Tomoshibi-technology/MovingDisplay3-Circuit/買い物リスト2.xlsx

種類 | 備考 | 備考 | 備考 | 1台当たりの個数 | 在庫 | 購入数 | 単価 | 小計 | URL
積セラ | 10uF | 50V | 2012 |  |  | 20 | 0.067 | 1.34 | https://lcsc.com/product-detail/Multilayer-Ceramic-Capacitors-MLCC-SMD-SMT_muRata-GRM21BR61H106KE43L_C440198.html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
積セラ | 100uF | 6.3V | 3216 |  |  | 20 | 0.067 | 1.34 | https://lcsc.com/product-detail/Multilayer-Ceramic-Capacitors-MLCC-SMD-SMT_Samsung-Electro-Mechanics-CL31A107MQHNNNE_C15008.html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
ヒューズボックス | ミゼット |  | 3568 | 1 | 4 | 5 | 1.2 | 6 | https://www.digikey.jp/ja/products/detail/keystone-electronics/3568/2137306
DF40コネクタ |  |  | DF40C-60DS-0.4V(51) | 2 | 4 | 10 | 0.4304 | 4.304 | https://lcsc.com/product-detail/Board-to-Board-and-Backplane-Connector_HRS-Hirose-DF40C-60DS-0-4V-51_C597938.html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
DF40コネクタ |  |  | DF40C-100DS-0.4V(51) | 2 | 4 | 10 | 0.7947 | 7.947 | https://lcsc.com/product-detail/Board-to-Board-and-Backplane-Connector_HRS-Hirose-DF40C-100DS-0-4V-51_C597931.html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
ボックスヘッダ | ヘッダ | 2 x 7P / H / 1.27mm / THT | 3220-14-0200-00 | 9 | 9 | 40 | 0.977 | 39.08 | https://www.digikey.jp/ja/products/detail/cnc-tech/3220-14-0200-00/3882957
MiniSPOX | ポスト | 2P / V | 22035025 | 4 | 9 | 30 | 0.165 | 4.95 | https://www.digikey.jp/ja/products/detail/molex/0022035025/403301?s=N4IgTCBcDa5gDAZgKzzMkBdAvkA
MiniSPOX | ポスト | 2P / H | 22057025 | 9 | 16 | 50 | 0.177 | 8.85 | https://www.digikey.jp/ja/products/detail/molex/0022057025/403341?s=N4IgTCBcDa5gDAVgOzzIkBdAvkA
MiniSPOX | ポスト | 3P / H | 22057035 | 4 | 50くらい | 0 |  | 0 | https://lcsc.com/product-detail/Wire-To-Board-Connector_MOLEX-22057035_C185225.html?s_z=n_MOLEX%252022057035
MiniSPOX | ハウジング | 2P | 50375023 | 13 | 25 | 80 | 0.0219 | 1.752 | https://lcsc.com/product-detail/Housings-Wire-To-Board-Wire-To-Wire_MOLEX-50375023_C142370.html?s_z=n_spox
MiniSPOX | ハウジング | 3P | 50375033 | 4 | 50くらい | 0 |  | 0 | https://lcsc.com/product-detail/Housings-Wire-To-Board-Wire-To-Wire_MOLEX-50375033_C293596.html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
MiniSPOX | コンタクト |  | 8701039 |  |  | 0 |  | 0
PicoBlade | ポスト | 2P / H |  | 2 |  | 50 | 0.0148 | 0.74 | https://lcsc.com/product-detail/Wire-To-Board-Connector_Hong-Cheng-HCZZ0001-2_C7433453.html?s_z=n_C7433453
PicoBlade | ポスト | 3P / V |  | 1 |  | 20 | 0.0184 | 0.368 | https://lcsc.com/product-detail/Wire-To-Board-Connector_Hong-Cheng-HCZZ0015-3_C7433469.html?s_z=n_C7433469
PicoBlade | ポスト | 3P / H |  | 1 |  | 50 | 0.0176 | 0.88 | https://lcsc.com/product-detail/Wire-To-Board-Connector_Hong-Cheng-HCZZ0001-3_C7433454.html?s_z=n_C7433454
PicoBlade | ポスト | 4P / H |  | 1 |  | 20 | 0.0212 | 0.424 | https://lcsc.com/product-detail/Wire-To-Board-Connector_Hong-Cheng-HCZZ0001-4_C7433455.html?s_z=n_C7433455
PicoBlade | ポスト | 5P / H |  | 10 | 19 | 40 | 0.0241 | 0.964 | https://lcsc.com/product-detail/Wire-To-Board-Connector_Hong-Cheng-HCZZ0001-5_C7433456.html?s_z=n_C7433456
PicoBlade | ポスト | 6P / V |  | 2 | 50 | 0 | 0.0284 | 0 | https://lcsc.com/product-detail/Wire-To-Board-Connector_Hong-Cheng-HCZZ0015-6_C7433472.html?s_z=n_C7433472
PicoBlade | ポスト | 6P / H |  | 4 | 56 | 0 | 0.0275 | 0 | https://lcsc.com/product-detail/Wire-To-Board-Connector_Hong-Cheng-HCZZ0001-6_C7433457.html?s_z=n_C7433457
PicoBlade | ポスト | 8P / V |  | 2 |  | 20 | 0.0338 | 0.676 | https://lcsc.com/product-detail/Wire-To-Board-Connector_Hong-Cheng-HCZZ0015-8_C7433474.html?s_z=n_C7433474
PicoBlade | ポスト | 8P / H |  | 1 |  | 20 | 0.0323 | 0.646 | https://lcsc.com/product-detail/Wire-To-Board-Connector_Hong-Cheng-HCZZ0001-8_C7433459.html?s_z=n_C7433459
PicoBlade | ハウジング | 2P |  | 2 |  | 50 | 0.0139 | 0.695 | https://lcsc.com/product-detail/Housings-Wire-To-Board-Wire-To-Wire_MOLEX-510210200_C293613.html?s_z=n_C293613
PicoBlade | ハウジング | 3P |  | 2 |  | 15 | 0.136 | 2.04 | https://www.digikey.jp/ja/products/detail/molex/0510210300/242843?s=N4IgTCBcDaIKwEYAMZkGYlJAXQL5A
PicoBlade | ハウジング | 4P |  | 1 |  | 50 | 0.0201 | 1.005 | https://lcsc.com/product-detail/Housings-Wire-To-Board-Wire-To-Wire_MOLEX-510210400_C504988.html?s_z=n_C504988
PicoBlade | ハウジング | 5P |  | 10 | 20 | 40 | 0.0268 | 1.072 | https://lcsc.com/product-detail/Housings-Wire-To-Board-Wire-To-Wire_MOLEX-510210500_C192632.html?s_z=n_C192632
PicoBlade | ハウジング | 6P |  | 6 | 50 | 0 | 0.0251 | 0 | https://lcsc.com/product-detail/Housings-Wire-To-Board-Wire-To-Wire_MOLEX-510210600_C385105.html?s_z=n_C385105
PicoBlade | ハウジング | 8P |  | 3 |  | 40 | 0.0243 | 0.972 | https://lcsc.com/product-detail/Housings-Wire-To-Board-Wire-To-Wire_MOLEX-510210800_C385106.html?s_z=n_C385106
PicoBlade | コンタクト |  |  |  |  | 750 | 0.0072 | 5.4 | https://lcsc.com/product-detail/Housing-Contact_MOLEX-500798001_C20003452.html?s_z=n_500798001
コイル | 1uH |  | 3225 | 1 |  | 10 | 0.271 | 2.71 | https://www.digikey.jp/ja/products/detail/vishay-dale/IHLP1210BZEZ1R0M5A/25589291
コイル | 3.3uH |  |  | 1 |  | 10 | 0.425 | 4.25 | https://www.digikey.jp/ja/products/detail/ecs-inc/ECS-MPIL0530-3R3MC/8021589
NchFET | 中電流用 | 中耐圧 | TPN11006PL | 24 | 94 | 40 | 0.696 | 27.84 | https://www.digikey.jp/ja/products/detail/toshiba-semiconductor-and-storage/TPN11006PL-LQ/10447100
PchFET | 中電流用 | 中耐圧 | DI035P04PT | 8 | 8 | 40 | 0.548 | 21.92 | https://www.digikey.jp/ja/products/detail/diotec-semiconductor/DI035P04PT/16640416
PchFET | 大電流用 | 中耐圧 | SQS141ELNW | 2 |  | 16 | 0.927 | 14.832 | https://www.digikey.jp/ja/products/detail/vishay-siliconix/SQS141ELNW-T1-GE3/16639865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
抵抗 | 100Ω |  | 1005 |  |  | 100 | 0.0006 | 0.06 | https://lcsc.com/product-detail/Chip-Resistor-Surface-Mount_UNI-ROYAL-0402WGF1000TCE_C25076.html?s_z=n_c25076
抵抗 | 330Ω |  | 1005 |  |  | 100 | 0.0006 | 0.06 | https://lcsc.com/product-detail/Chip-Resistor-Surface-Mount_UNI-ROYAL-0402WGF3300TCE_C25104.html?s_z=n_c25104
抵抗 | 510Ω |  | 1005 |  |  | 100 | 0.0006 | 0.06 | https://lcsc.com/product-detail/Chip-Resistor-Surface-Mount_UNI-ROYAL-0402WGF5100TCE_C25123.html?s_z=n_c25123
抵抗 | 0.1Ω |  | 2012 | 2 |  | 100 | 0.0042 | 0.42 | https://lcsc.com/product-detail/Chip-Resistor-Surface-Mount_UNI-ROYAL-0805W8F100LT5E_C127687.html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
スイッチ | スライド | SPDT / SMD / 小 / 横 / 黒 | SSAJ120100 | 5 | 3 | 30 | 0.4011 | 12.033 | https://lcsc.com/product-detail/Slide-Switches_ALPSALPINE-SSAJ120100_C160864.html?s_z=n_SSAJ120100
スイッチ | スライド | DPDT / SMD / 小 / 縦 / 黒 | SSSS820101 | 7 | 4 | 50 | 0.2103 | 10.515 | https://lcsc.com/product-detail/Slide-Switches_ALPSALPINE-SSSS820101_C97434.html?s_z=n_SSSS820101%2520
スイッチ | 4PDIP | SPST x 4 / SMD |  | 8 | 3 | 50 | 0.27 | 13.5 | https://lcsc.com/product-detail/DIP-Switches_hanxia-HX-1-27-4P-TPPT_C7430300.html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
IC | エンコーダー |  | AS5047P | 4 | 9 | 15 | 3.109 | 46.635 | https://lcsc.com/product-detail/Position-Sensors_AMS-AS5047P-ATSM_C962063.html
IC | DCDC |  | TPS54560B |  |  | 5 | 1.111 | 5.555 | https://lcsc.com/product-detail/DC-DC-Converters_TI-TPS54560BDDAR_C1850354.html?s_z=n_C1850354
 |  |  |  |  |  |  | 合計(ドル) | 251.835
 |  |  |  |  |  | 148.49 | 合計(円) | 37394.97915
