Tomoshibi-technology/MovingDisplay3-Circuit/買い物リスト3.xlsx

種類 | 備考 | 備考 | 備考 | 1台当たりの個数 | 購入数 | 単価 | 小計 | URL
積セラ | 10uF | 35V | 2012 | 8 | 4 | 150 | 600 | https://akizukidenshi.com/catalog/g/g113336/
積セラ | 22uF | 25V | 2012 | 4 | 2 | 120 | 240 | https://akizukidenshi.com/catalog/g/g108240/
電解コン | 47uF | 25V |  | 6 | 5 | 90 | 450 | https://akizukidenshi.com/catalog/g/g117577/
電解コン | 100uF | 25V |  | 10 | 50 | 10 | 500 | https://akizukidenshi.com/catalog/g/g117877/
電解コン | 330uF | 25V |  | 2 | 2 | 100 | 200 | https://akizukidenshi.com/catalog/g/g106978/
高分子コン | 330uF | 6.3V |  | 1 | 6 | 160 | 960 | https://akizukidenshi.com/catalog/g/g117295/
LED | 黄緑 |  |  | 5 | 2 | 100 | 200 | https://akizukidenshi.com/catalog/g/g111877/
LED | 緑 |  |  | 19 | 9 | 100 | 900 | https://akizukidenshi.com/catalog/g/g111878/
LED | 青 |  |  | 34 | 3 | 200 | 600 | https://akizukidenshi.com/catalog/g/g103982
LED | 青 |  |  | 34 | 1 | 800 | 800 | https://akizukidenshi.com/catalog/g/g111811/
ショットキー | 2A |  | SS2040FL | 31 | 6 | 480 | 2880 | https://akizukidenshi.com/catalog/g/g102073/
ショットキー | 10A |  | MA10EB045 | 1 | 3 | 80 | 240 | https://akizukidenshi.com/catalog/g/g117496/
ショットキー | 小信号 |  | CUS10F30 | 5 | 2 | 150 | 300 | https://akizukidenshi.com/catalog/g/g107687/
コイル | 1uH | 1608 |  | 7 | 6 | 110 | 660 | https://akizukidenshi.com/catalog/g/g114975/
ピンヘッダ | ヘッダ | 2 x 13P / V / 1.27mm / THT |  | 4 | 20 | 50 | 1000 | https://akizukidenshi.com/catalog/g/g113802/
ピンソケット | ソケット | 2 x 13P / V / 1.27mm / THT |  | 4 | 20 | 70 | 1400 | https://akizukidenshi.com/catalog/g/g113808/
ピンヘッダ | ヘッダ | 1 x 10P / V / 1.27mm / THT |  | 1 | 2 | 90 | 180 | https://akizukidenshi.com/catalog/g/g103865/
ピンソケット | ソケット | 1 x 10P / V / 1.27mm / THT |  | 1 | 5 | 30 | 150 | https://akizukidenshi.com/catalog/g/g108695/
ピンヘッダ | ヘッダ | 2 x 10P / V / 1.27mm / THT |  | 1 | 5 | 45 | 225 | https://akizukidenshi.com/catalog/g/g113801/
ピンソケット | ソケット | 2 x 10P / V / 1.27mm / THT |  | 1 | 5 | 60 | 300 | https://akizukidenshi.com/catalog/g/g113807/
RJ45 |  |  | LPJK7001AGNL | 1 | 5 | 300 | 1500 | https://akizukidenshi.com/catalog/g/g116963/
PchFET | 中電流用 | 中耐圧 | SSM6J808RR | 8 | 8 | 100 | 800 | https://akizukidenshi.com/catalog/g/g115504/
PchFET | 大電流用 |  | MTP4835I3 | 2 | 5 | 30 | 150 | https://akizukidenshi.com/catalog/g/g116096/
NchFET | 中電流用 | 中耐圧 | SSM3K344R | 1 | 1 | 100 | 100 | https://akizukidenshi.com/catalog/g/g117434/
シャント抵抗 | 7mΩ | 1W |  | 12 | 5 | 50 | 250 | https://akizukidenshi.com/catalog/g/g106688/
抵抗 | 10Ω | 2W | 6332 | 2 | 1 | 140 | 140 | https://akizukidenshi.com/catalog/g/g109457/
スイッチ | タクト | SPST / THT / 小 / 横 / 白 |  | 4 | 4 | 100 | 400 | https://akizukidenshi.com/catalog/g/g114890/
スイッチ | タクト | SPST / SMD / 小 / 縦 / 白 | SKRPABE010 | 5 | 5 | 120 | 600 | https://akizukidenshi.com/catalog/g/g106184/
スイッチ | スライド | SPDT / THT / 大 / 縦 / 黒 | SS22F06G5-G | 1 | 5 | 30 | 150 | https://akizukidenshi.com/catalog/g/g103252/
三端子 | 3.3V |  | AZ1117CH | 7 | 30 | 30 | 900 | https://akizukidenshi.com/catalog/g/g116155/
コンパレータ |  |  | NJU7109 | 1 | 5 | 45 | 225 | https://akizukidenshi.com/catalog/g/g114720/
コンパレータ |  |  | NJU77242 | 1 | 5 | 70 | 350 | https://akizukidenshi.com/catalog/g/g114989/
オペアンプ |  |  | NJM2732 | 1 | 5 | 70 | 350 | https://akizukidenshi.com/catalog/g/g111238/
基準電圧源 |  |  | NJM2380 | 1 | 5 | 40 | 200 | https://akizukidenshi.com/catalog/g/g114049/
論理ゲート |  |  | 74AHC1G00 | 1 | 1 | 100 | 100 | https://akizukidenshi.com/catalog/g/g117600/
DAC |  |  | PT8211S | 1 | 5 | 100 | 500 | https://akizukidenshi.com/catalog/g/g117061/
FT231XS |  |  |  | 2 | 10 | 320 | 3200 | https://akizukidenshi.com/catalog/g/g106713/
TangPrimer 25K |  |  |  | 1 |  |  | 0
TweLite |  |  |  | 1 | 1 | 1450 | 1450 | https://akizukidenshi.com/catalog/g/g108263/
PIM573 |  |  |  | 1 |  |  | 0
 |  |  |  |  |  |  | 24150
