Tomoshibi-technology/MovingDisplay3-Circuit/買い物リスト1.xlsx

種類 | 備考 | 備考 | 備考 | 1枚当たりの個数 | 購入数 | 単価 | 小計 | URL
電解コン | 47uF | 25V |  | 5 | 2 | 90 | 180 | https://akizukidenshi.com/catalog/g/g117577/
LED | 青 |  |  | 6 | 1 | 200 | 200 | https://akizukidenshi.com/catalog/g/g103982/
LED | 黄緑 |  |  | 2 | 1 | 100 | 100 | https://akizukidenshi.com/catalog/g/g111877/
ショットキー | 小信号 |  | CUS10F30 | 1 | 1 | 150 | 150 | https://akizukidenshi.com/catalog/g/g107687/
ピンヘッダ | ヘッダ / V / THT | 1 x 10P / 1.27mm |  | 1 | 1 | 90 | 90 | https://akizukidenshi.com/catalog/g/g103865/
ピンヘッダ | ヘッダ / V / THT | 2 x 10P / 1.27mm |  | 1 | 2 | 45 | 90 | https://akizukidenshi.com/catalog/g/g113801/
ピンソケット | ソケット / V / THT | 2 x 10P / 1.27mm |  | 1 | 2 | 60 | 120 | https://akizukidenshi.com/catalog/g/g113807/
USB-C | Power Only |  |  | 1 | 5 | 70 | 350 | https://akizukidenshi.com/catalog/g/g116438/
スイッチ | タクト | SPST | SMD / 小 / 縦 / 白 | 4 | 1 | 120 | 120 | https://akizukidenshi.com/catalog/g/g106184/
スイッチ | タクト | SPST | THT / 小 / 縦 / 白 | 1 | 5 | 20 | 100 | https://akizukidenshi.com/catalog/g/g108074/
スイッチ | スライド | SPDT | THT / 中 / 横 / 白 | 1 | 5 | 25 | 125 | https://akizukidenshi.com/catalog/g/g115368/
スイッチ | スライド | SPDT | SMD / 中 / 縦 / 黒 | 1 | 1 | 330 | 330 | https://akizukidenshi.com/catalog/g/g105043/
FT231XS |  |  |  | 1 | 2 | 320 | 640 | https://akizukidenshi.com/catalog/g/g106713/
 |  |  |  |  |  | 総計 | 2595
