Tomoshibi-technology/MovingDisplay3-Circuit/circuits/DCDC/DCDC.xlsx

種類 | 備考 | 備考 | 備考 | 単価 | 1枚当たりの個数 | URL
電解コン | 100uF | 25V |  | 10 | 2 | https://akizukidenshi.com/catalog/g/g117877/
積セラ | 2700pF |  |  | 300 | 1 | https://akizukidenshi.com/catalog/g/g109291/
積セラ | 1500pF |  |  | 300 | 1 | https://akizukidenshi.com/catalog/g/g109288/
高分子コン | 330uF | 6.3V |  | 160 | 1 | https://akizukidenshi.com/catalog/g/g117295/
LED | 緑 |  |  | 100 | 2 | https://akizukidenshi.com/catalog/g/g111878/
ショットキー | 2A |  | SS2040FL | 480 | 2 | https://akizukidenshi.com/catalog/g/g102073/
MiniSPOX | ポスト | 2P / H | 22057025 |  | 5 | https://lcsc.com/product-detail/Wire-To-Board-Connector_MOLEX-22057025_C240819.html?s_z=n_spox
MiniSPOX | ハウジング | 2P | 50375023 |  | 5 | https://lcsc.com/product-detail/Housings-Wire-To-Board-Wire-To-Wire_MOLEX-50375023_C142370.html?s_z=n_spox
MiniSPOX | コンタクト |  | 8701039 |  | 10
PicoBlade | ポスト | 8P / H |  |  | 1 | https://lcsc.com/product-detail/Wire-To-Board-Connector_Hong-Cheng-HCZZ0001-8_C7433459.html?s_z=n_C7433459
PicoBlade | ハウジング | 8P |  |  | 1 | https://lcsc.com/product-detail/Housings-Wire-To-Board-Wire-To-Wire_MOLEX-510210800_C385106.html?s_z=n_C385106
PicoBlade | コンタクト |  |  |  | 22
コイル | 2.2uH |  |  |  | 1 | https://www.mouser.jp/ProductDetail/Panasonic/ETQ-P4M2R2KVK?qs=DddhjTRTMKxtDEQdd9aMKQ%3D%3D
フェライトビーズ | 1800Ω |  |  | 150 | 1 | https://akizukidenshi.com/catalog/g/g110765/
PchFET | 中電流用 | 中耐圧 | SSM6J808RR | 100 | 2 | https://akizukidenshi.com/catalog/g/g115504/
PchFET | 大電流用 |  | MTP4835I3 | 30 | 1 | https://akizukidenshi.com/catalog/g/g116096/
NchFET | 中電流用 | 中耐圧 | TPH11006NL | 200 | 2 | https://akizukidenshi.com/catalog/g/g107361/
スイッチ | スライド | SPDT / THT / 中 / 縦 / 白 | IS-1235-G | 25 | 1 | https://akizukidenshi.com/catalog/g/g115367/
三端子 | 12V |  | NJM78L12S | 30 | 1 | https://akizukidenshi.com/catalog/g/g111322/
オペアンプ |  |  | NJU77701 | 300 | 1 | https://akizukidenshi.com/catalog/g/g107103/
リセットIC |  |  | M51957B | 200 | 1 | https://akizukidenshi.com/catalog/g/g102284/
DCDC IC |  |  | LM3843 | 40 | 1 | https://akizukidenshi.com/catalog/g/g115555/
ゲトドラ |  |  | RT9624A | 60 | 1 | https://akizukidenshi.com/catalog/g/g129592/
