Tomoshibi-technology/MovingDisplay3-Circuit/circuits/Drive/Drive.xlsx

種類 | 備考 | 備考 | 備考 | 単価 | 1枚当たりの個数 | URL
電解コン | 47uF | 25V |  | 90 | 4 | https://akizukidenshi.com/catalog/g/g117577/
電解コン | 100uF | 25V |  | 10 | 2 | https://akizukidenshi.com/catalog/g/g117877/
LED | 緑 |  |  | 100 | 3 | https://akizukidenshi.com/catalog/g/g111878/
LED | 青 |  |  | 200 | 2 | https://akizukidenshi.com/catalog/g/g103982/
LED | 黄緑 |  |  | 100 | 1 | https://akizukidenshi.com/catalog/g/g111877/
LED | 赤 |  |  | 200 | 1 | https://akizukidenshi.com/catalog/g/g103978/
LED | 黄色 |  |  | 100 | 1 | https://akizukidenshi.com/catalog/g/g111880/
ショットキー | 小信号 |  | CUS10F30 | 150 | 1 | https://akizukidenshi.com/catalog/g/g107687/
ショットキー | 2A |  | SS2040FL | 480 | 1 | https://akizukidenshi.com/catalog/g/g102073/
ボックスヘッダ | ヘッダ | 2 x 7P / H / 1.27mm / THT |  |  | 1 | https://www.digikey.jp/ja/products/detail/cnc-tech/3220-14-0200-00/3882957
MiniSPOX | ポスト | 2P / H | 22057025 |  | 5 | https://lcsc.com/product-detail/Wire-To-Board-Connector_MOLEX-22057025_C240819.html?s_z=n_spox
MiniSPOX | ハウジング | 2P | 50375023 |  | 5 | https://lcsc.com/product-detail/Housings-Wire-To-Board-Wire-To-Wire_MOLEX-50375023_C142370.html?s_z=n_spox
MiniSPOX | コンタクト |  | 8701039 |  | 10
PicoBlade | ポスト | 5P / H |  |  | 2 | https://lcsc.com/product-detail/Wire-To-Board-Connector_Hong-Cheng-HCZZ0001-5_C7433456.html?s_z=n_C7433456
PicoBlade | ポスト | 6P / V |  |  | 2 | https://lcsc.com/product-detail/Wire-To-Board-Connector_Hong-Cheng-HCZZ0015-6_C7433472.html?s_z=n_C7433472
PicoBlade | ハウジング | 5P |  |  | 2 | https://lcsc.com/product-detail/Housings-Wire-To-Board-Wire-To-Wire_MOLEX-510210500_C192632.html?s_z=n_C192632
PicoBlade | ハウジング | 6P |  |  | 2 | https://lcsc.com/product-detail/Housings-Wire-To-Board-Wire-To-Wire_MOLEX-510210600_C385105.html?s_z=n_C385105
PicoBlade | コンタクト |  |  |  | 22
USB-C | Power Only |  |  | 70 | 1 | https://akizukidenshi.com/catalog/g/g116438/
コイル | 1uH | 1608 |  | 110 | 1 | https://akizukidenshi.com/catalog/g/g114975/
PchFET | 中電流用 | 中耐圧 | SSM6J808RR | 100 | 2 | https://akizukidenshi.com/catalog/g/g115504/
スイッチ | タクト | SPST / SMD /小 / 縦 / 白 | SKRPABE010 | 120 | 1 | https://akizukidenshi.com/catalog/g/g106184/
スイッチ | タクト | SPST / THT / 小 / 縦 / 白 |  | 20 | 1 | https://akizukidenshi.com/catalog/g/g108074/
スイッチ | スライド | SPDT / THT / 中 / 縦 / 白 | IS-1235-G | 25 | 1 | https://akizukidenshi.com/catalog/g/g115367/
スイッチ | スライド | SPDT / SMD / 中 / 縦 / 黒 | SSSS213202 | 330 | 1 | https://akizukidenshi.com/catalog/g/g105043/
スイッチ | 4PDIP | SPST x 4 / SMD |  |  | 1 | https://lcsc.com/product-detail/DIP-Switches_hanxia-HX-1-27-4P-TPPT_C7430300.html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
三端子 | 3.3V |  | AZ1117CH | 30 | 1 | https://akizukidenshi.com/catalog/g/g116155/
BNO055 |  |  |  |  | 1
PIM573 |  |  |  |  | 1
