Tomoshibi-technology/MovingDisplay3-Circuit/circuits/RasPi/RasPi.xlsx

種類 | 備考 | 備考 | 備考 | 単価 | 1枚当たりの個数 | URL
電解コン | 47uF | 25V |  | 90 | 1 | https://akizukidenshi.com/catalog/g/g117577/
高分子コン | 220uF | 6.3V |  | 120 | 1 | https://akizukidenshi.com/catalog/g/g117360/
積セラ | 10uF | 50V | 2012 |  | 2 | https://lcsc.com/product-detail/Multilayer-Ceramic-Capacitors-MLCC-SMD-SMT_muRata-GRM21BR61H106KE43L_C440198.html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
積セラ |  |  | 1608 |  | 2
LED | 緑 |  |  | 100 | 4 | https://akizukidenshi.com/catalog/g/g111878/
LED | 青 |  |  | 200 | 8 | https://akizukidenshi.com/catalog/g/g103982/
LED | 黄緑 |  |  | 100 | 3 | https://akizukidenshi.com/catalog/g/g111877/
LED | 赤 |  |  | 200 | 2 | https://akizukidenshi.com/catalog/g/g103978/
LED | 黄色 |  |  | 100 | 2 | https://akizukidenshi.com/catalog/g/g111880/
ショットキー | 小信号 |  | CUS10F30 | 150 | 3 | https://akizukidenshi.com/catalog/g/g107687/
ショットキー | 2A |  | SS2040FL | 480 | 1 | https://akizukidenshi.com/catalog/g/g102073/
ショットキー | 10A |  | MA10EB045 | 80 | 1 | https://akizukidenshi.com/catalog/g/g117496/
ボックスヘッダ | ヘッダ | 2 x 7P / H / 1.27mm / THT |  |  | 1 | https://www.digikey.jp/ja/products/detail/cnc-tech/3220-14-0200-00/3882957
PicoBlade | ポスト | 2P / H |  |  | 2 | https://lcsc.com/product-detail/Wire-To-Board-Connector_Hong-Cheng-HCZZ0001-2_C7433453.html?s_z=n_C7433453
PicoBlade | ポスト | 3P / V |  |  | 1 | https://lcsc.com/product-detail/Wire-To-Board-Connector_Hong-Cheng-HCZZ0015-3_C7433469.html?s_z=n_C7433469
PicoBlade | ポスト | 3P / H |  |  | 1 | https://lcsc.com/product-detail/Wire-To-Board-Connector_Hong-Cheng-HCZZ0001-3_C7433454.html?s_z=n_C7433454
PicoBlade | ポスト | 4P / H |  |  | 1 | https://lcsc.com/product-detail/Wire-To-Board-Connector_Hong-Cheng-HCZZ0001-4_C7433455.html?s_z=n_C7433455
PicoBlade | ポスト | 6P / H |  |  | 2 | https://lcsc.com/product-detail/Wire-To-Board-Connector_Hong-Cheng-HCZZ0001-6_C7433457.html?s_z=n_C7433457
PicoBlade | ポスト | 8P / H |  |  | 1 | https://lcsc.com/product-detail/Wire-To-Board-Connector_Hong-Cheng-HCZZ0001-8_C7433459.html?s_z=n_C7433459
PicoBlade | ハウジング | 2P |  |  | 2 | https://lcsc.com/product-detail/Housings-Wire-To-Board-Wire-To-Wire_MOLEX-510210200_C293613.html?s_z=n_C293613
PicoBlade | ハウジング | 3P |  |  | 2 | https://lcsc.com/product-detail/Housings-Wire-To-Board-Wire-To-Wire_MOLEX-510210300_C122445.html?s_z=n_C122445
PicoBlade | ハウジング | 4P |  |  | 1 | https://lcsc.com/product-detail/Housings-Wire-To-Board-Wire-To-Wire_MOLEX-510210400_C504988.html?s_z=n_C504988
PicoBlade | ハウジング | 6P |  |  | 2 | https://lcsc.com/product-detail/Housings-Wire-To-Board-Wire-To-Wire_MOLEX-510210600_C385105.html?s_z=n_C385105
PicoBlade | ハウジング | 8P |  |  | 1 | https://lcsc.com/product-detail/Housings-Wire-To-Board-Wire-To-Wire_MOLEX-510210800_C385106.html?s_z=n_C385106
PicoBlade | コンタクト
XH | ポスト | 2P |  |  | 1
XH | ハウジング | 2P |  |  | 1
XH | コンタクト
ピンソケット | ソケット / V / THT | 1 x 5P / 2.54mm |  |  | 1
RJ45 |  |  | LPJK7001AGNL | 300 | 1 | https://akizukidenshi.com/catalog/g/g116963/
コイル | 1uH |  | 1608 | 110 | 1 | https://akizukidenshi.com/catalog/g/g114975/
コイル | 1uH |  | 3225 |  | 1 | https://www.digikey.jp/ja/products/detail/vishay-dale/IHLP1210BZEZ1R0M5A/25589291
コイル | 3.3uH |  |  |  | 1 | https://www.digikey.jp/ja/products/detail/ecs-inc/ECS-MPIL0530-3R3MC/8021589
PchFET | 中電流用 | 中耐圧 | SSM6J808R | 100 | 2 | https://akizukidenshi.com/catalog/g/g115504/
PchFET | 大電流用 |  | MTP4835I3 | 30 | 2 | https://akizukidenshi.com/catalog/g/g116096/
NchFET | 中電流用 | 中耐圧 | SSM3K344R | 100 | 1 | https://akizukidenshi.com/catalog/g/g117434/
抵抗 | 10Ω | 2W | 6332 | 140 | 2 | https://akizukidenshi.com/catalog/g/g109457/
抵抗 | 0.1Ω |  | 2012 |  | 2 | https://lcsc.com/product-detail/Chip-Resistor-Surface-Mount_UNI-ROYAL-0805W8F100LT5E_C127687.html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
スイッチ | タクト | SPST / SMD /小 / 縦 / 白 | SKRPABE010 | 120 | 1 | https://akizukidenshi.com/catalog/g/g106184/
スイッチ | タクト | SPST / SMD / 中 / 縦 / 黒 |  | 15 | 1 | https://akizukidenshi.com/catalog/g/g103647/
スイッチ | スライド | DPDT / SMD / 小 / 縦 / 黒 | SSSS820101 |  | 2 | https://lcsc.com/product-detail/Slide-Switches_ALPSALPINE-SSSS820101_C97434.html?s_z=n_SSSS820101%2520
スイッチ | スライド | SPDT / SMD / 中 / 縦 / 黒 | SSSS213202 | 330 | 1 | https://akizukidenshi.com/catalog/g/g105043/
スイッチ | スライド | SPST / THT / 中 / 縦 / 黒 |  | 20 | 1 | https://akizukidenshi.com/catalog/g/g115707/
スイッチ | 4PDIP | SPST x 4 / SMD |  |  | 1 | https://lcsc.com/product-detail/DIP-Switches_hanxia-HX-1-27-4P-TPPT_C7430300.html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
Raspberry Pi CM4 |  |  |  |  | 1
FT231XS |  |  |  | 320 | 1 | https://akizukidenshi.com/catalog/g/g106713/
TangPrimer 25K |  |  |  |  | 1
三端子 | 3.3V |  | AZ1117CH | 30 | 1 | https://akizukidenshi.com/catalog/g/g116155/
コンパレータ |  |  | NJU7109 | 45 | 1 | https://akizukidenshi.com/catalog/g/g114720/
コンパレータ |  |  | NJU77242 | 70 | 1 | https://akizukidenshi.com/catalog/g/g114989/
オペアンプ |  |  | NJM2732 | 70 | 1 | https://akizukidenshi.com/catalog/g/g111238/
基準電圧源 |  |  | NJM2380 | 40 | 1 | https://akizukidenshi.com/catalog/g/g114049/
論理ゲート |  |  | 74AHC1G00 | 100 | 1 | https://akizukidenshi.com/catalog/g/g117600/
DAC |  |  | PT8211S | 100 | 1 | https://akizukidenshi.com/catalog/g/g117061/
