Tomoshibi-technology/MovingDisplay3-Circuit/circuits/Imposition/1stLayer_Power/1stLayer_Power.xlsx

種類 | 備考 | 備考 | 備考 | 単価 | 1枚当たりの個数 | URL
電解コン | 330uF | 25V |  |  | 2 | https://akizukidenshi.com/catalog/g/g106978/
LED | 緑 |  |  | 100 | 1 | https://akizukidenshi.com/catalog/g/g111878/
ショットキー | 小信号 |  | CUS10F30 | 150 | 1 | https://akizukidenshi.com/catalog/g/g107687/
ヒューズボックス | ミゼット |  |  |  | 1 | https://www.digikey.jp/ja/products/detail/keystone-electronics/3568/2137306
ボックスヘッダ | ヘッダ | 2 x 7P / H / 1.27mm / THT |  |  | 3 | https://www.digikey.jp/ja/products/detail/cnc-tech/3220-14-0200-00/3882957
ピンソケット | ソケット | 1 x 10P / V / 1.27mm / THT |  |  | 1 | https://akizukidenshi.com/catalog/g/g108695/
XT30 |  |  |  |  | 1
MiniSPOX | ポスト | 2P / V | 22035025 |  | 4 | https://lcsc.com/product-detail/Wire-To-Board-Connector_MOLEX-22057025_C240819.html?s_z=n_spox
MiniSPOX | ハウジング | 2P | 50375023 |  | 4 | https://lcsc.com/product-detail/Housings-Wire-To-Board-Wire-To-Wire_MOLEX-50375023_C142370.html?s_z=n_spox
MiniSPOX | コンタクト |  | 8701039
PicoBlade | ポスト | 8P / V |  |  | 2 | https://lcsc.com/product-detail/Wire-To-Board-Connector_Hong-Cheng-HCZZ0015-8_C7433474.html?s_z=n_C7433474
PicoBlade | ハウジング | 8P |  |  | 2 | https://lcsc.com/product-detail/Housings-Wire-To-Board-Wire-To-Wire_MOLEX-510210800_C385106.html?s_z=n_C385106
PicoBlade | コンタクト
PchFET | 大電流用 | 中耐圧 | SQS141ELNW |  | 2 | https://www.digikey.jp/ja/products/detail/vishay-siliconix/SQS141ELNW-T1-GE3/16639865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
スイッチ | スライド | SPDT / THT / 大 / 縦 / 黒 | SS22F06G5-G |  | 1 | https://akizukidenshi.com/catalog/g/g103252/
