Tomoshibi-technology/MovingDisplay3-Circuit/circuits/Imposition/2ndLayer_3rdLayer/2ndLayer_3rdLayer.xlsx

種類 | 備考 | 備考 | 備考 | 単価 | 1枚当たりの個数 | URL
電解コン | 47uF | 25V |  | 90 | 1 | https://akizukidenshi.com/catalog/g/g117577/
LED | 緑 |  |  | 100 | 3 | https://akizukidenshi.com/catalog/g/g111878/
LED | 青 |  |  | 200 | 4 | https://akizukidenshi.com/catalog/g/g103982/
LED | 黄緑 |  |  | 100 | 1 | https://akizukidenshi.com/catalog/g/g111877/
LED | 赤 |  |  | 200 | 1 | https://akizukidenshi.com/catalog/g/g103978/
LED | 黄色 |  |  | 100 | 1 | https://akizukidenshi.com/catalog/g/g111880/
ショットキー | 2A |  | SS2040FL | 480 | 1 | https://akizukidenshi.com/catalog/g/g102073/
ピンヘッダ | ヘッダ | 1 x 10P / V / 1.27mm / THT |  | 90 | 1 | https://akizukidenshi.com/catalog/g/g103865/
ピンヘッダ | ヘッダ | 2 x 10P / V / 1.27mm / THT |  | 45 | 1 | https://akizukidenshi.com/catalog/g/g113801/
ピンソケット | ソケット | 2 x 10P / V / 1.27mm / THT |  | 60 | 1 | https://akizukidenshi.com/catalog/g/g113807/
PicoBlade | ポスト | 6P / H |  |  | 2 | https://lcsc.com/product-detail/Wire-To-Board-Connector_Hong-Cheng-HCZZ0001-6_C7433457.html?s_z=n_C7433457
PicoBlade | ハウジング | 6P |  |  | 2 | https://lcsc.com/product-detail/Housings-Wire-To-Board-Wire-To-Wire_MOLEX-510210600_C385105.html?s_z=n_C385105
PicoBlade | コンタクト |  |  |  | 12
コイル | 1uH | 1608 |  | 110 | 1 | https://akizukidenshi.com/catalog/g/g114975/
PchFET | 中電流用 | 中耐圧 | SSM6J808RR | 100 | 2 | https://akizukidenshi.com/catalog/g/g115504/
スイッチ | タクト | SPST / SMD / 小 / 縦 / 白 | SKRPABE010 | 120 | 3 | https://akizukidenshi.com/catalog/g/g106184/
スイッチ | タクト | SPST / SMD / 中 / 縦 / 黒 |  | 15 | 3 | https://akizukidenshi.com/catalog/g/g103647/
スイッチ | スライド | SPDT / THT / 中 / 横 / 白 | IS-1245T-G | 25 | 1 | https://akizukidenshi.com/catalog/g/g115368/
スイッチ | スライド | SPDT / SMD / 小 / 横 / 黒 | SSAJ120100 |  | 1 | https://lcsc.com/product-detail/Slide-Switches_ALPSALPINE-SSAJ120100_C160864.html?s_z=n_SSAJ120100
スイッチ | スライド | SPDT / SMD / 小 / 縦 / 黒 | SSSS820101 |  | 1 | https://lcsc.com/product-detail/Slide-Switches_ALPSALPINE-SSSS820101_C97434.html?s_z=n_SSSS820101%2520
スイッチ | 4PDIP | SPST x 4 / SMD |  |  | 2 | https://lcsc.com/product-detail/DIP-Switches_hanxia-HX-1-27-4P-TPPT_C7430300.html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
三端子 | 3.3V |  | AZ1117CH | 30 | 1 | https://akizukidenshi.com/catalog/g/g116155/
TweLite |  |  |  | 1450 | 1 | https://akizukidenshi.com/catalog/g/g108263/
OLED |  |  |  | 580 | 1 | https://akizukidenshi.com/catalog/g/g112031/
FT231XS |  |  |  | 320 | 1 | https://akizukidenshi.com/catalog/g/g106713/
