Tomoshibi-technology/MovingDisplay3-Circuit/circuits/Drive/Drive.pdf

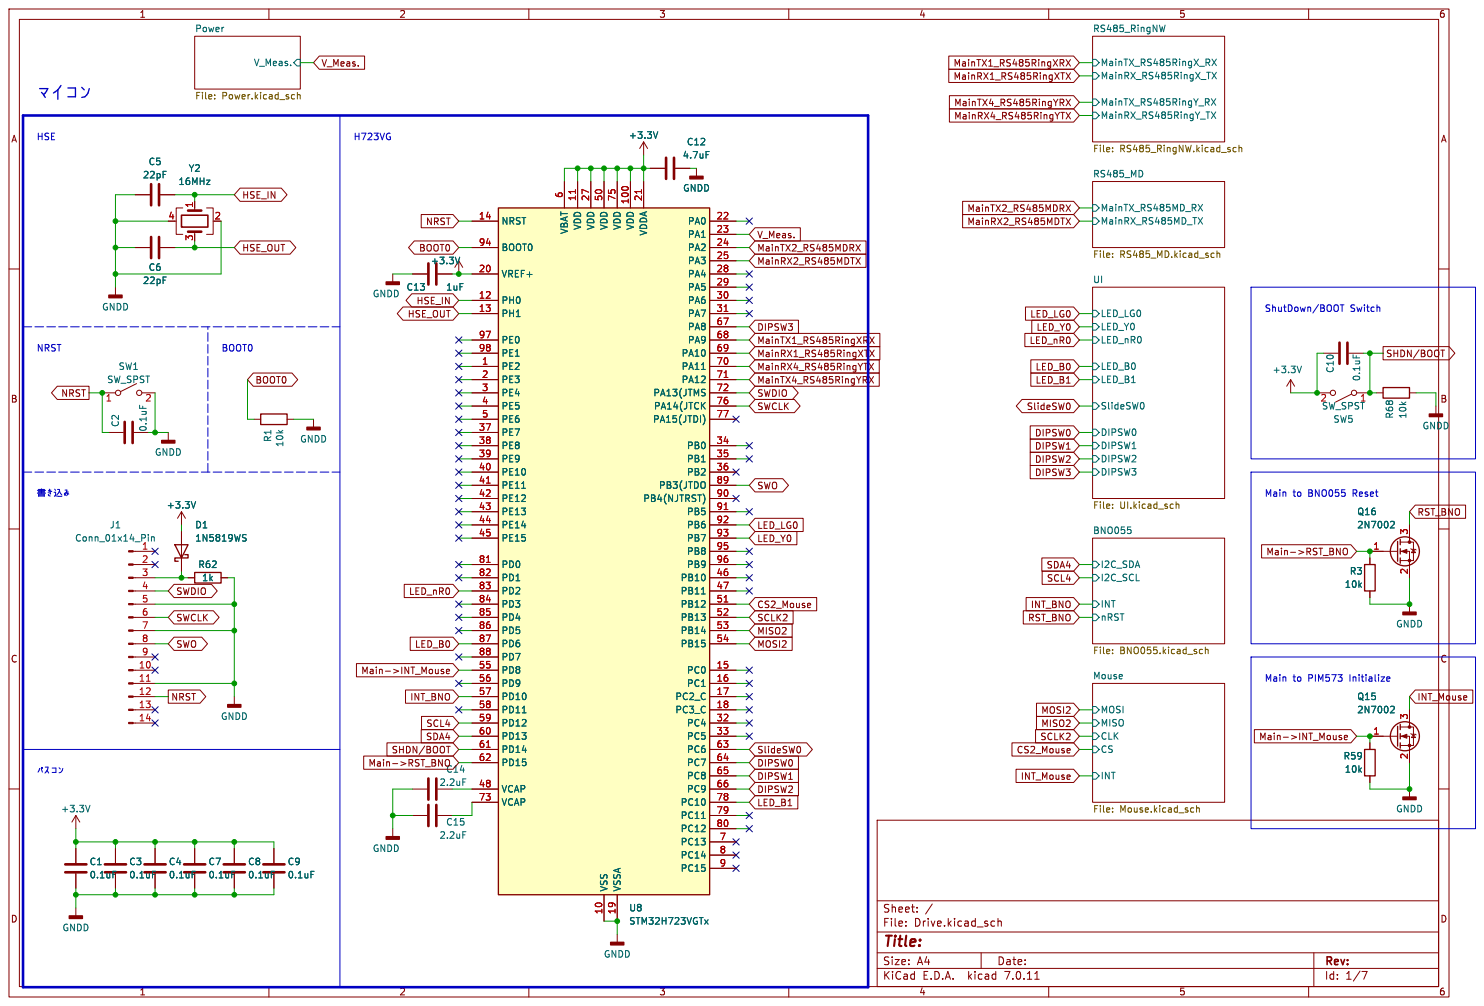
[picture p1: page 1]

INT Mouse File: Mouse.kicad_sch

Id: 1/7 Title: File: Drive.kicad_sch Sheet: /

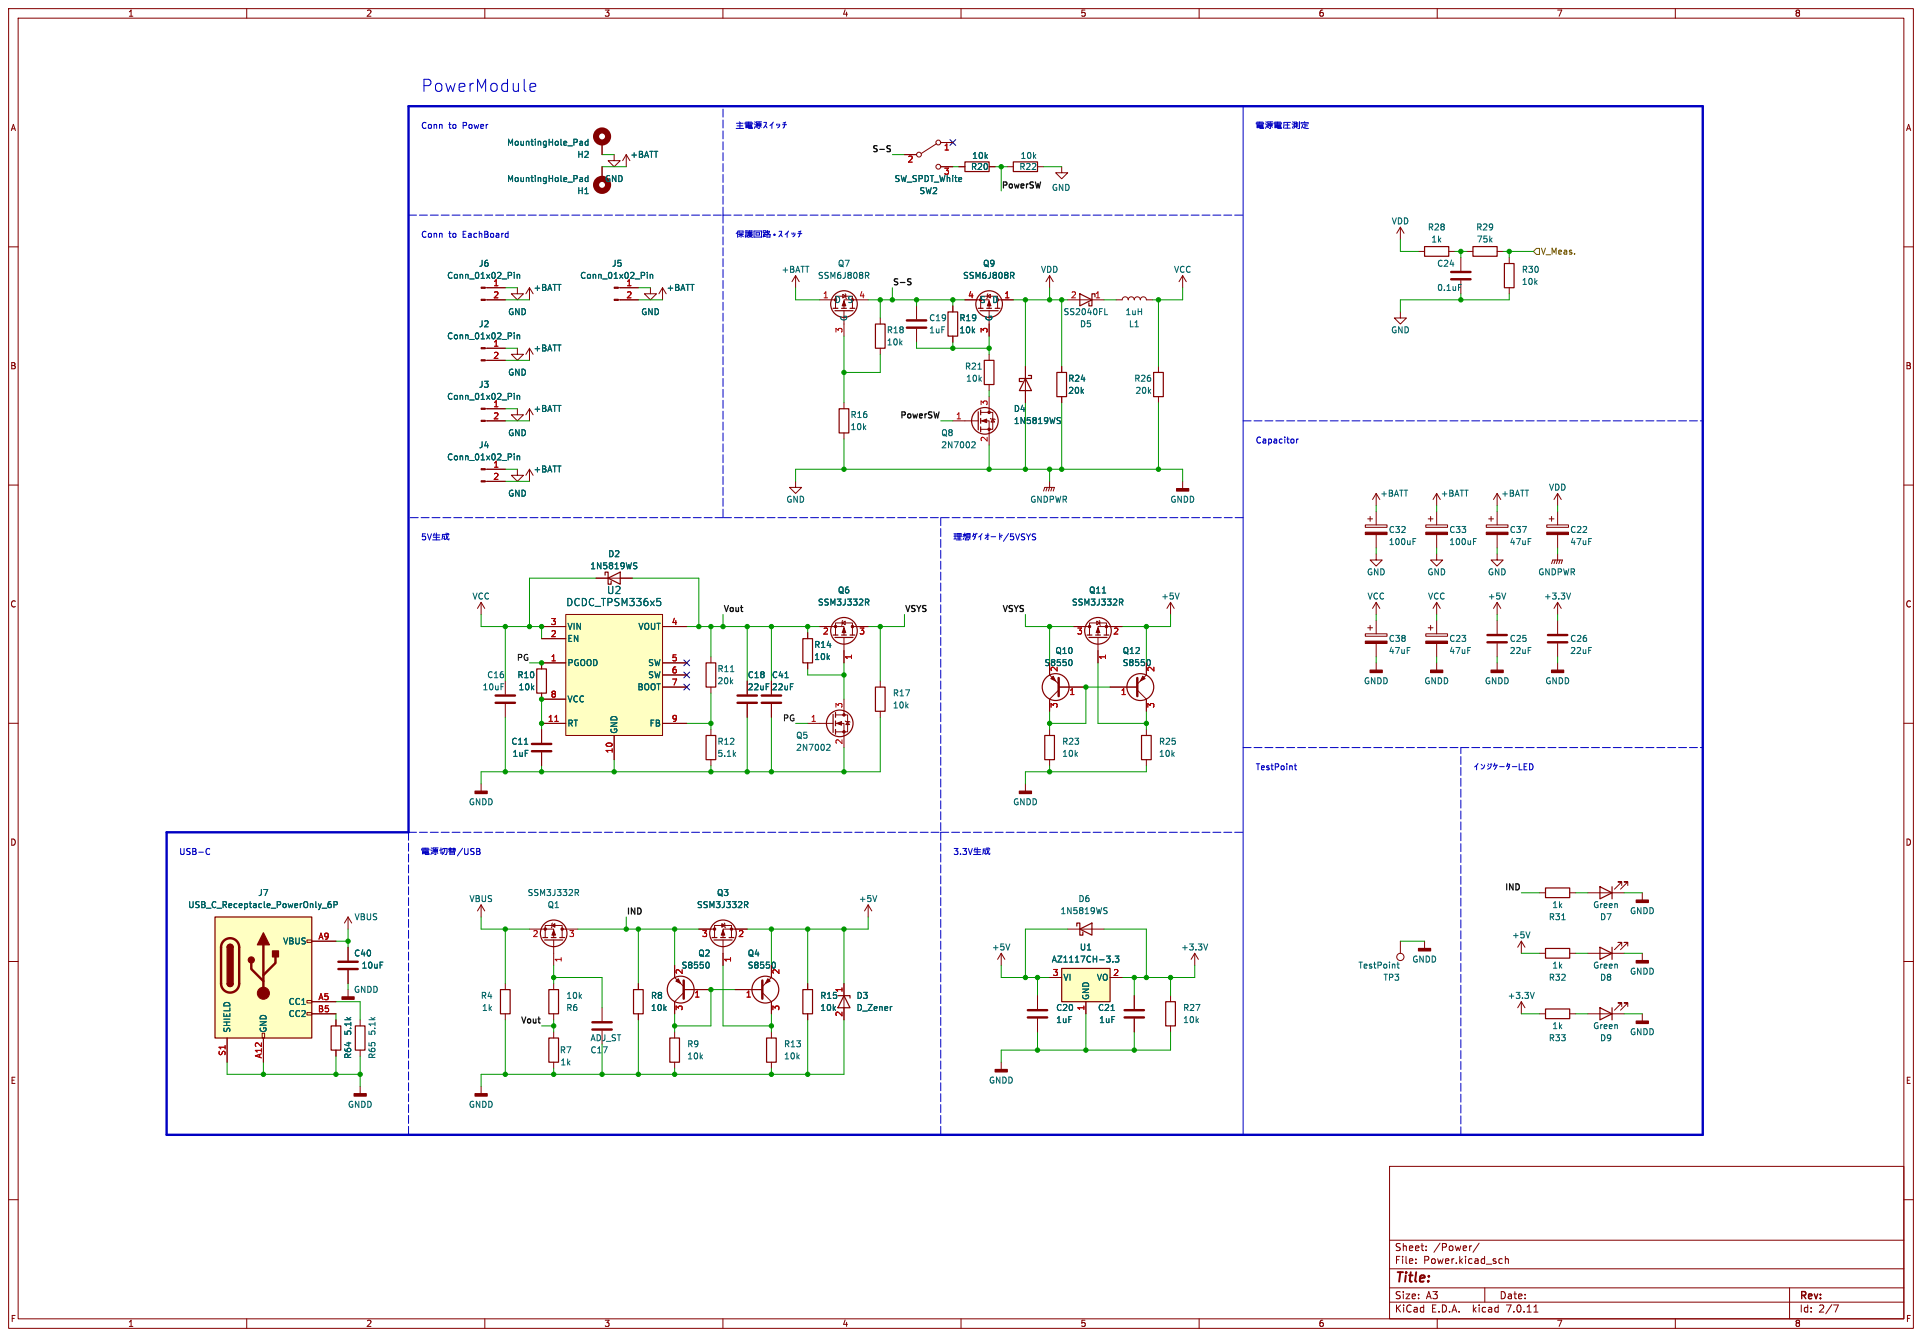
[picture p2: page 2]

PowerModule
Conn to EachBoard Conn to Power þÿ5Vub
H2 MountingHole_Pad +BATT
3 +BATT

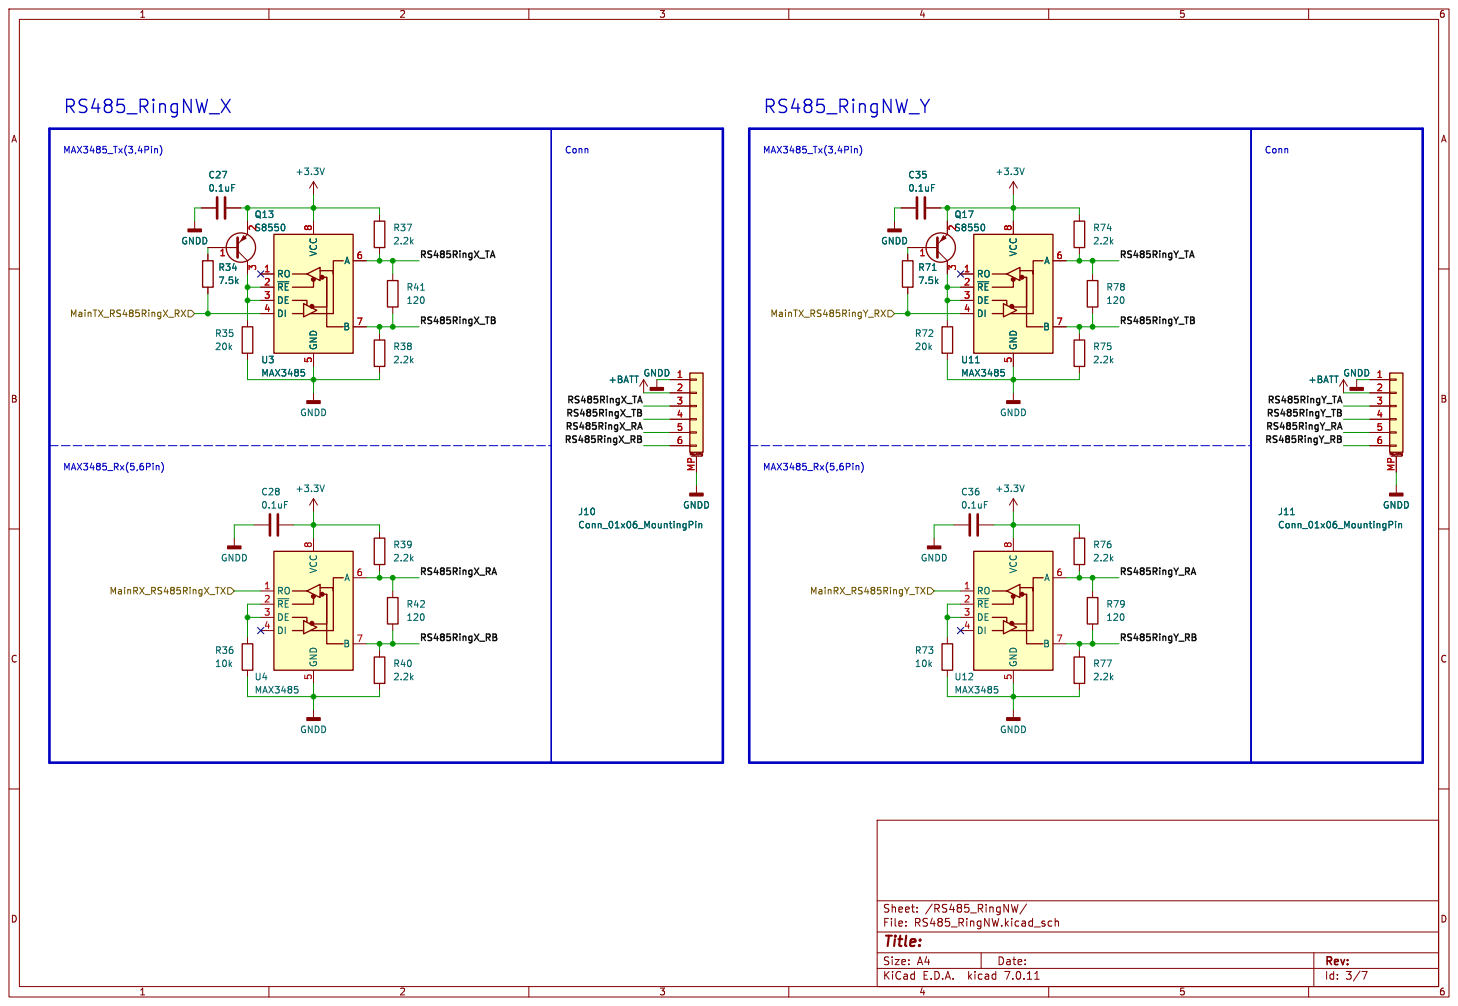
[picture p3: page 3]

Id: 3/7 Title: File: RS485_RingNW.kicad_sch Sheet: /RS485_RingNW/ R42

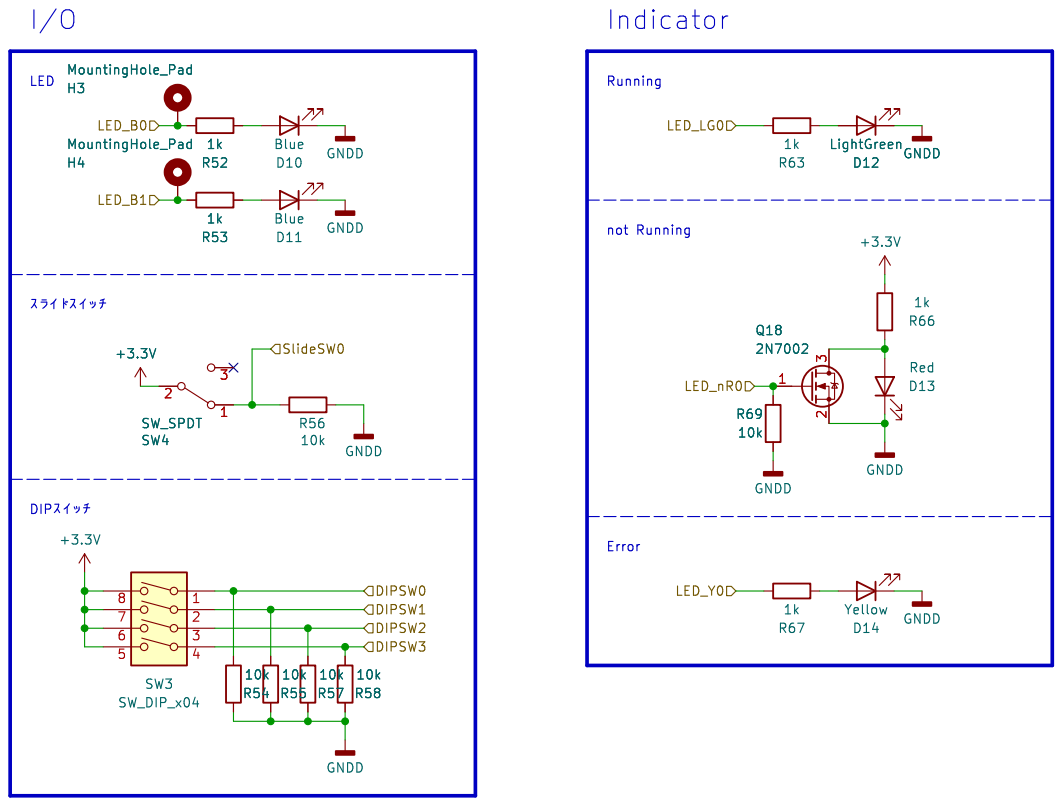
[picture p4: page 4]

Id: 4/7 Title: File: UI.kicad_sch Sheet: /UI/

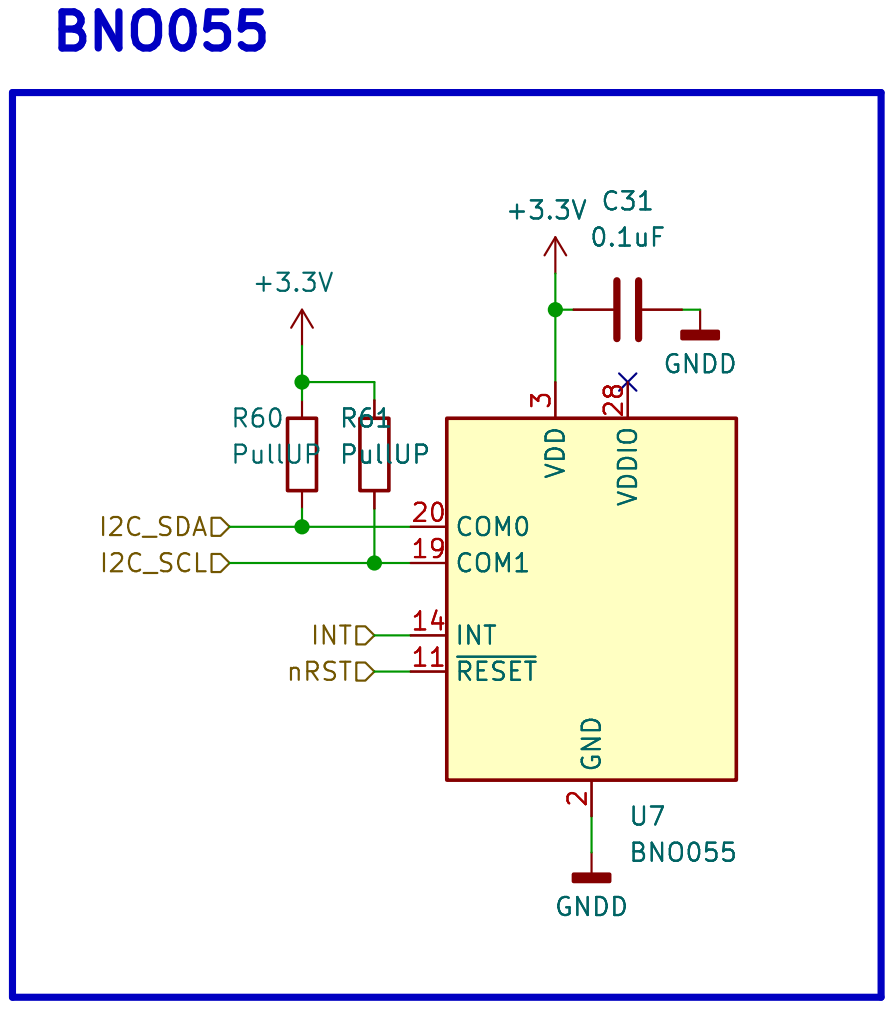
[picture p5: page 5]

Id: 5/7 Title: File: BNO055.kicad_sch Sheet: /BNO055/

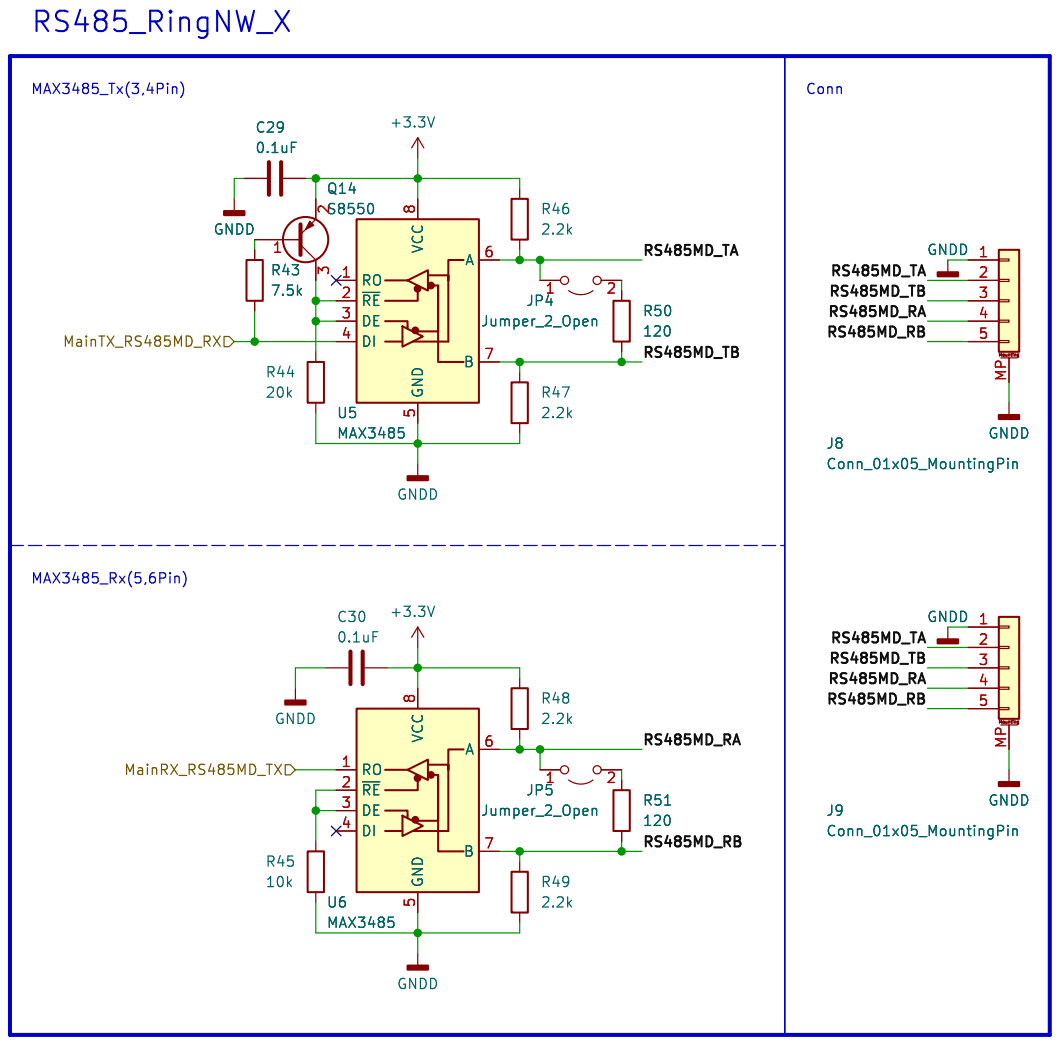
[picture p6: page 6]

Id: 7/7 Title: File: RS485_MD.kicad_sch Sheet: /RS485_MD/

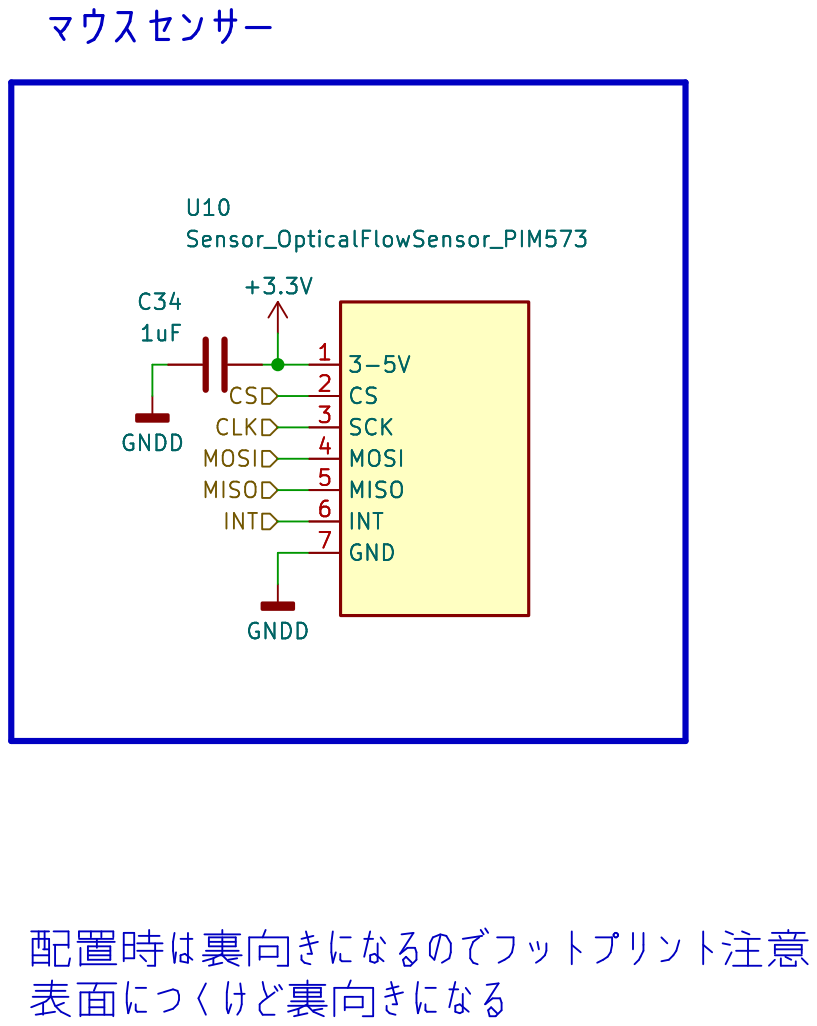
[picture p7: page 7]

INT MISO MOSI CLKCS þÿ0Þ0¦0¹0»0ó0µ0ü

Id: 8/7 Title: File: Mouse.kicad_sch Sheet: /Mouse/ GNDD
