Tomoshibi-technology/MovingDisplay3-Circuit/circuits/RasPi/RasPi.pdf

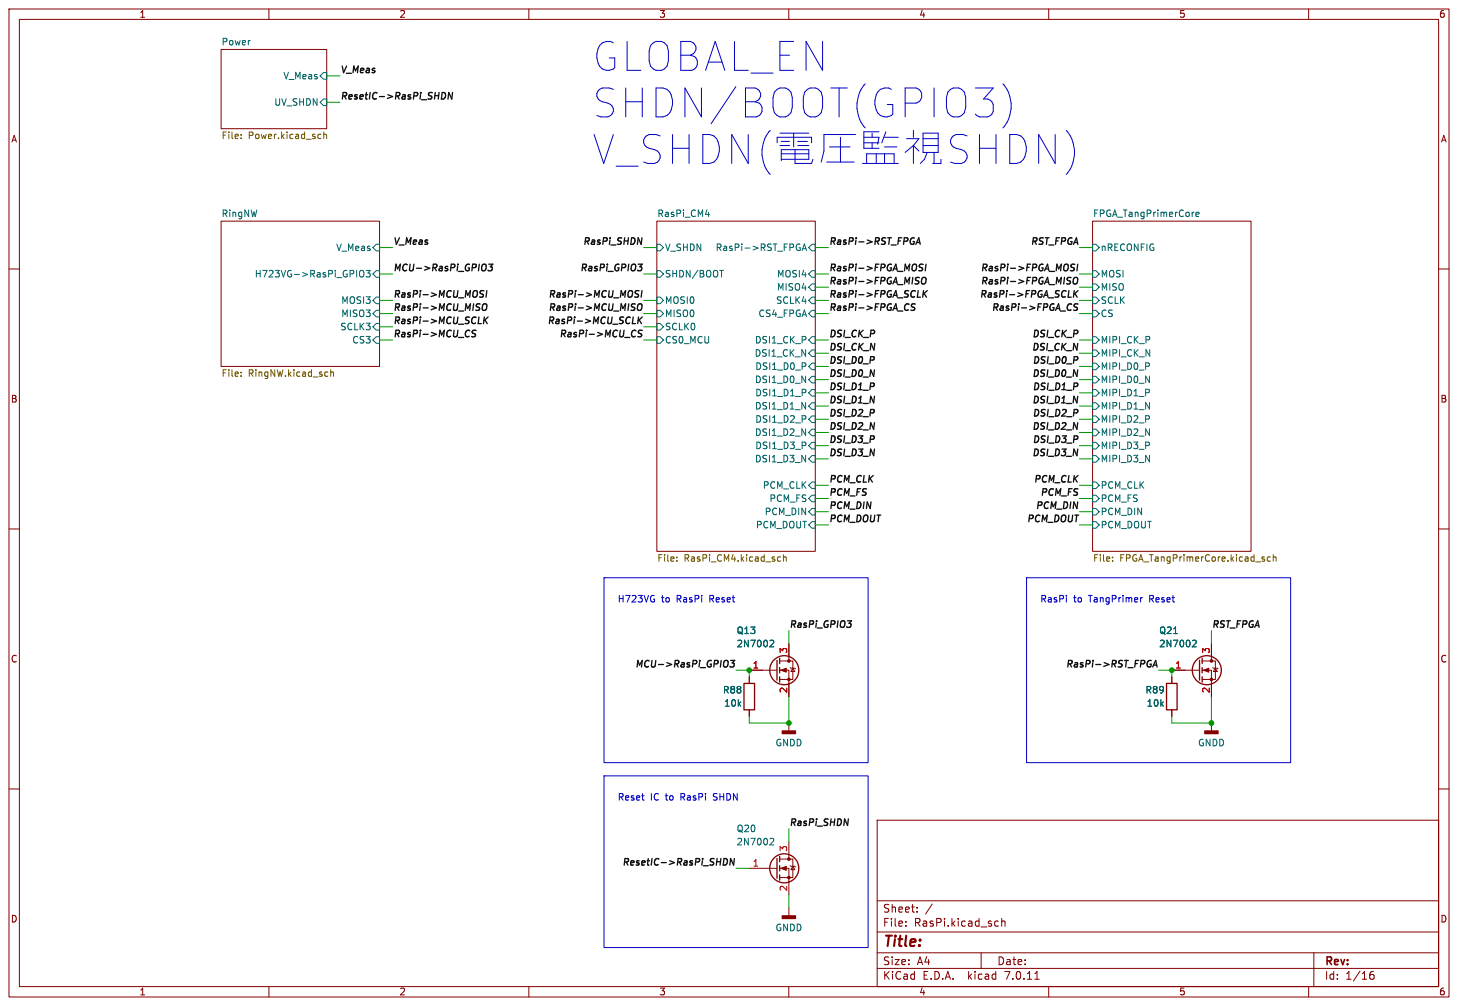
[picture p8: page 1]

H723VG to RasPi Reset Reset IC to RasPi SHDN GLOBAL_EN
SHDN/BOOT(GPIO3)
SCLK4 MOSI4 MISO4 CS4_FPGA RasPi_CM4 File: RasPi_CM4.kicad_sch

FPGA_TangPrimerCore File: FPGA_TangPrimerCore.kicad_sch
nRECONFIG MIPI_D0_N MIPI_D1_P MIPI_D0_P MIPI_CK_P MIPI_CK_N MIPI_D3_P MIPI_D3_N MIPI_D2_N MIPI_D2_P MIPI_D1_N MISO MOSI SCLK CS

Id: 1/16 Title: File: RasPi.kicad_sch Sheet: /

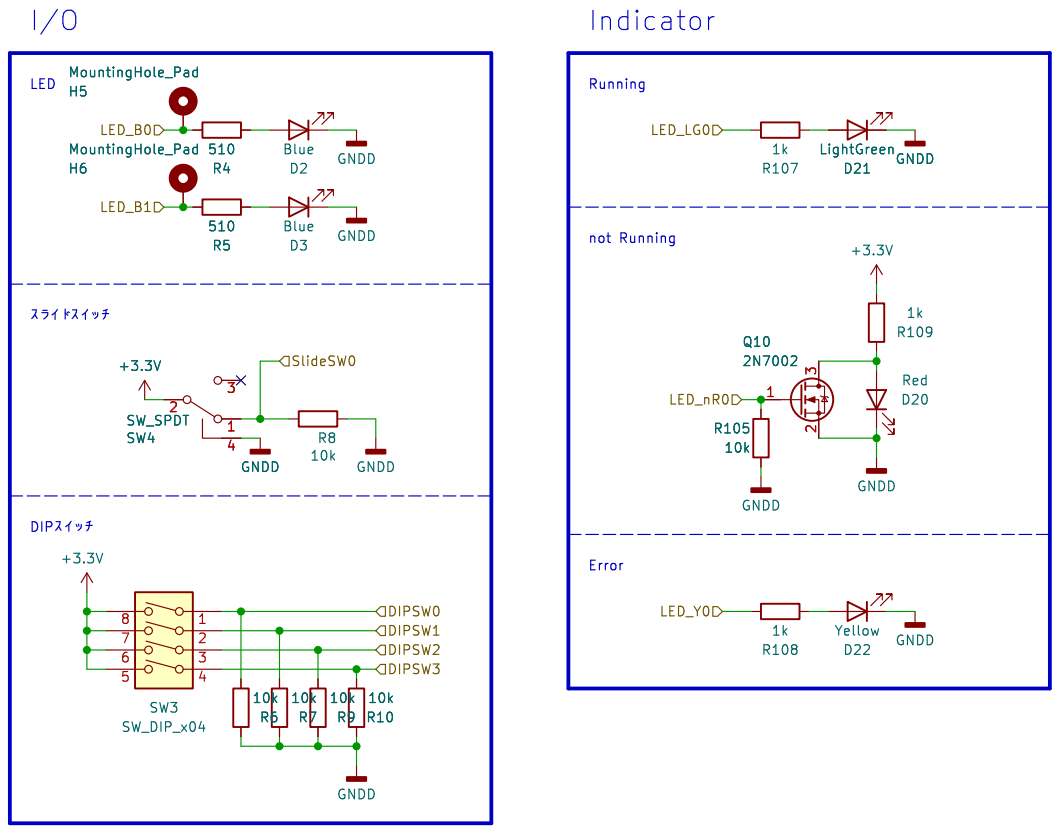
[picture p9: page 2]

Id: 2/16 Title: File: UI_RingNW.kicad_sch Sheet: /RingNW/UI_RingNW/

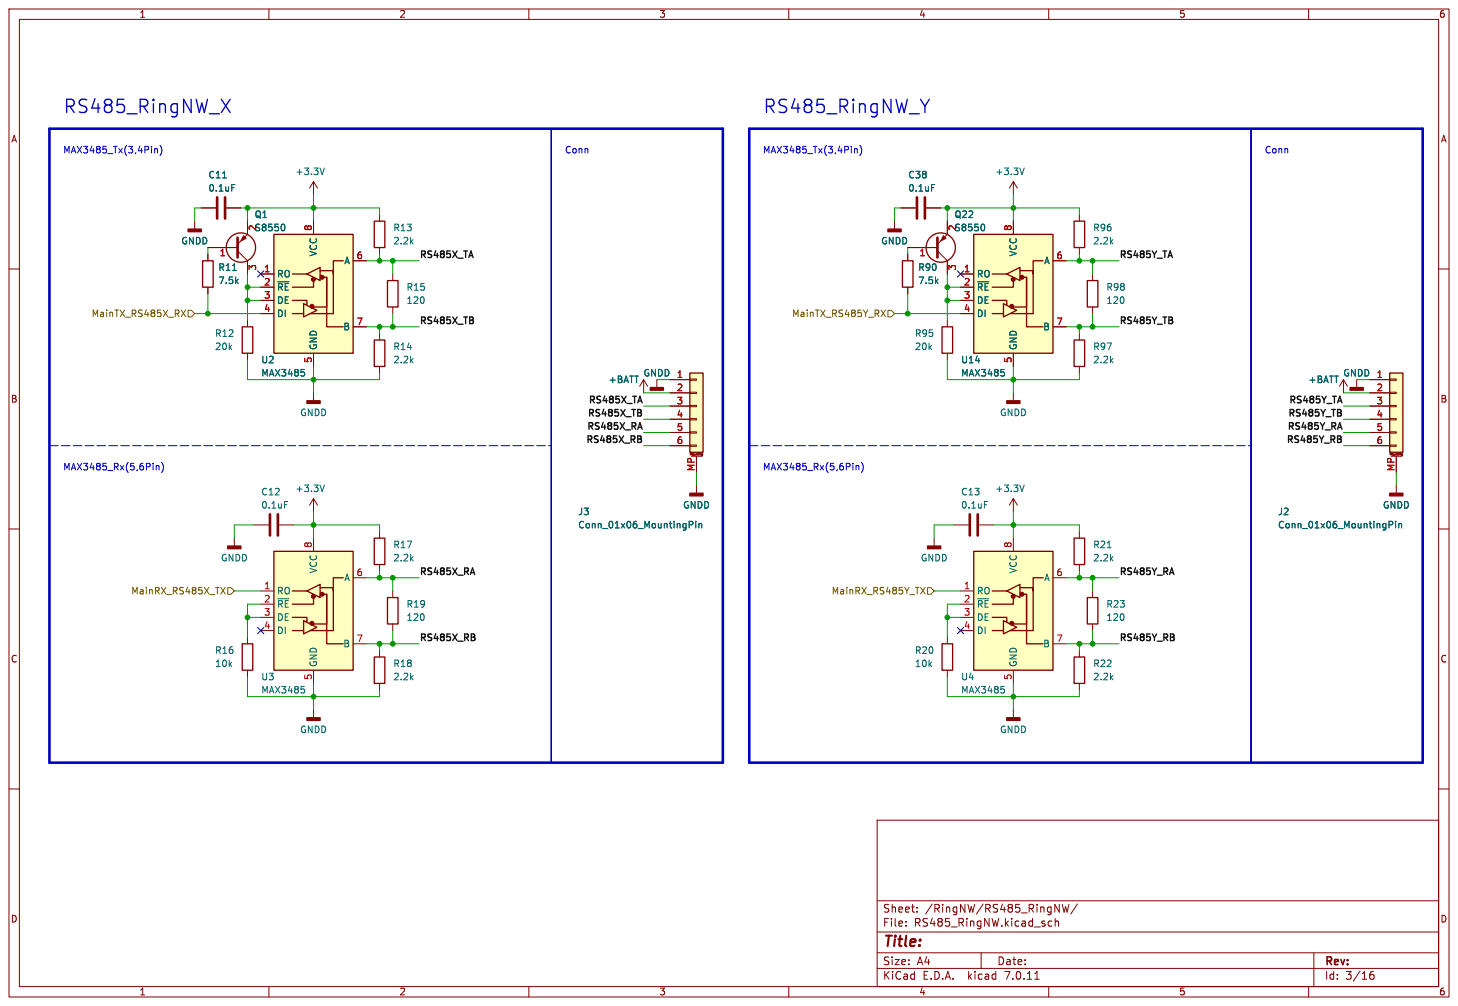
[picture p10: page 3]

Id: 3/16 Title: File: RS485_RingNW.kicad_sch Sheet: /RingNW/RS485_RingNW/ R20

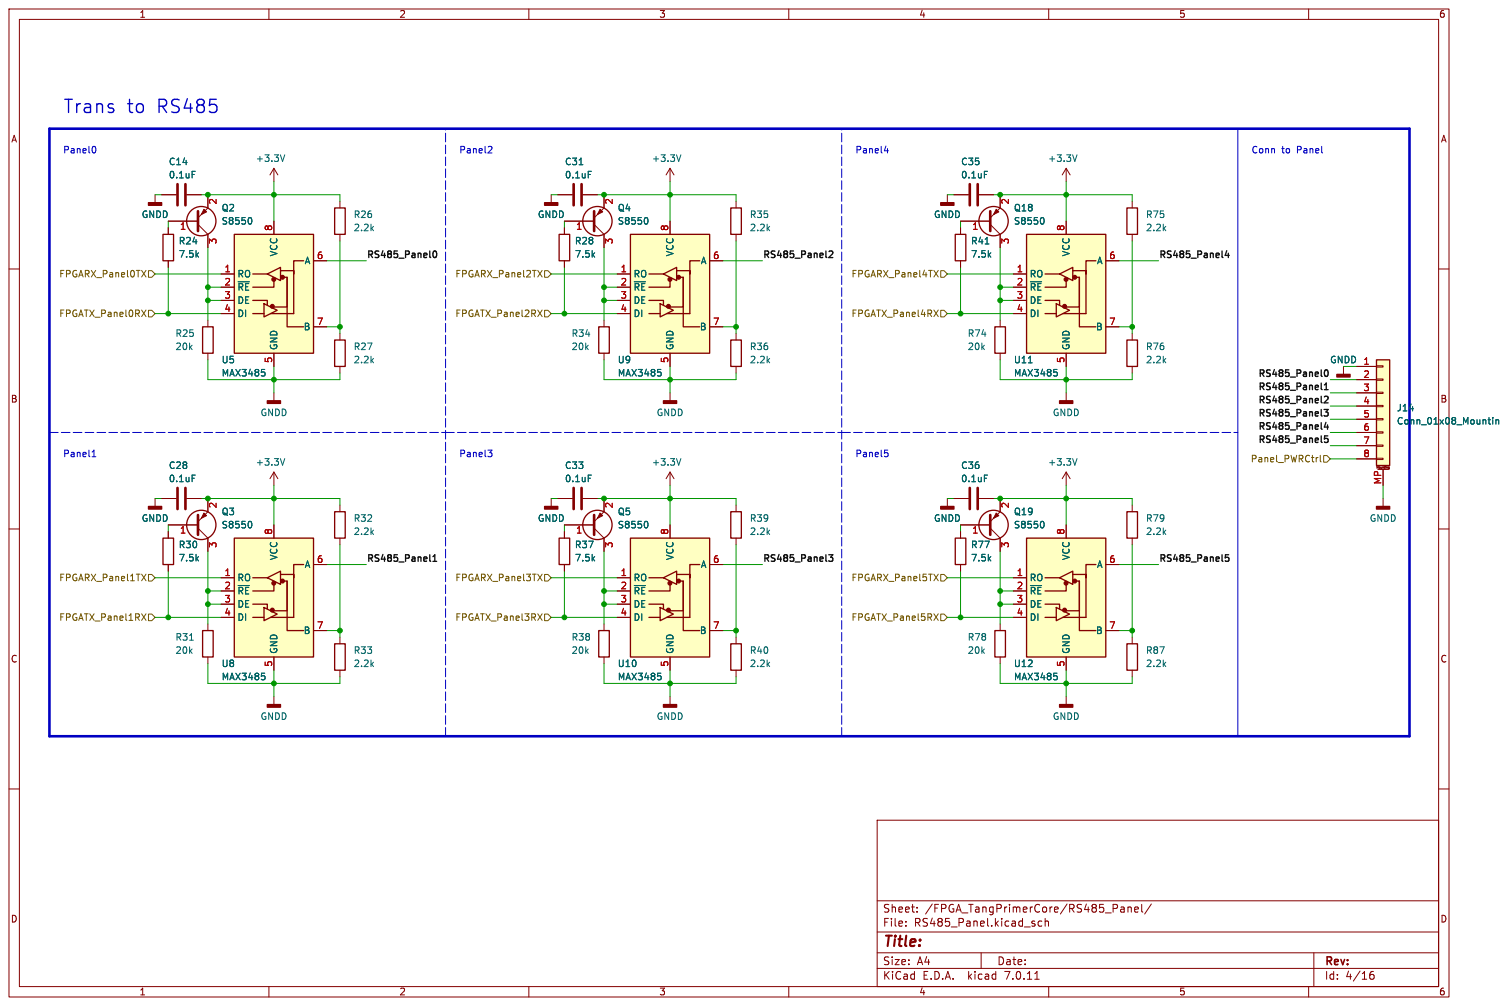
[picture p11: page 4]

2 3 Q18 S8550 RO 1 ~{RE} 2 DE 3 DI 4 GND

2 3 U12 MAX3485 RO 1 ~{RE} 2 DE 3 DI 4 GND

Id: 4/16 Title: File: RS485_Panel.kicad_sch Sheet: /FPGA_TangPrimerCore/RS485_Panel/

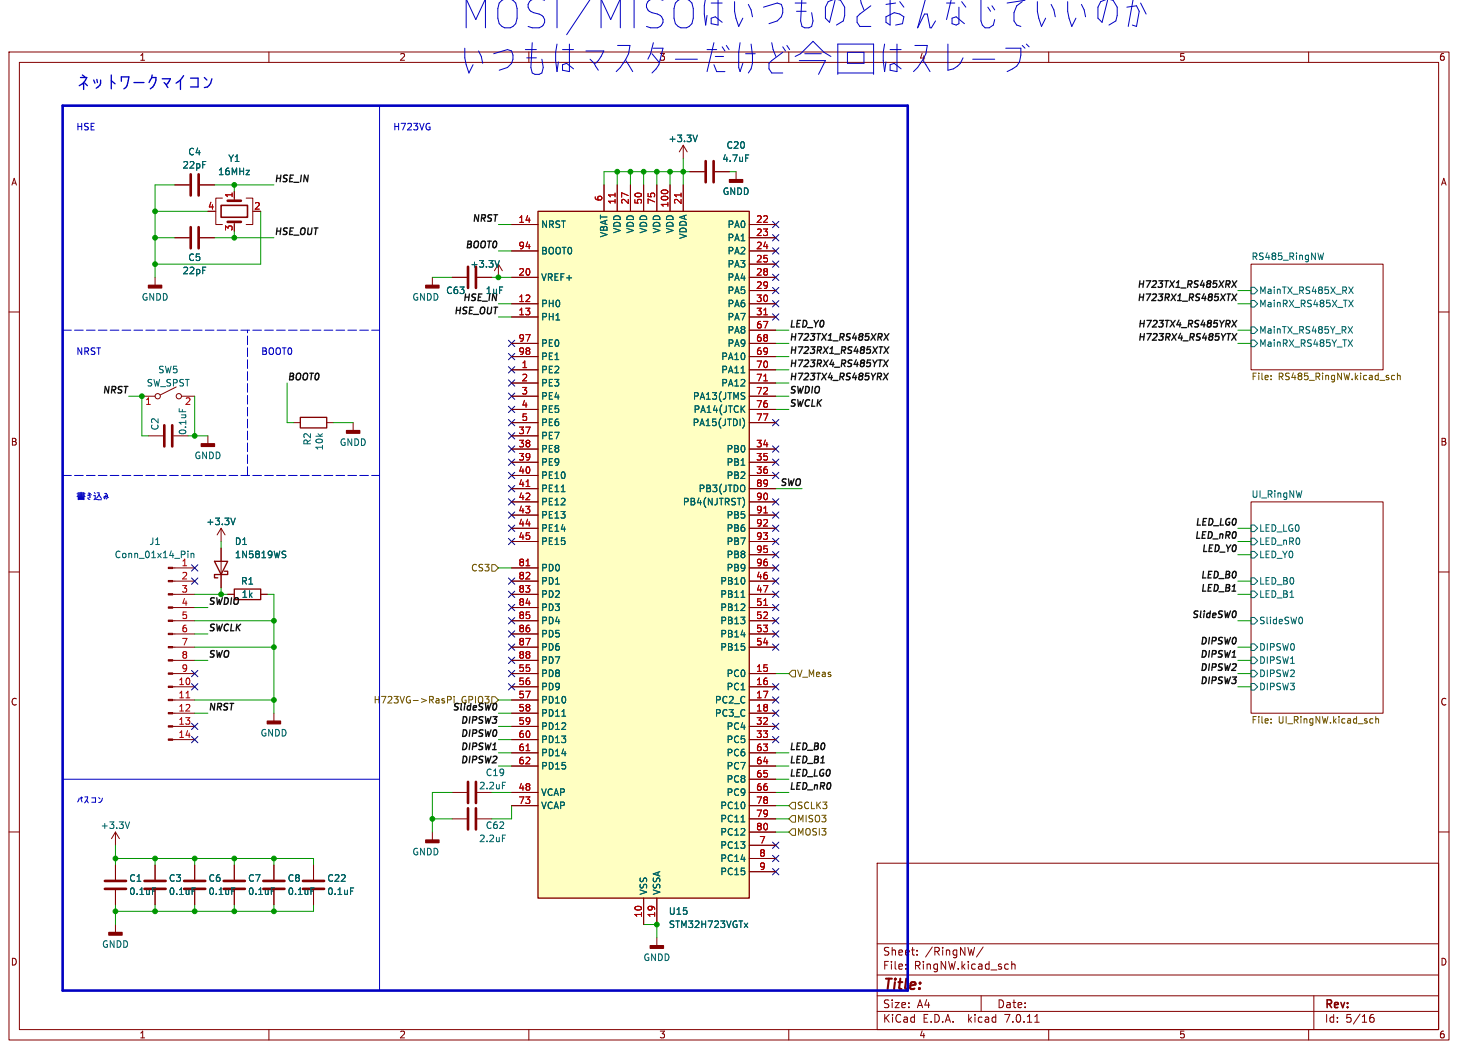
[picture p12: page 5]

Id: 5/16 Title: File: RingNW.kicad_sch Sheet: /RingNW/

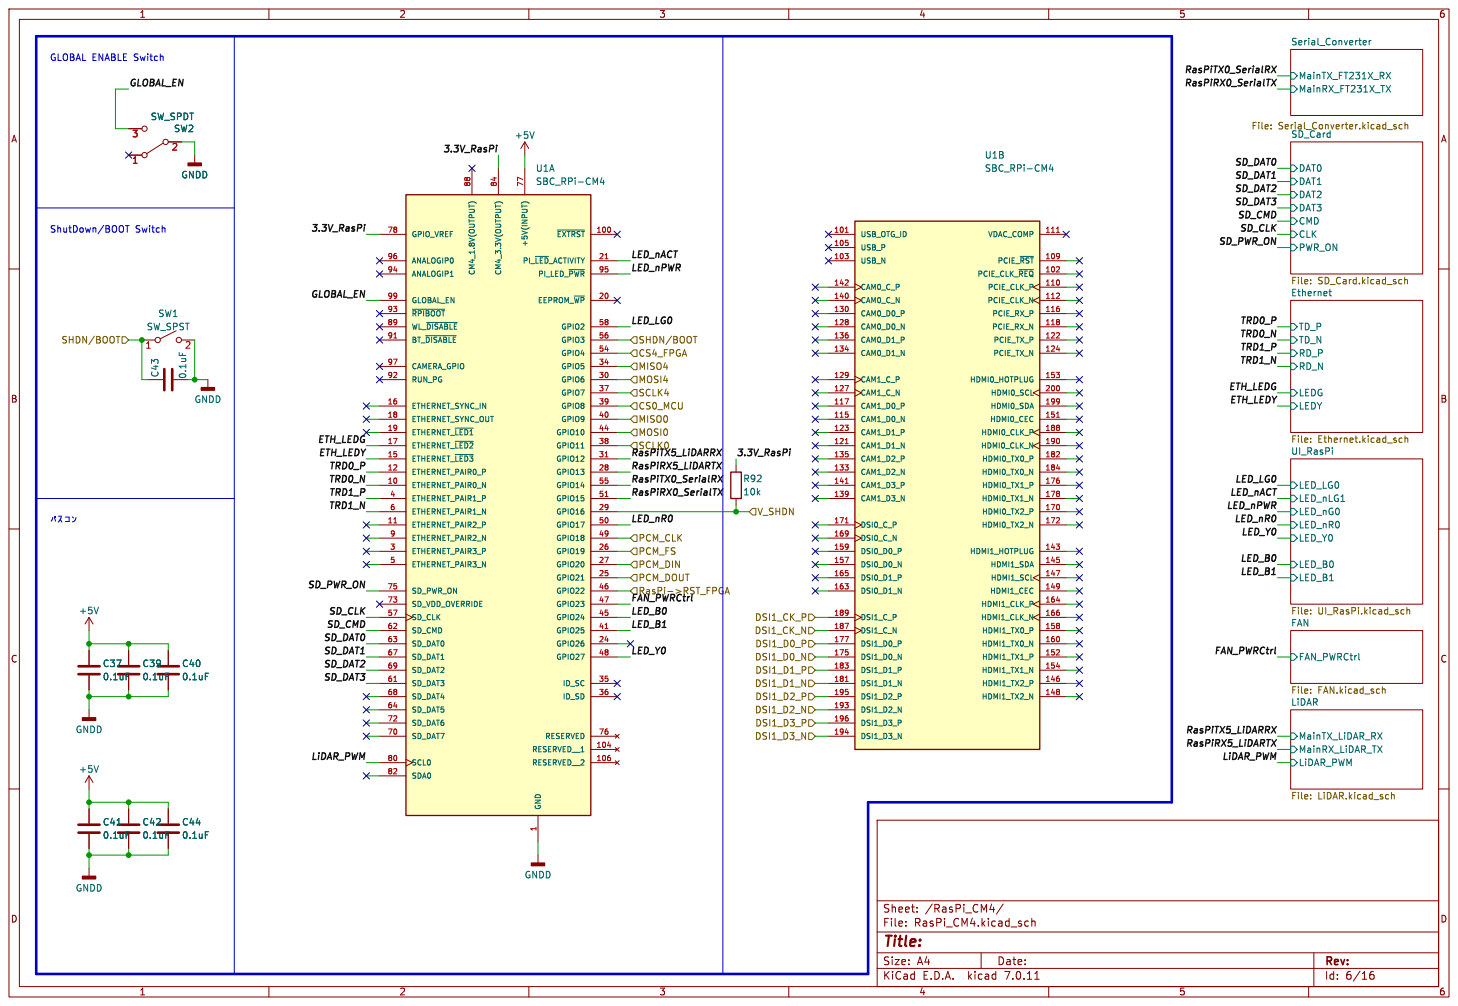
[picture p13: page 6]

Id: 6/16 Title: File: RasPi_CM4.kicad_sch Sheet: /RasPi_CM4/

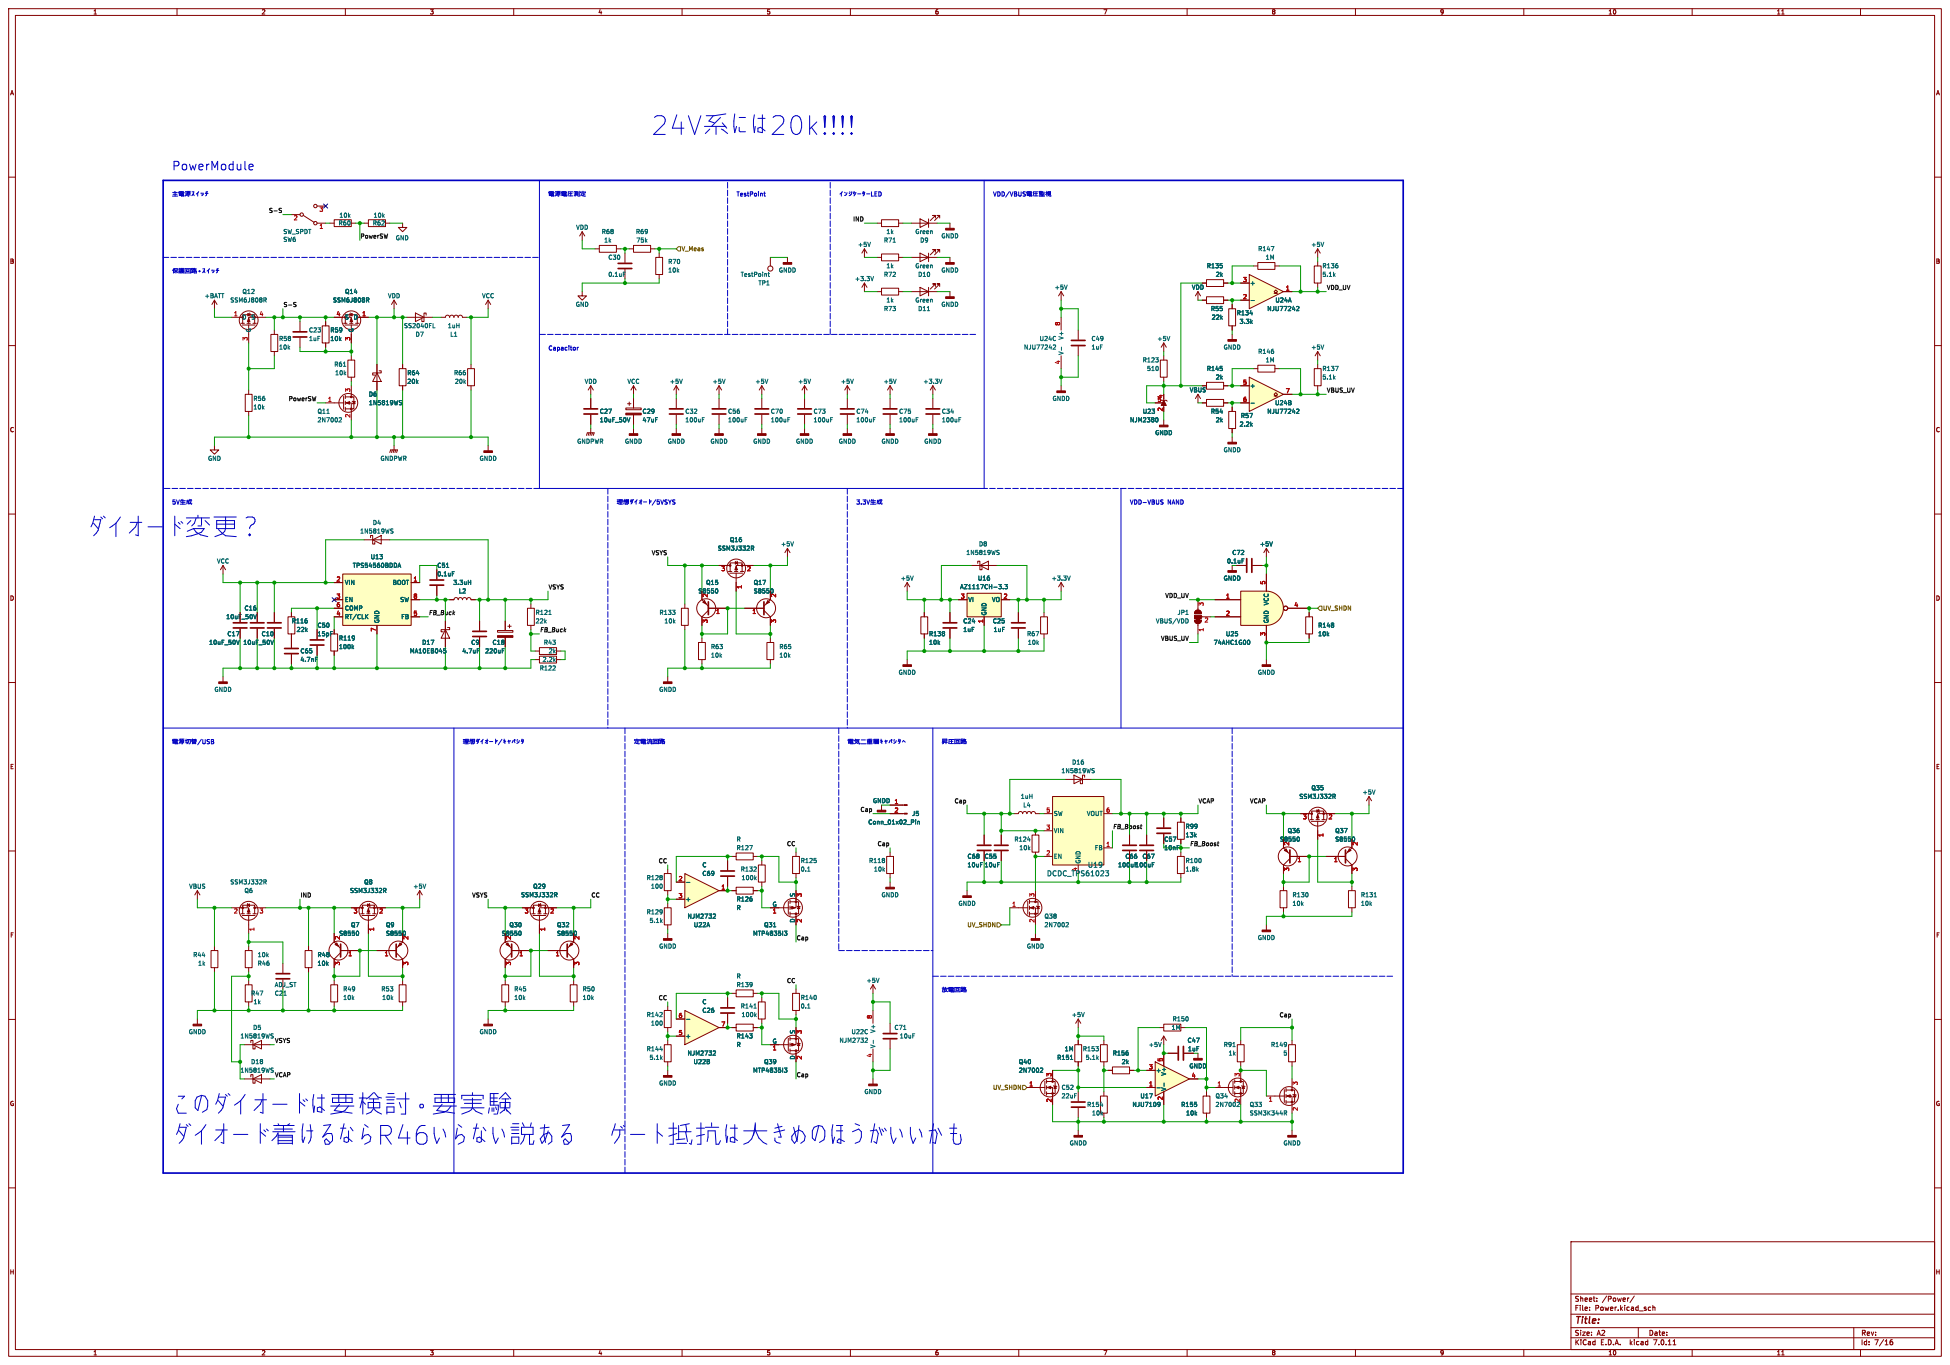
[picture p14: page 7]

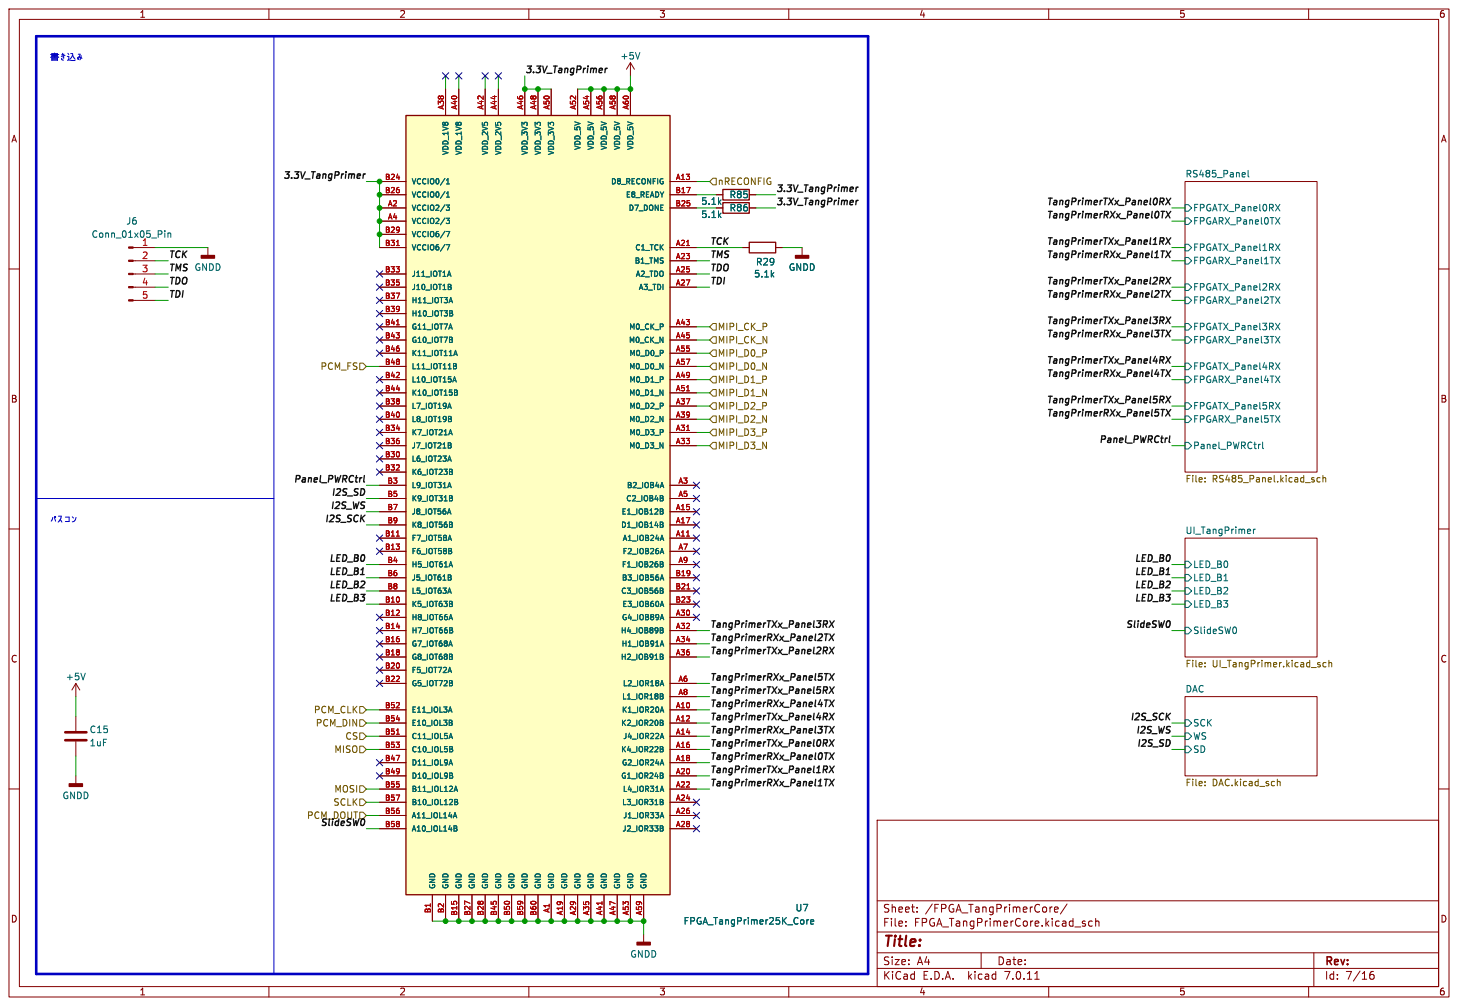
[picture p15: page 8]

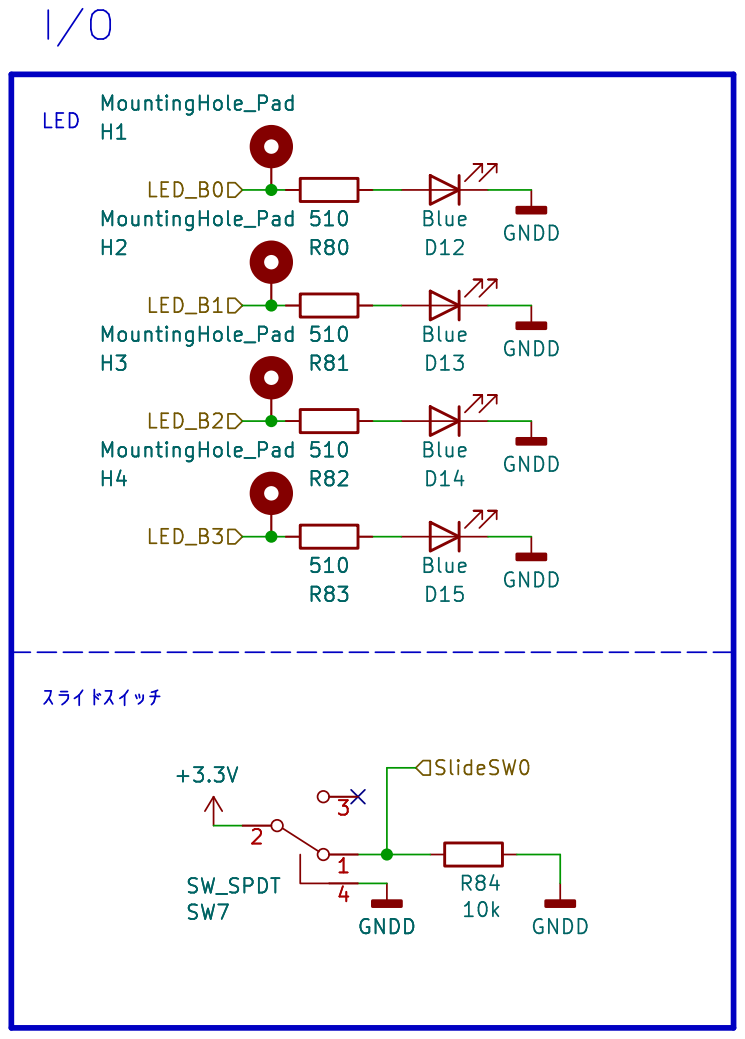
[picture p16: page 9]

Id: 8/16 Title: File: UI_TangPrimer.kicad_sch Sheet: /FPGA_TangPrimerCore/UI_TangPrimer/

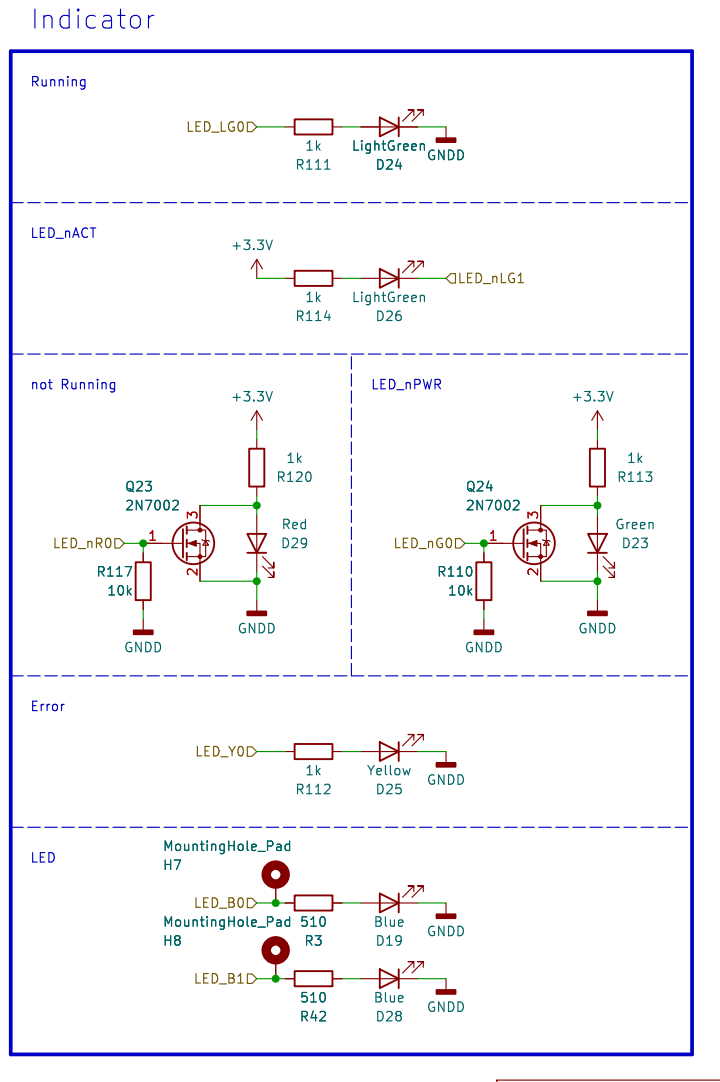
[picture p17: page 10]

LED_nACT | | 1k R111

not Running | LED_nPWR

Id: 9/16 Title: File: UI_RasPi.kicad_sch Sheet: /RasPi_CM4/UI_RasPi/

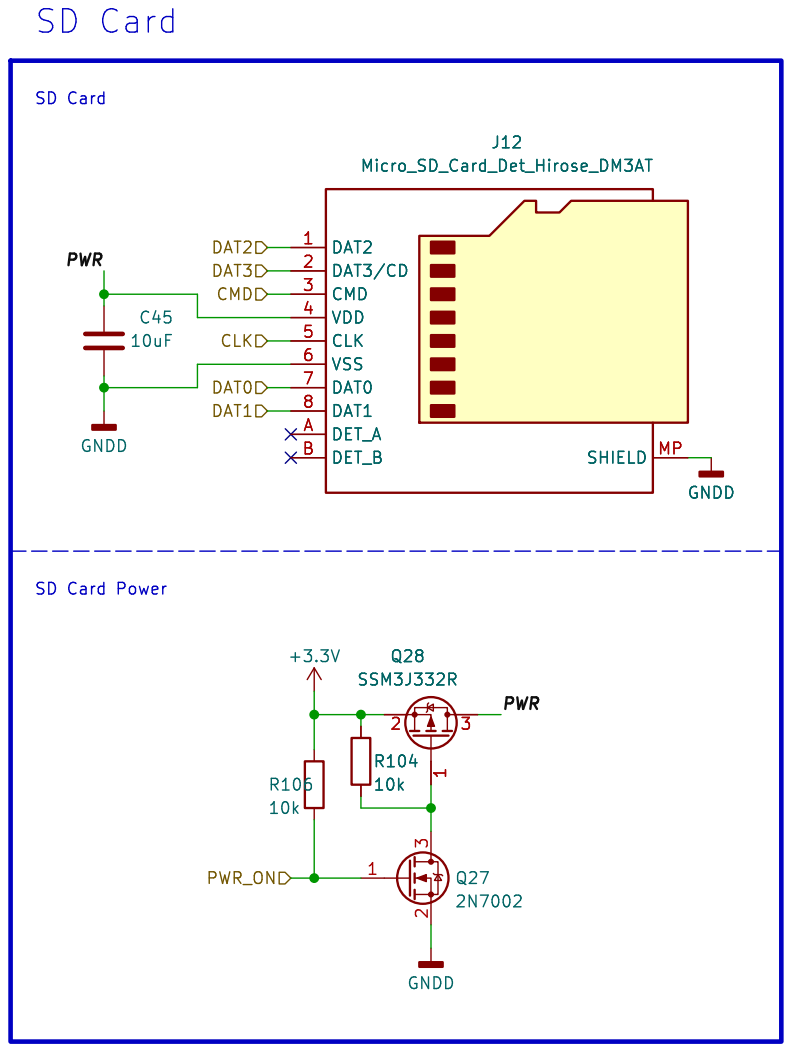
[picture p18: page 11]

SD Card Power SD Card
J12 Micro_SD_Card_Det_Hirose_DM3AT GNDD
DAT0 DAT1 CLK CMD

Id: 10/16 Title: File: SD_Card.kicad_sch Sheet: /RasPi_CM4/SD_Card/

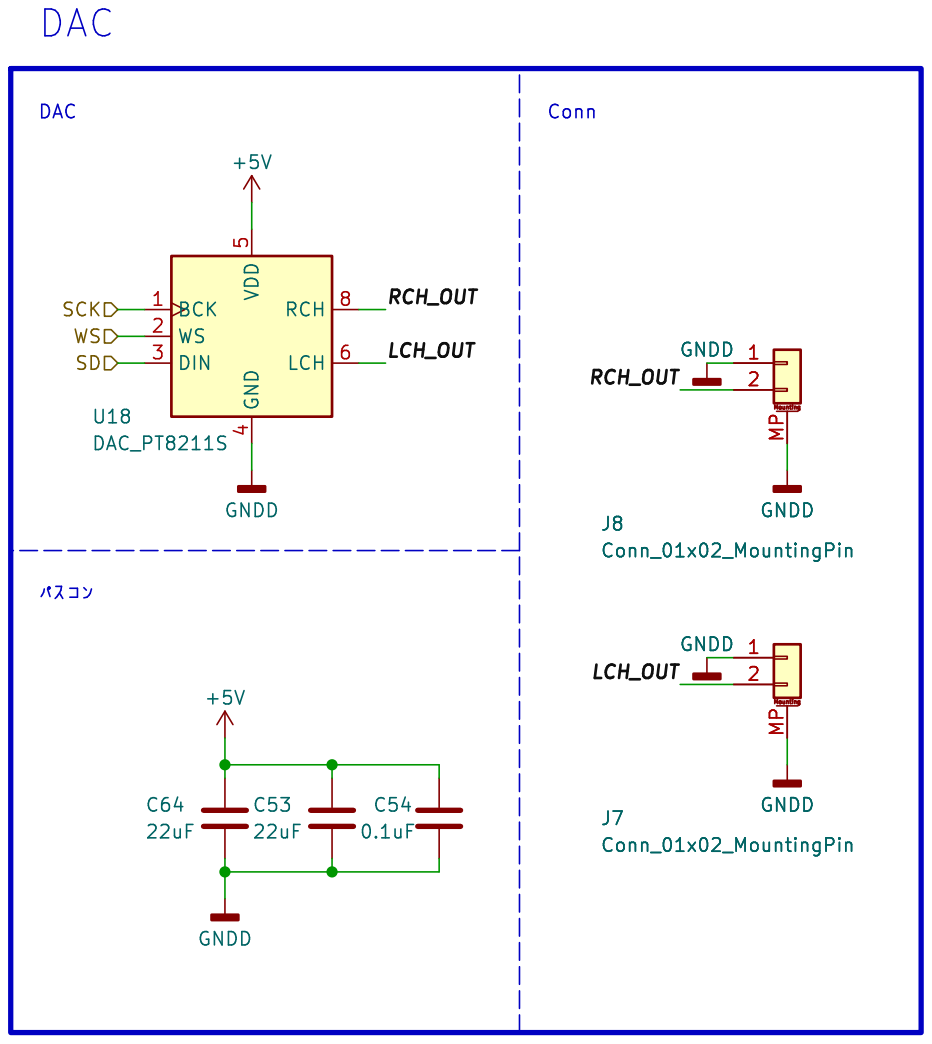
[picture p19: page 12]

RCH_OUT
2 MP GNDD GNDD GNDD

Id: 11/16 Title: File: DAC.kicad_sch Sheet: /FPGA_TangPrimerCore/DAC/

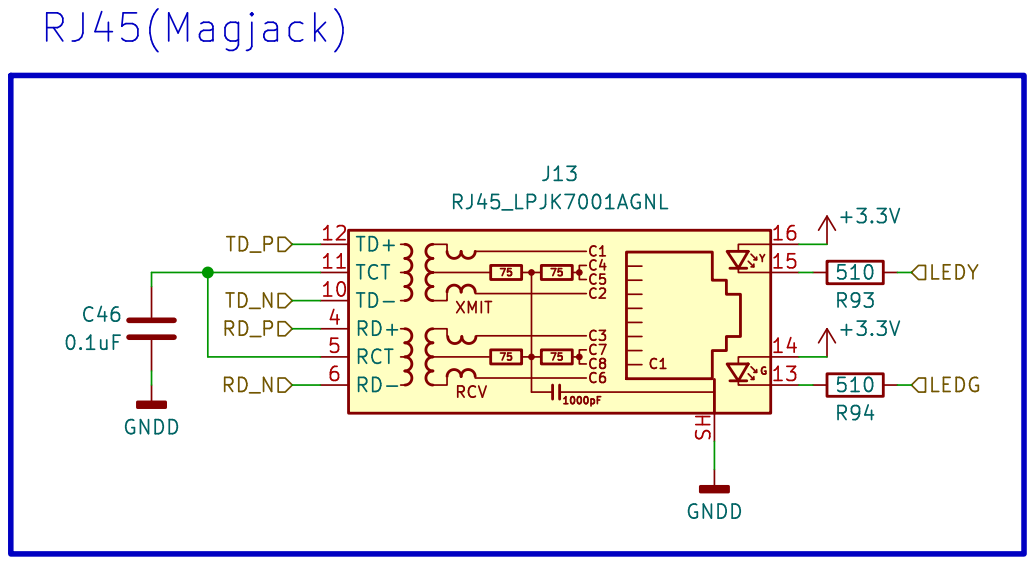
[picture p20: page 13]

Id: 12/16 Title: File: Ethernet.kicad_sch Sheet: /RasPi_CM4/Ethernet/

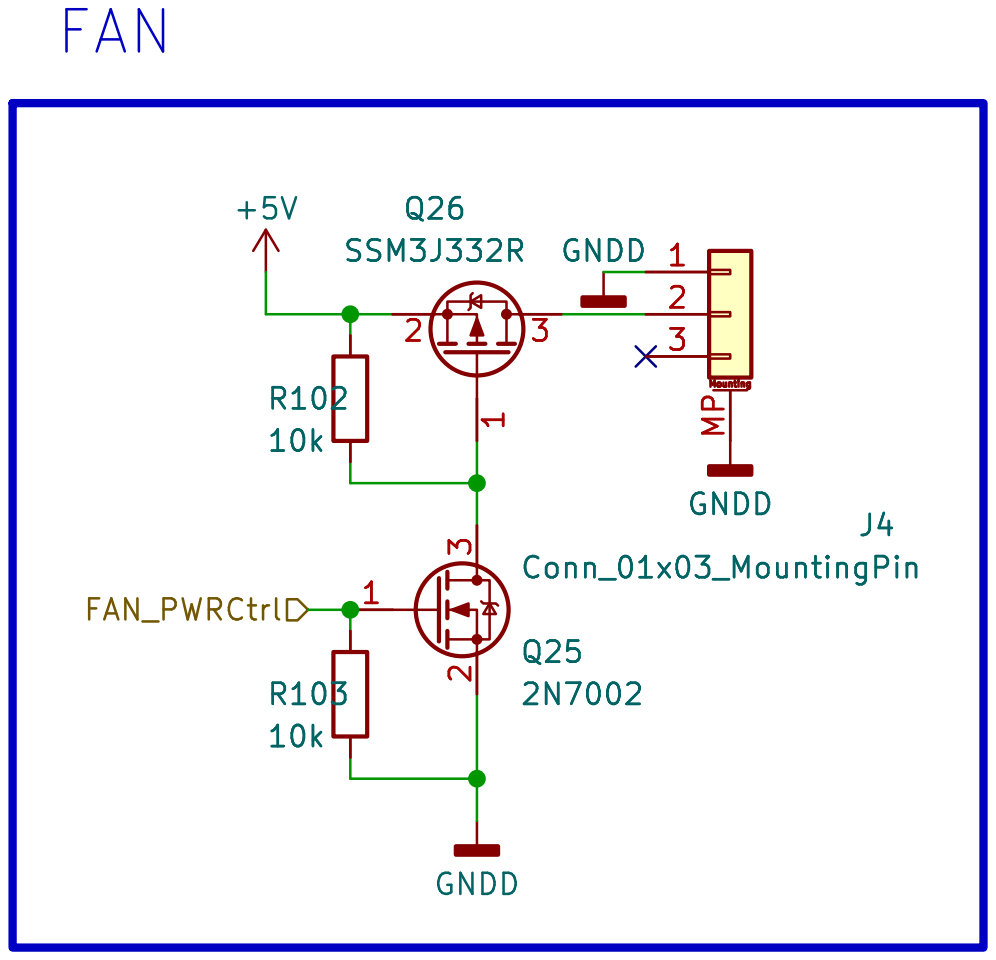
[picture p21: page 14]

Id: 13/16 Title: File: FAN.kicad_sch Sheet: /RasPi_CM4/FAN/ GNDD

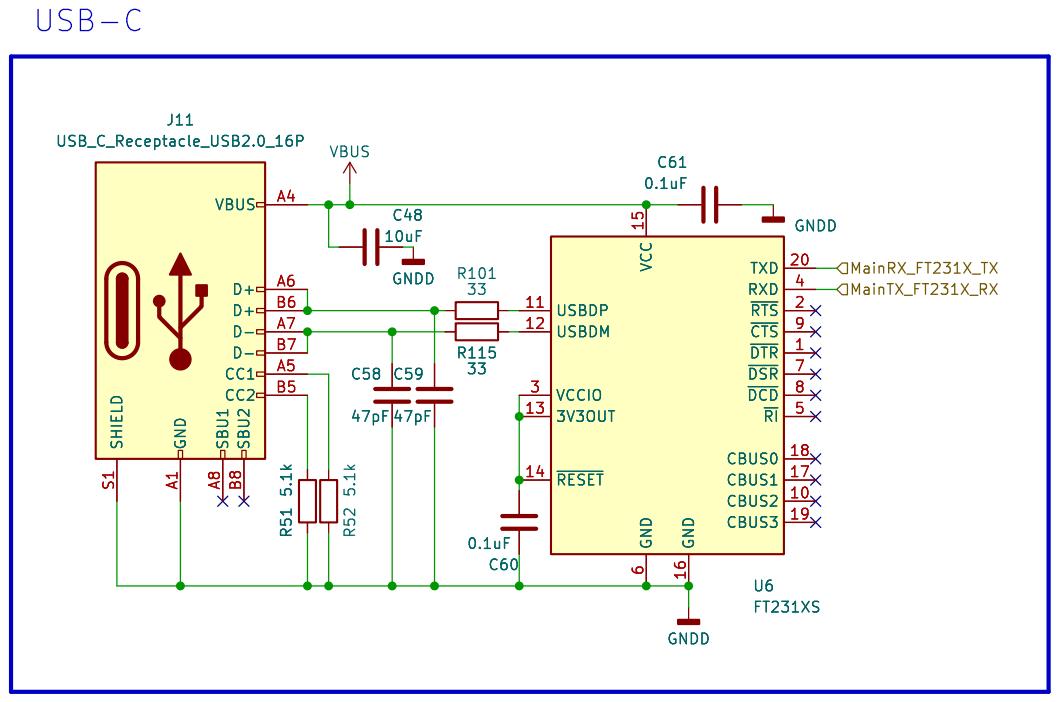
[picture p22: page 15]

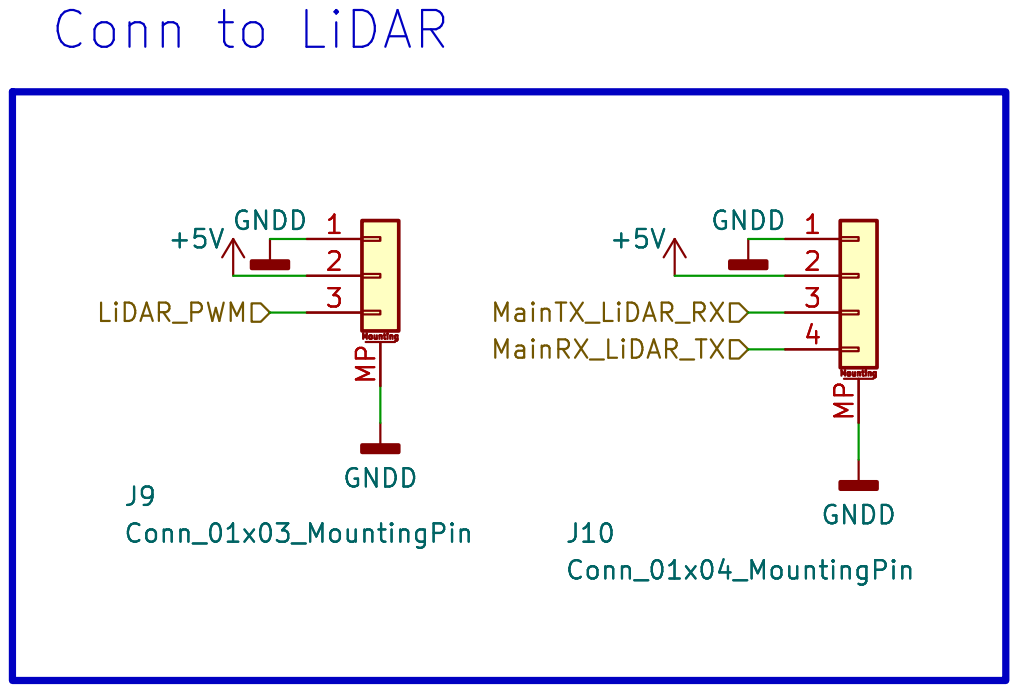
[picture p23: page 16]

Id: 16/16 Title: File: LiDAR.kicad_sch Sheet: /RasPi_CM4/LiDAR/
