Tomoshibi-technology/MovingDisplay3-Circuit/circuits/MD_module/Control/Control.pdf

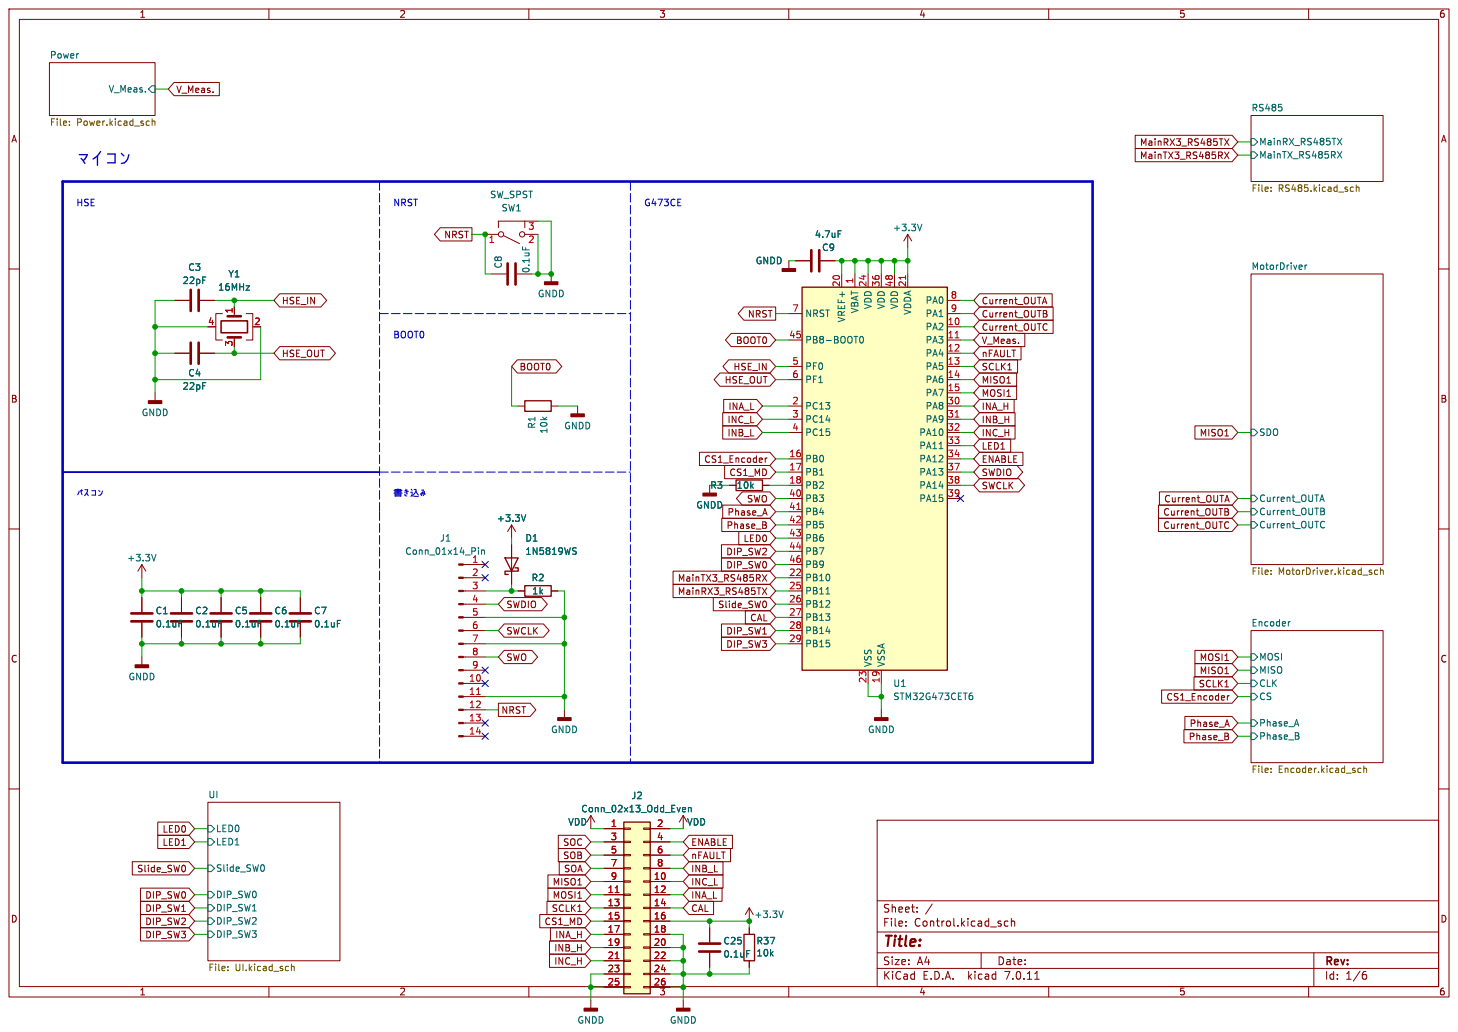
[picture p24: page 1]

Id: 1/6 Title: File: Control.kicad_sch Sheet: /

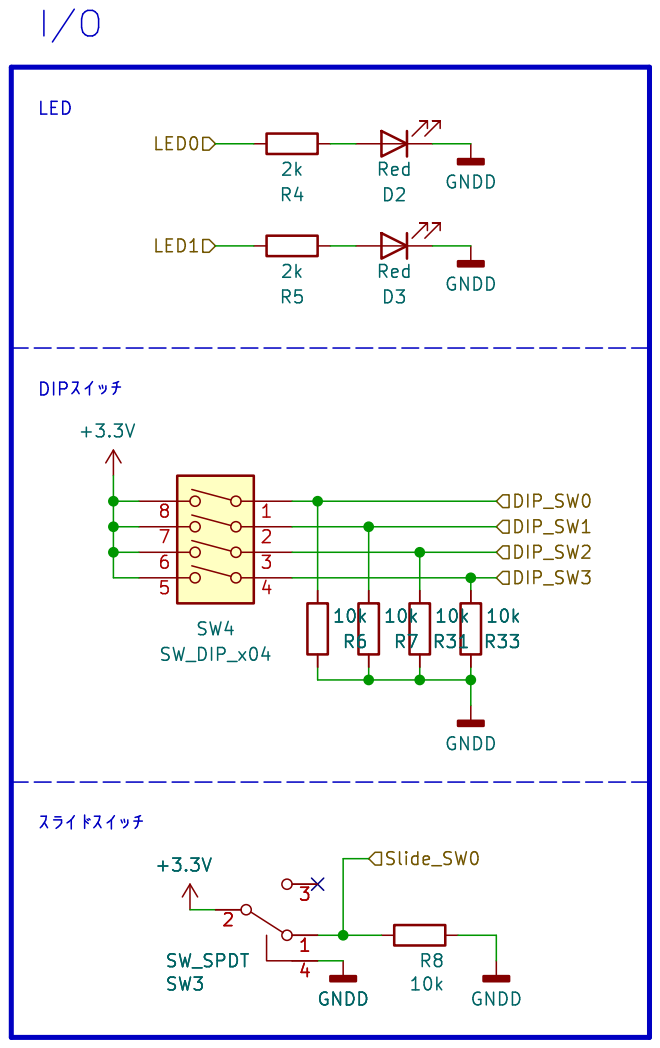
[picture p25: page 2]

Id: 2/6 Title: File: UI.kicad_sch Sheet: /UI/ 1

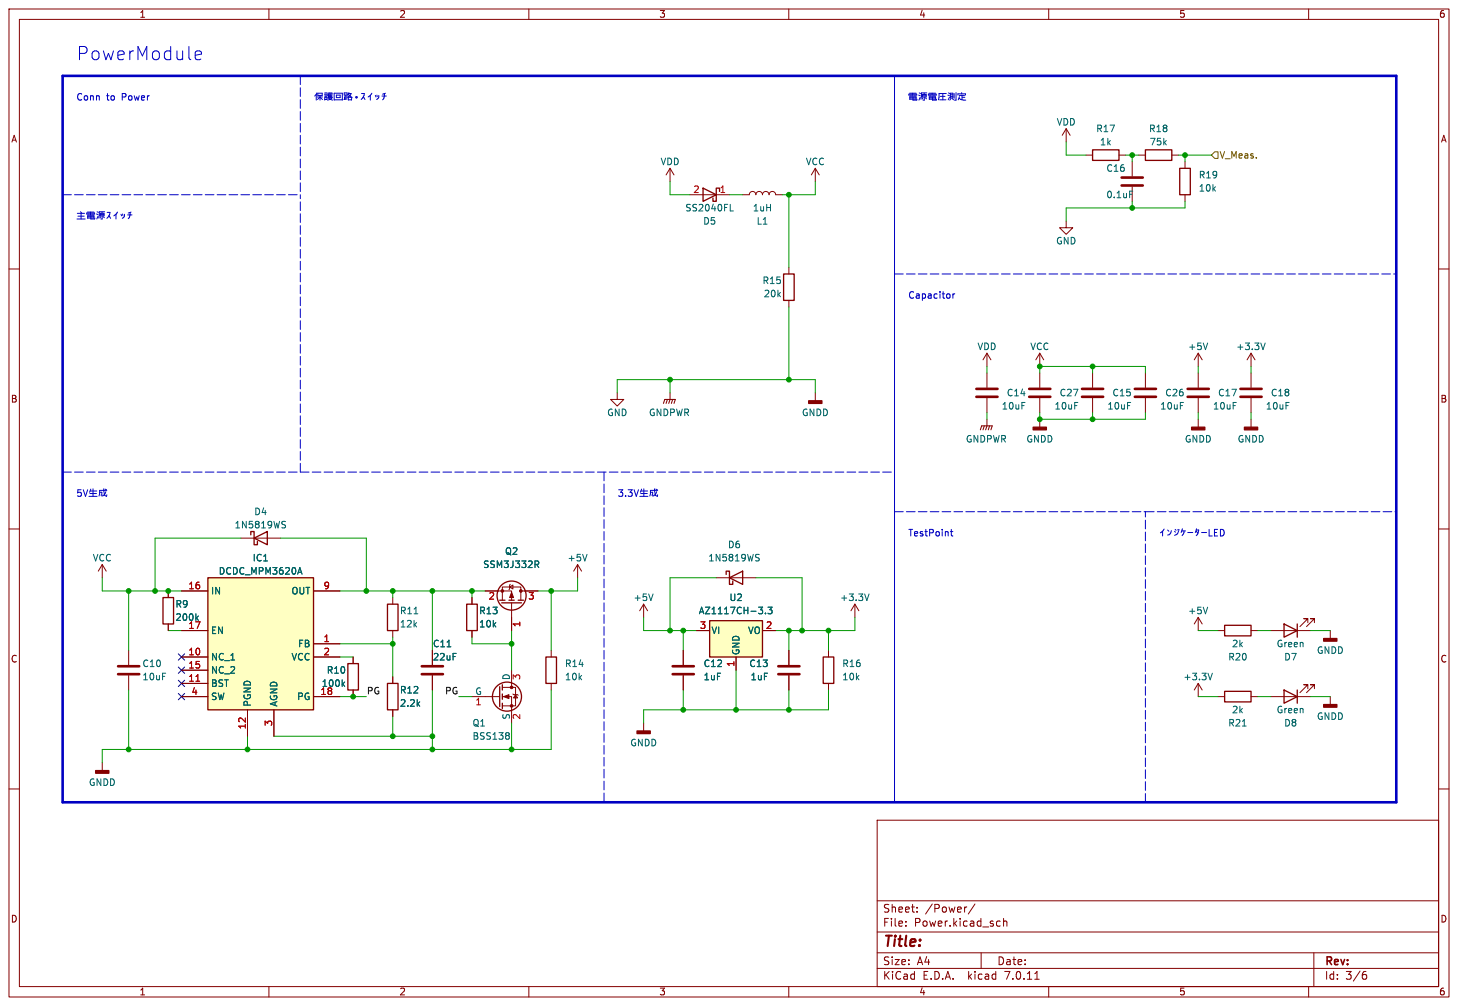
[picture p26: page 3]

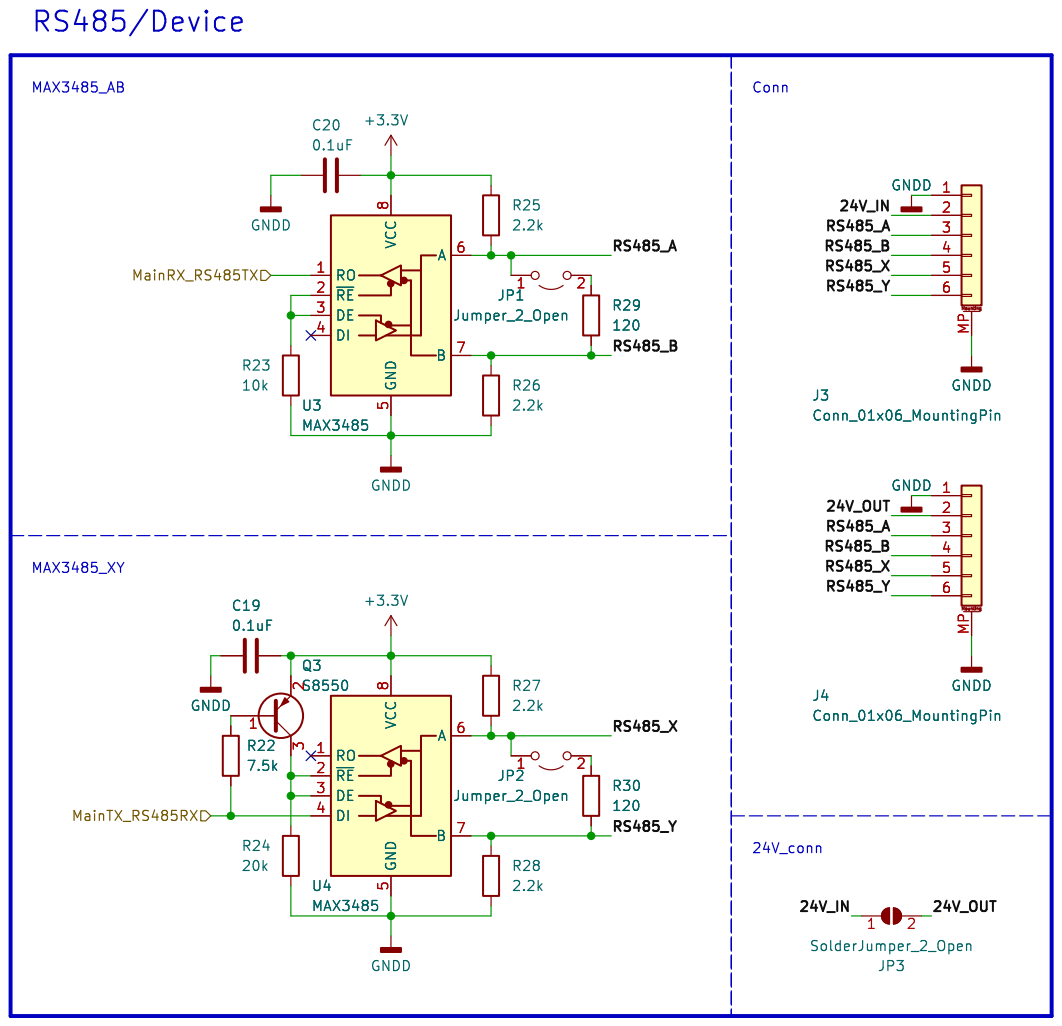
[picture p27: page 4]

Id: 4/6 Title: File: RS485.kicad_sch Sheet: /RS485/ C19

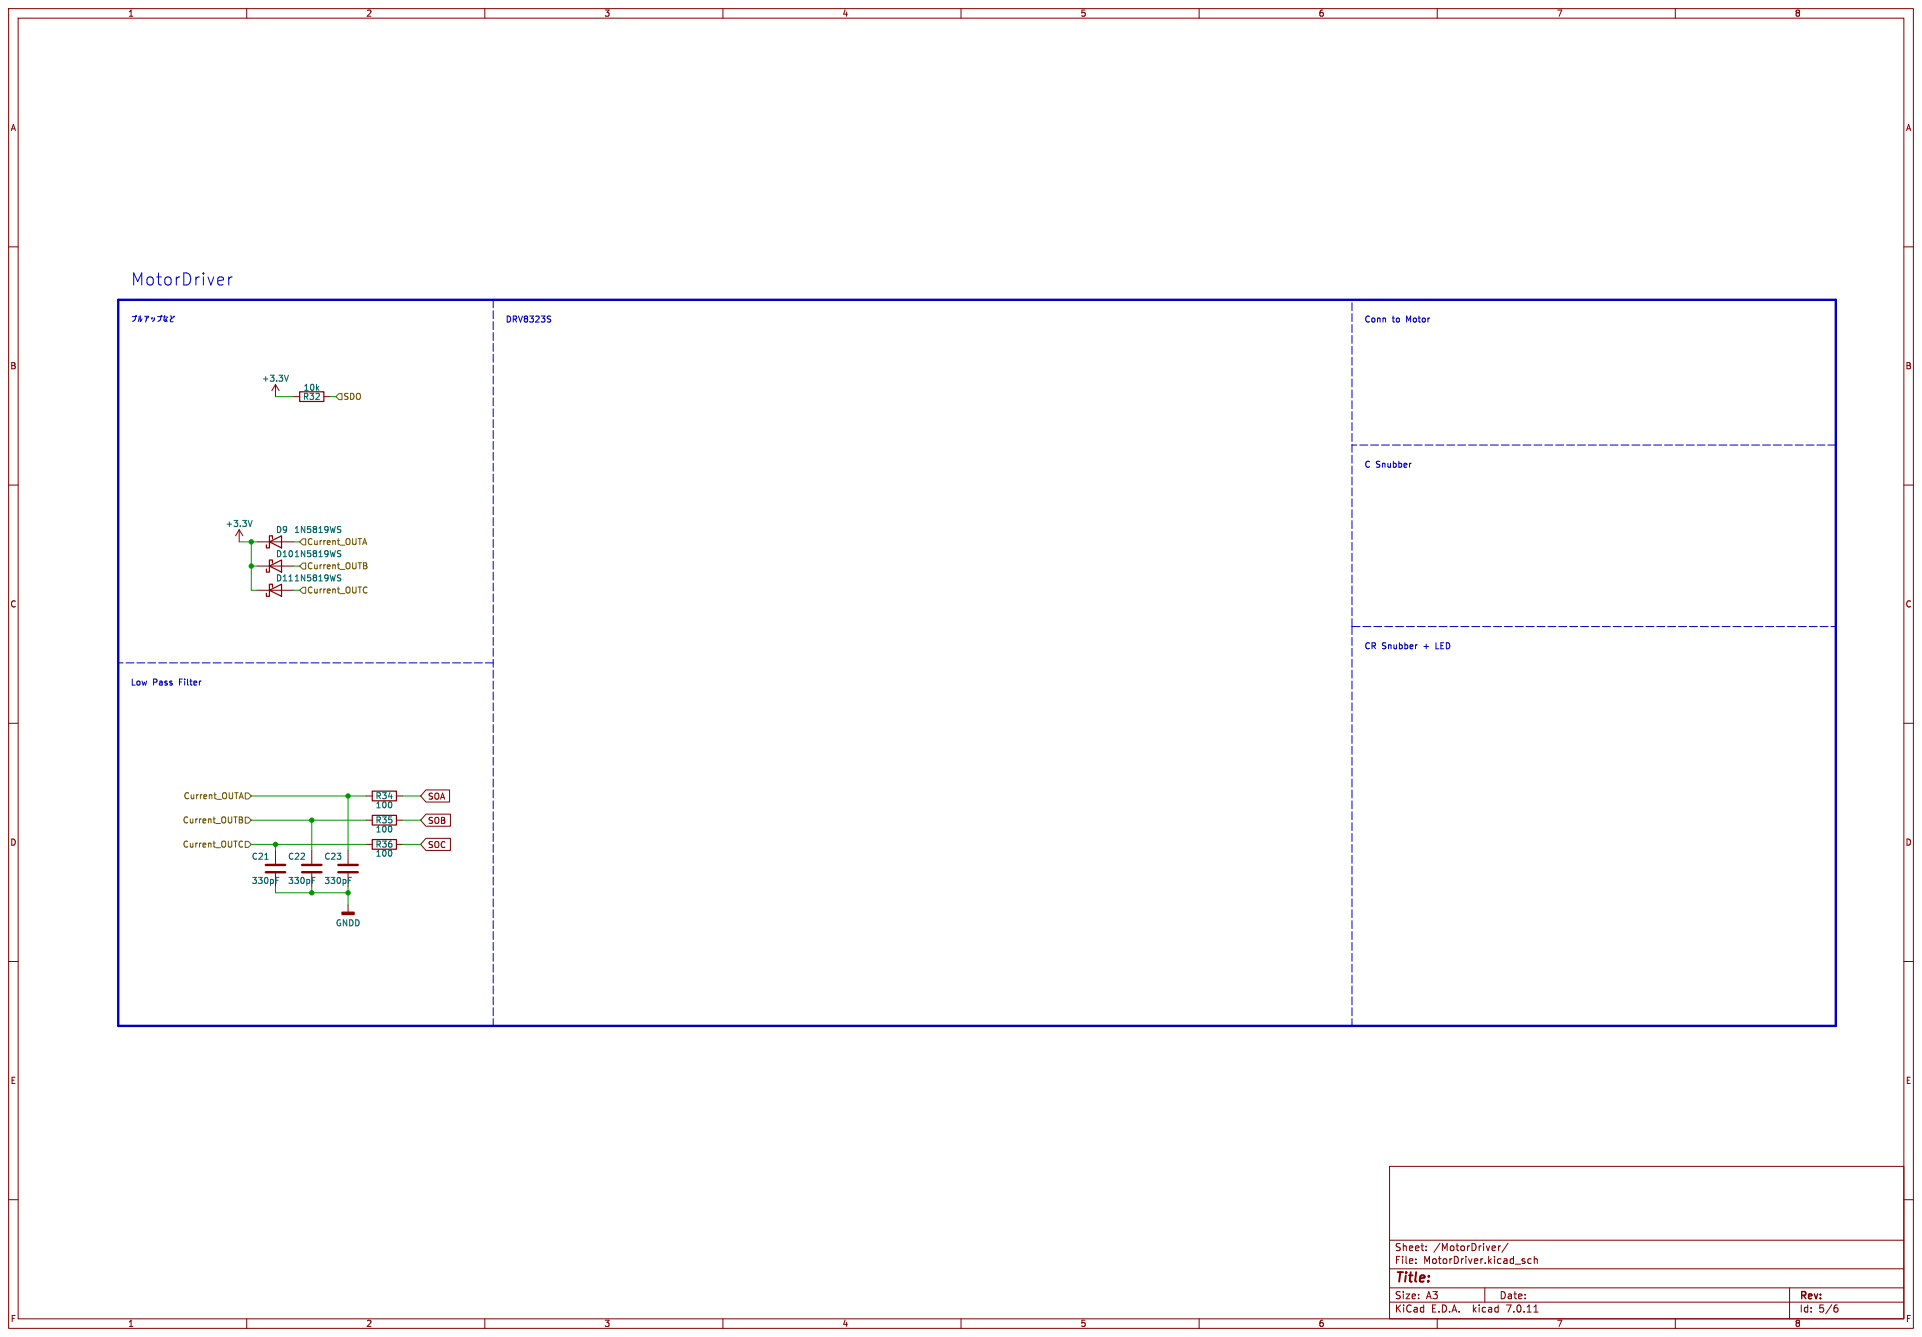
[picture p28: page 5]

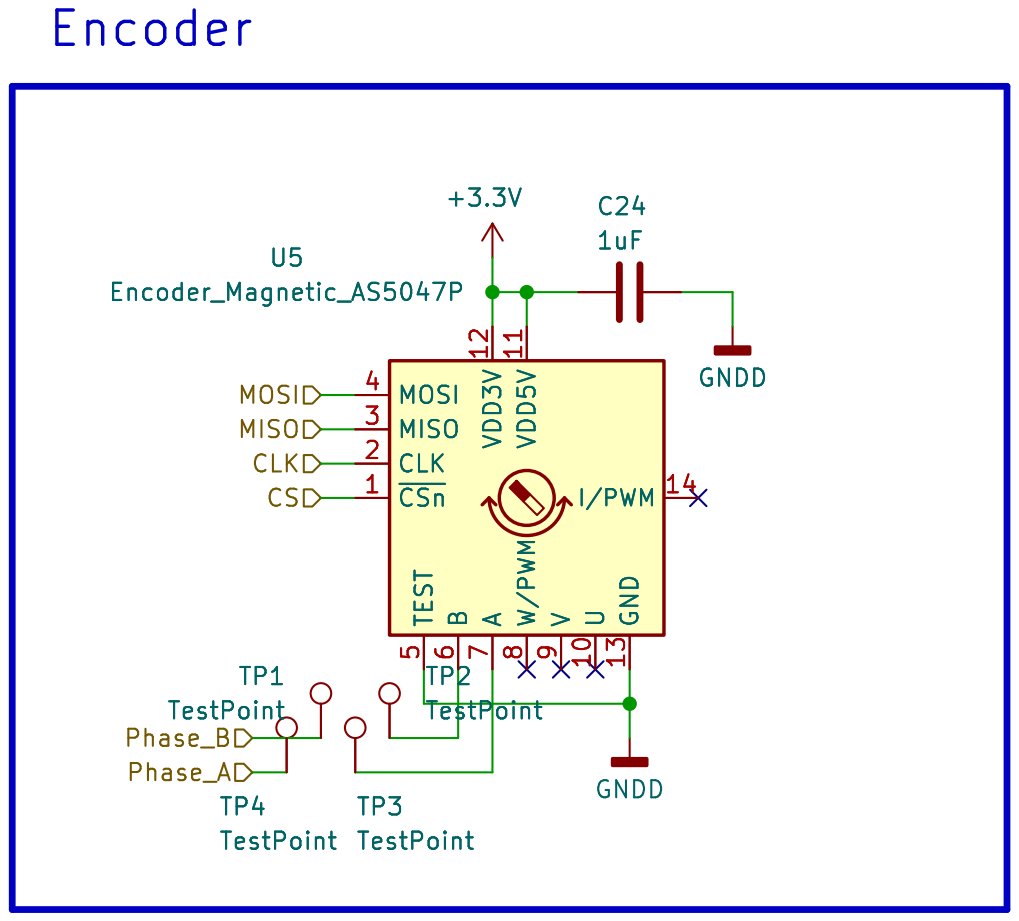
[picture p29: page 6]

Id: 6/6 Title: File: Encoder.kicad_sch Sheet: /Encoder/ GNDD
