Tomoshibi-technology/MovingDisplay3-Circuit/circuits/MD_module/MD/MD.pdf

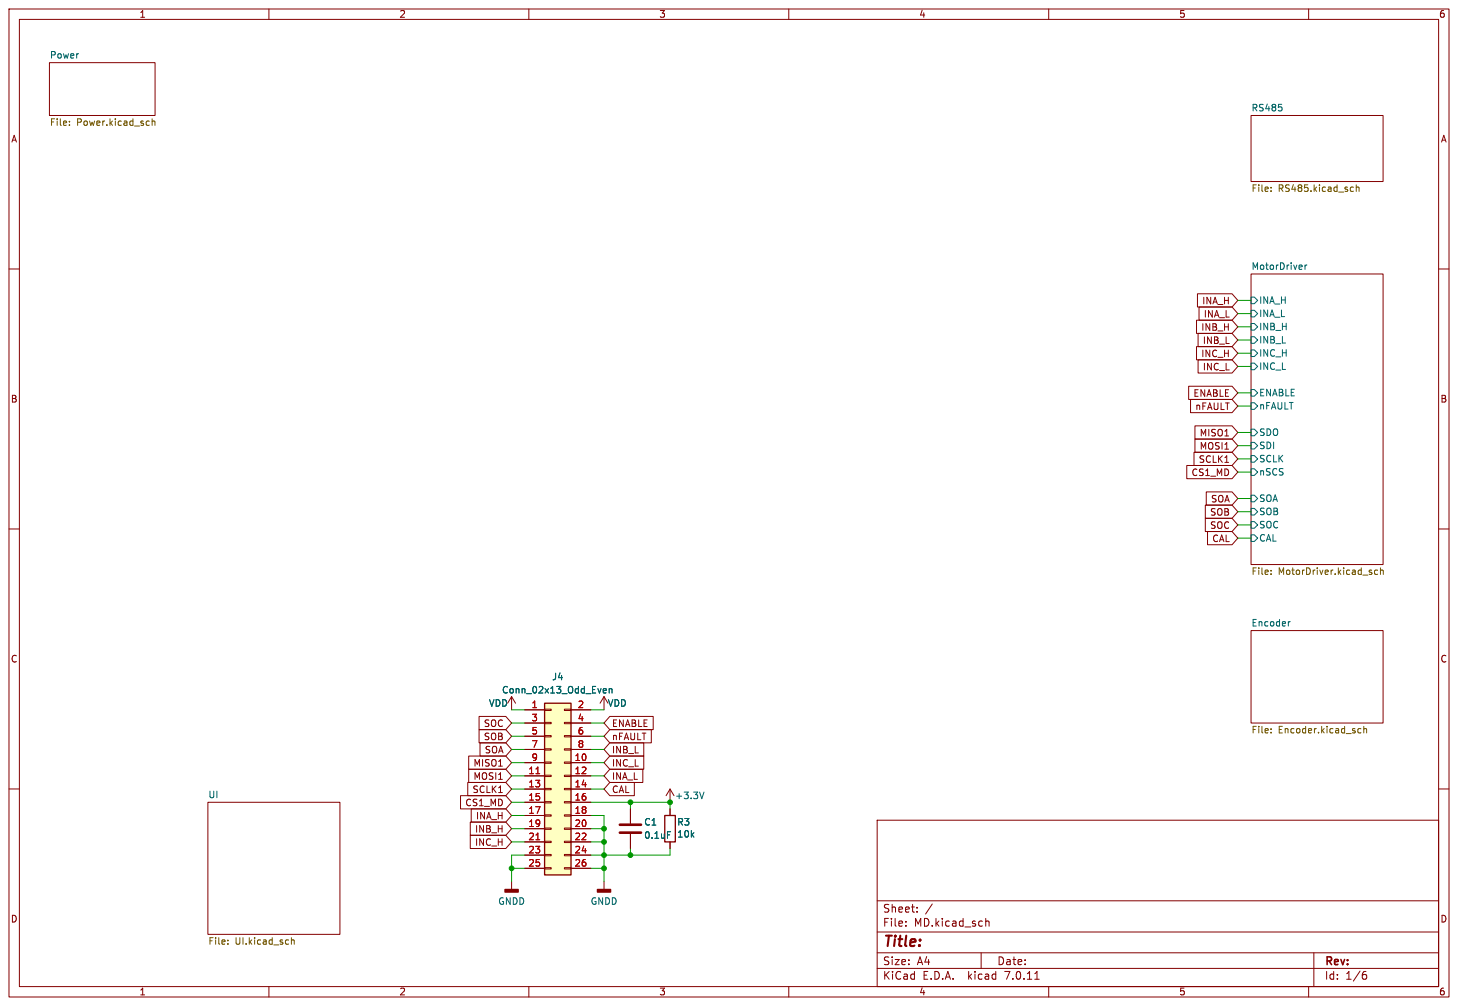
[picture p30: page 1]

Id: 1/6 Title: File: MD.kicad_sch Sheet: /

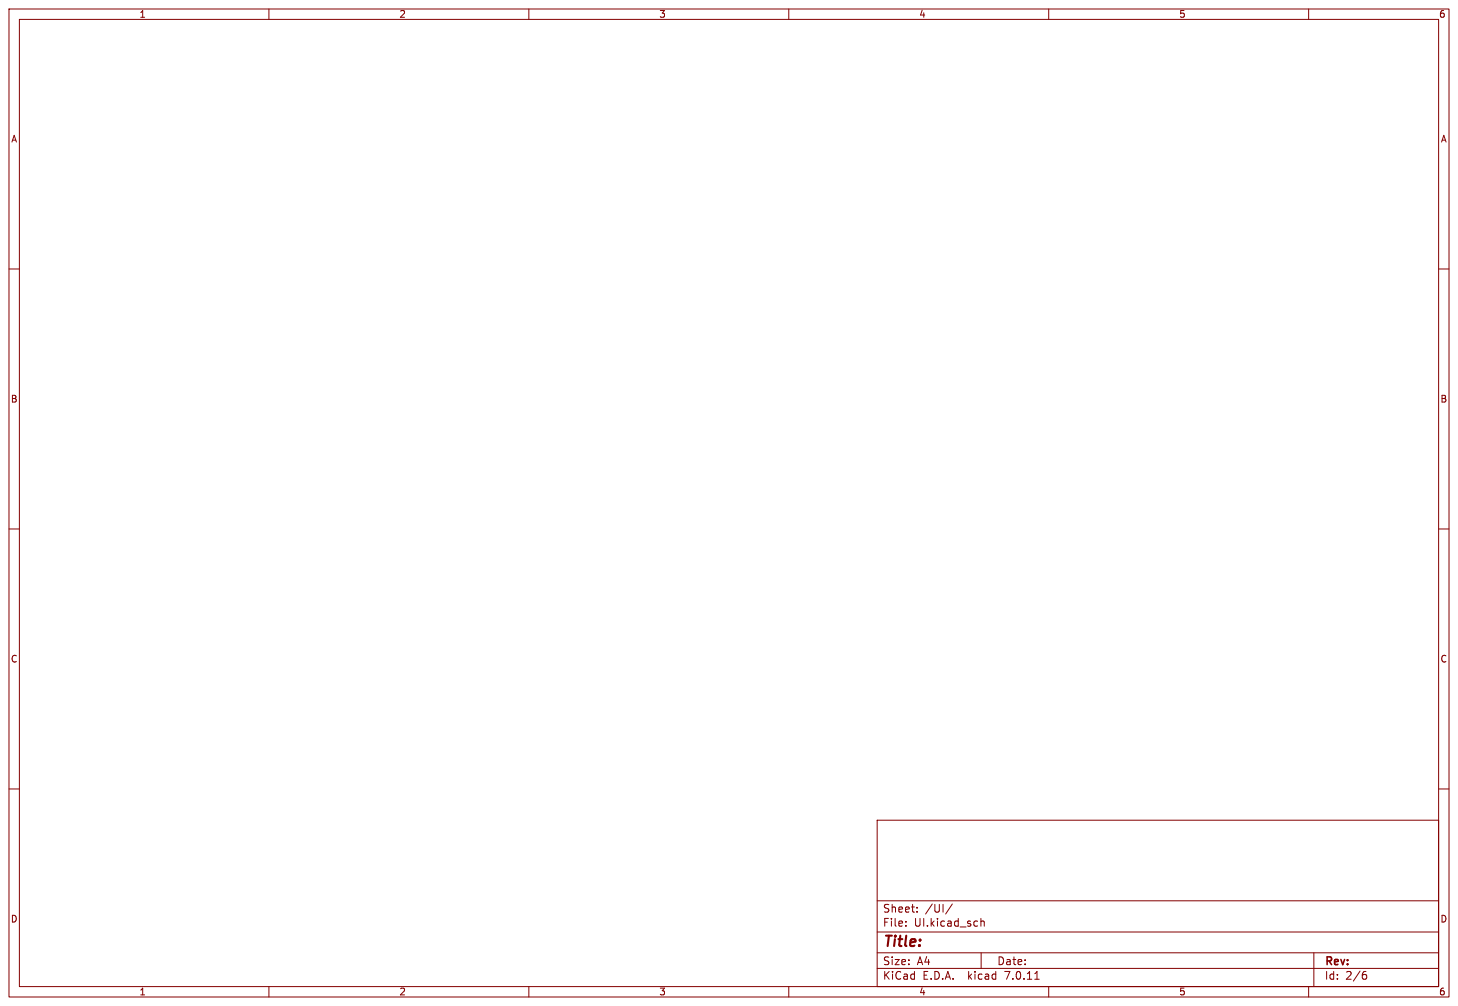
[picture p31: page 2]

Id: 2/6 Title: File: UI.kicad_sch Sheet: /UI/

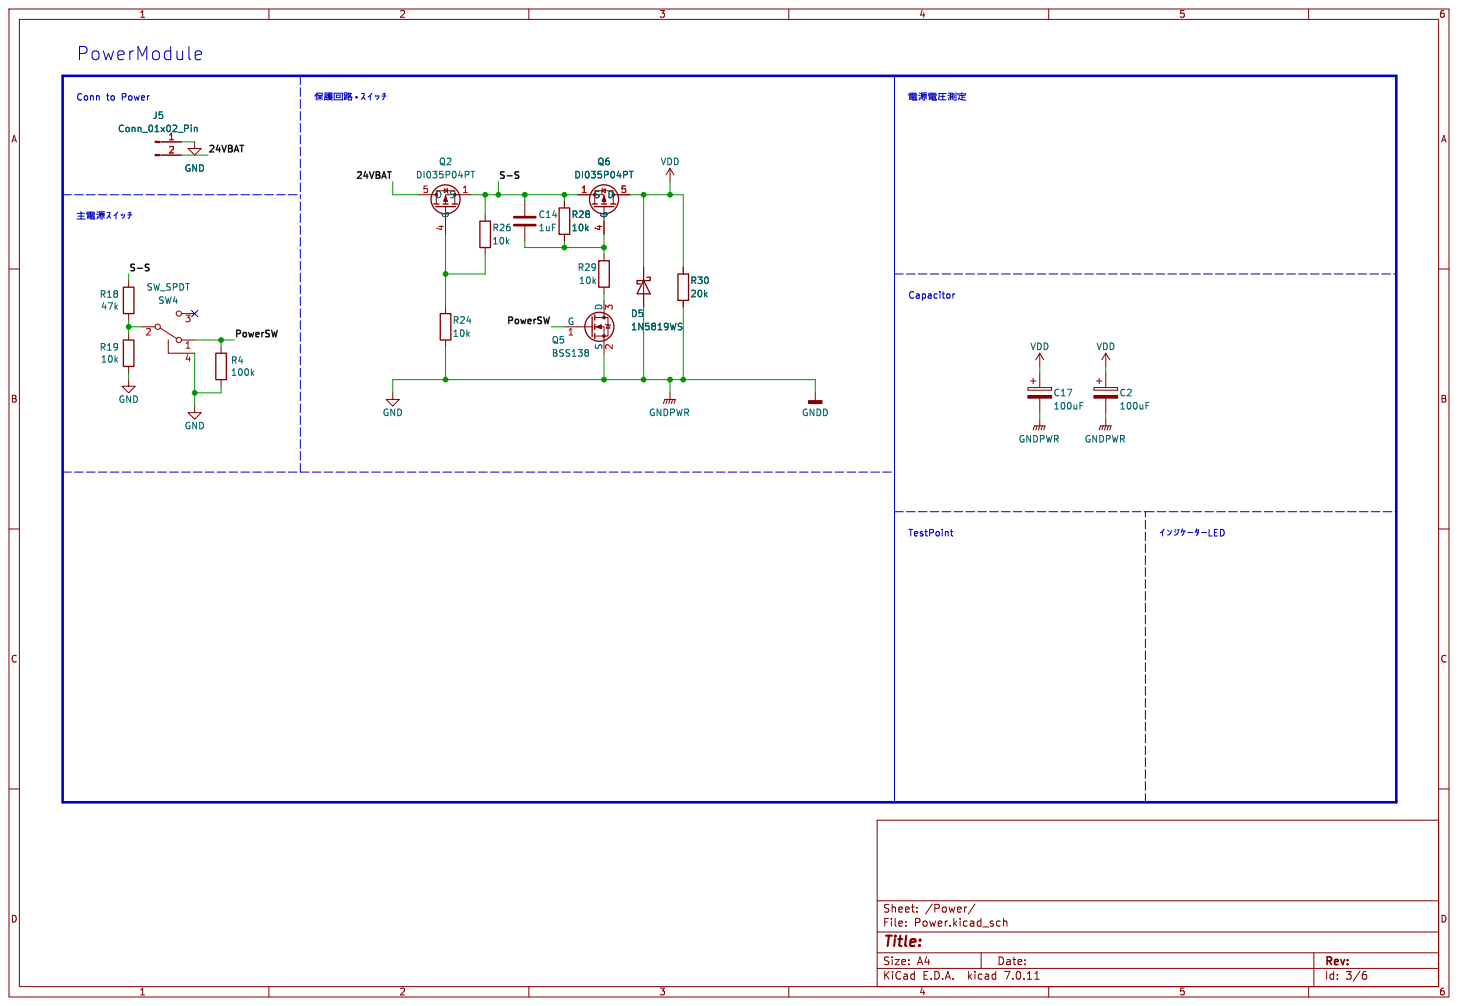
[picture p32: page 3]

Capacitor TestPoint Conn to Power þÿN;–ûn•0¹0¤0Ã0Á

J5 Conn_01x02_Pin J5 Conn_01x02_Pin 1 1 2 2 GND 24VBAT S-S | R28 | þÿ–ûn•–ûW'n,[š

Id: 3/6 Title: File: Power.kicad_sch Sheet: /Power/ GND

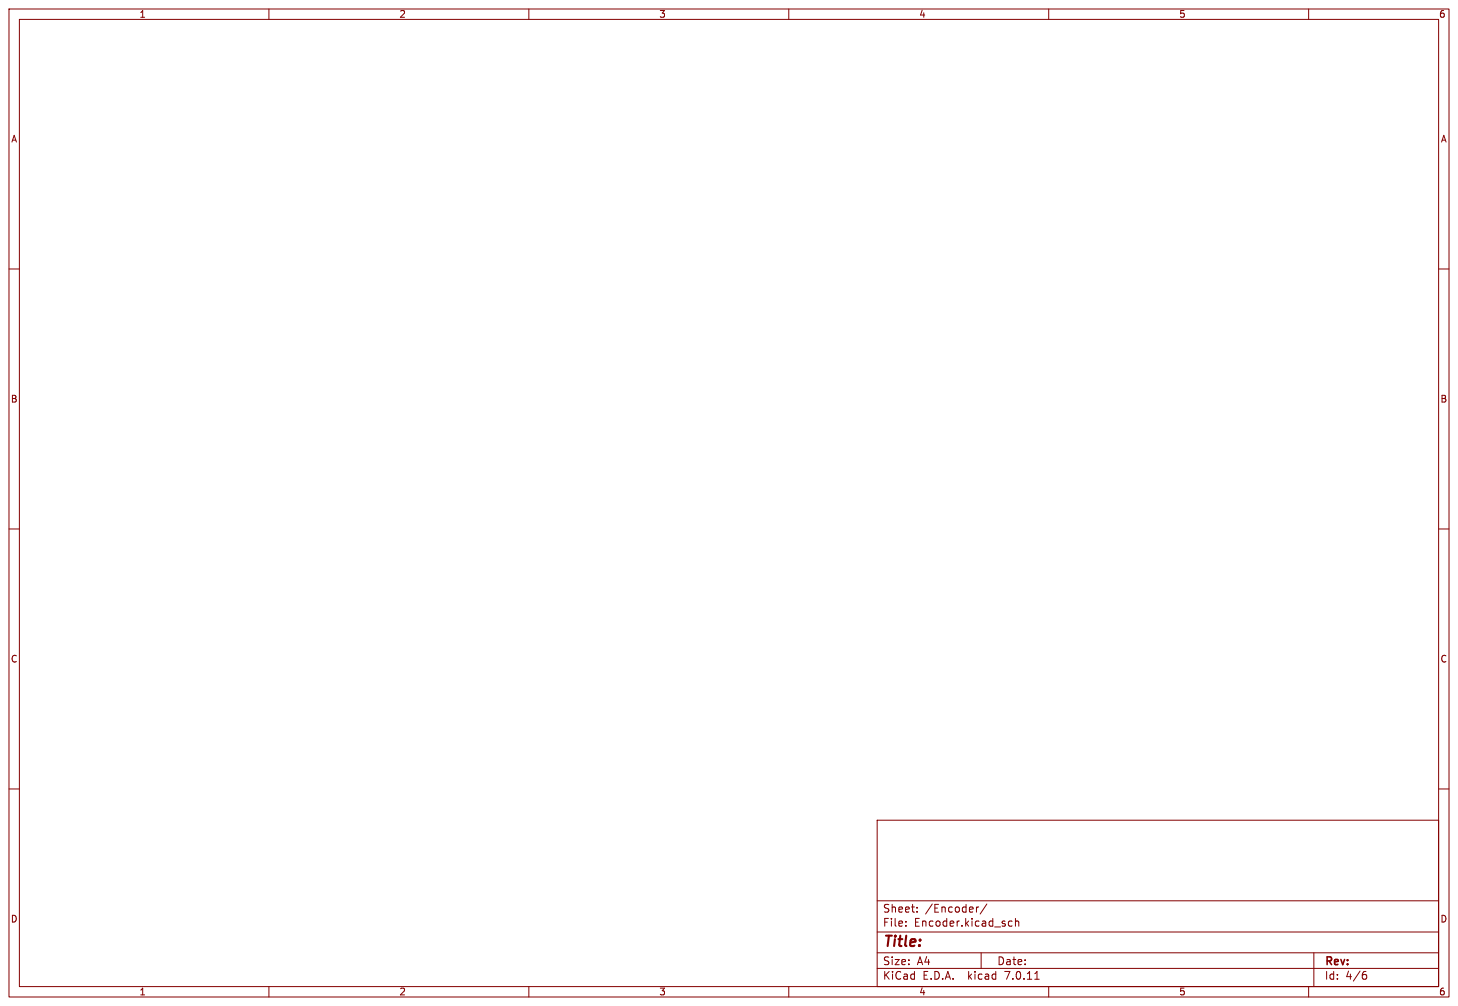
[picture p33: page 4]

Id: 4/6 Title: File: Encoder.kicad_sch Sheet: /Encoder/

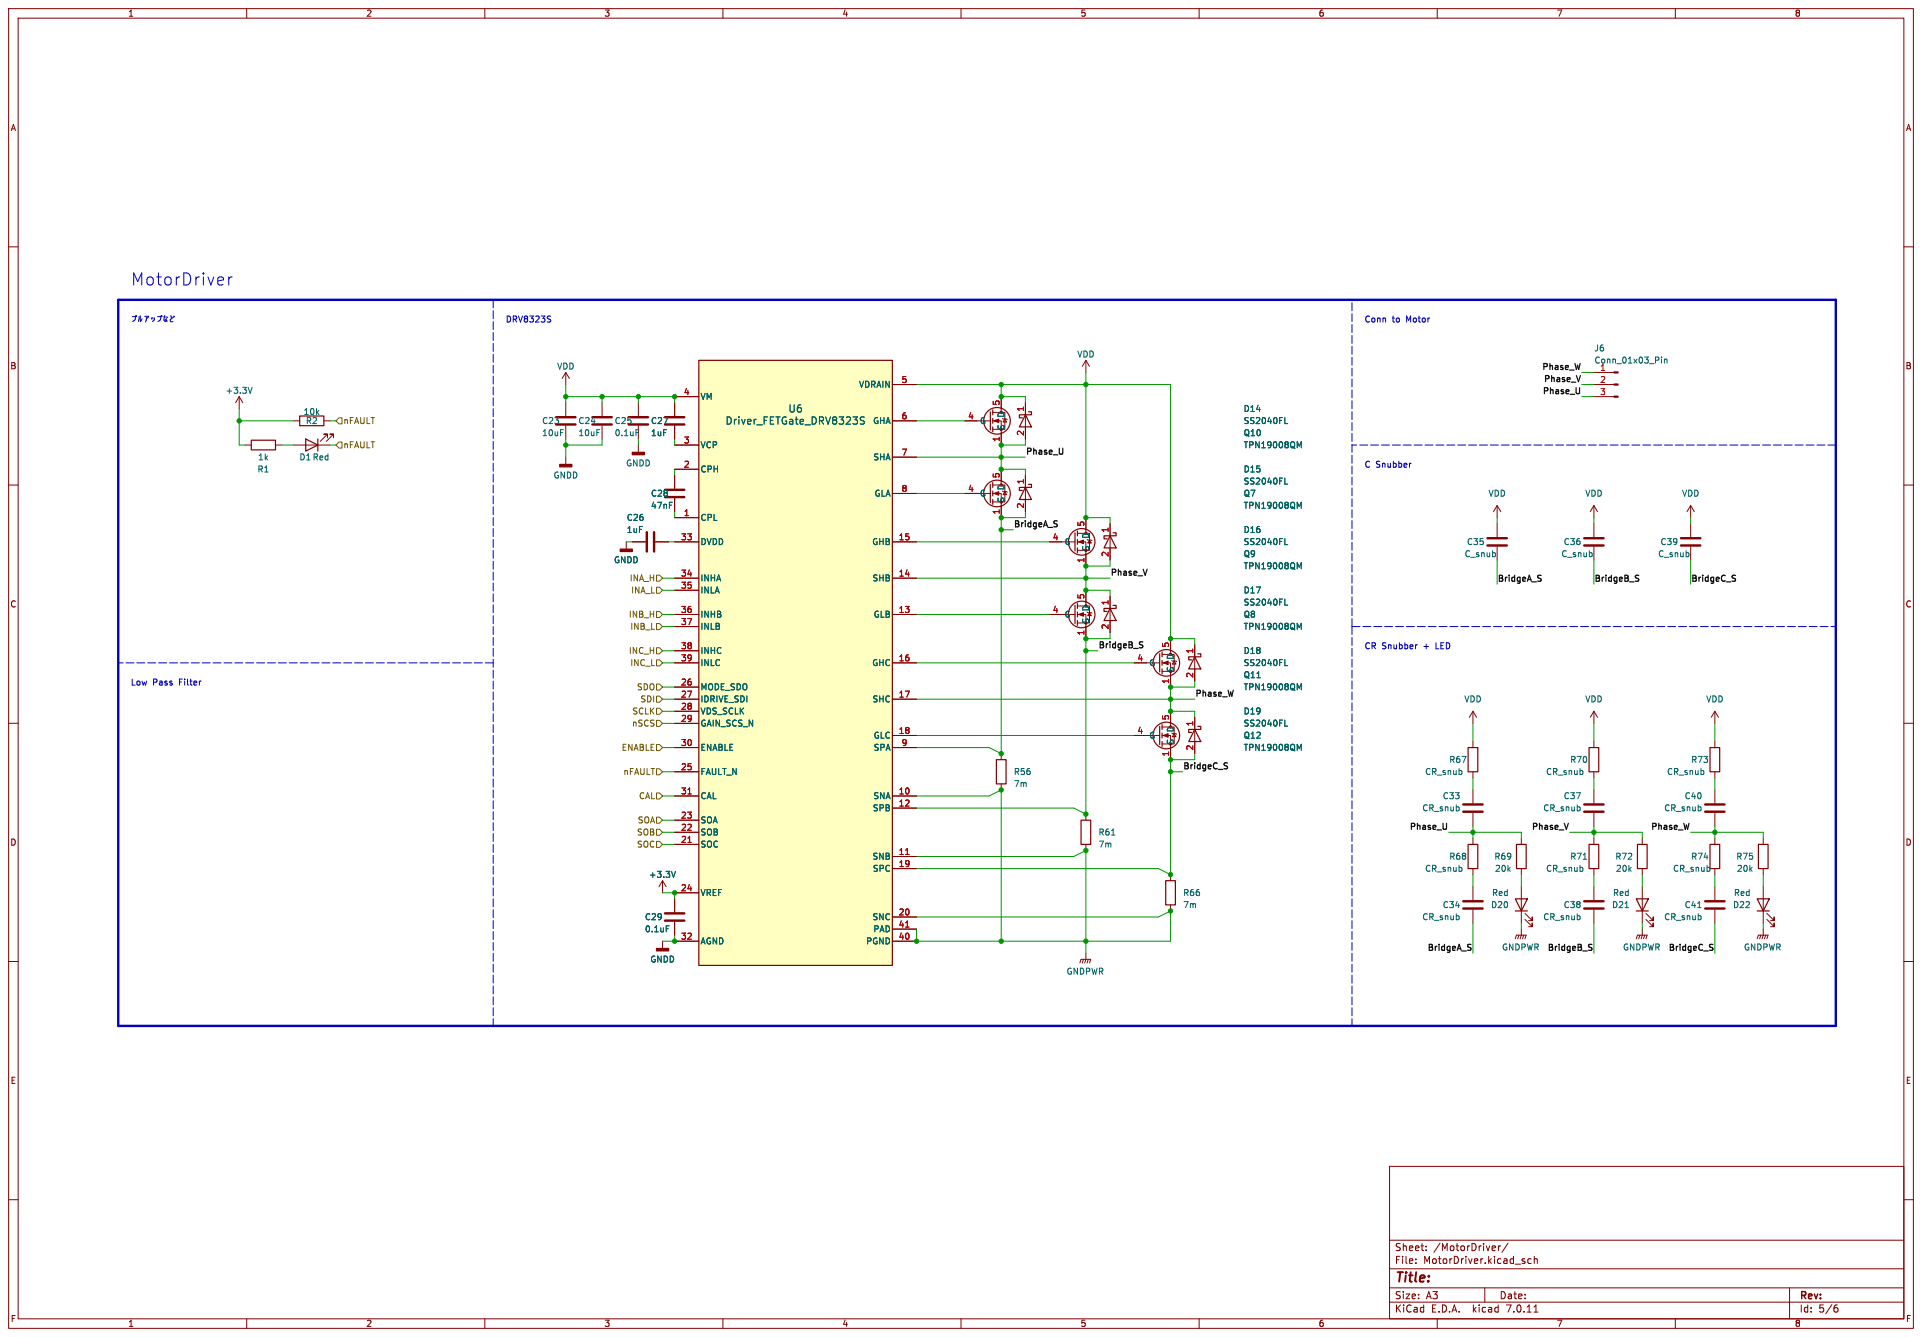
[picture p34: page 5]

1 2 D18 SS2040FL CPL 1 SNA 10 SNB 11 SPB 12 GLB 13 SHB 14 GHB 15 GHC 16 SHC 17 GLC 18 SPC 19 CPH 2 SNC 20 SOC 21 SOB 22 SOA 23 VREF 24 FAULT_N 25 MODE_SDO 26

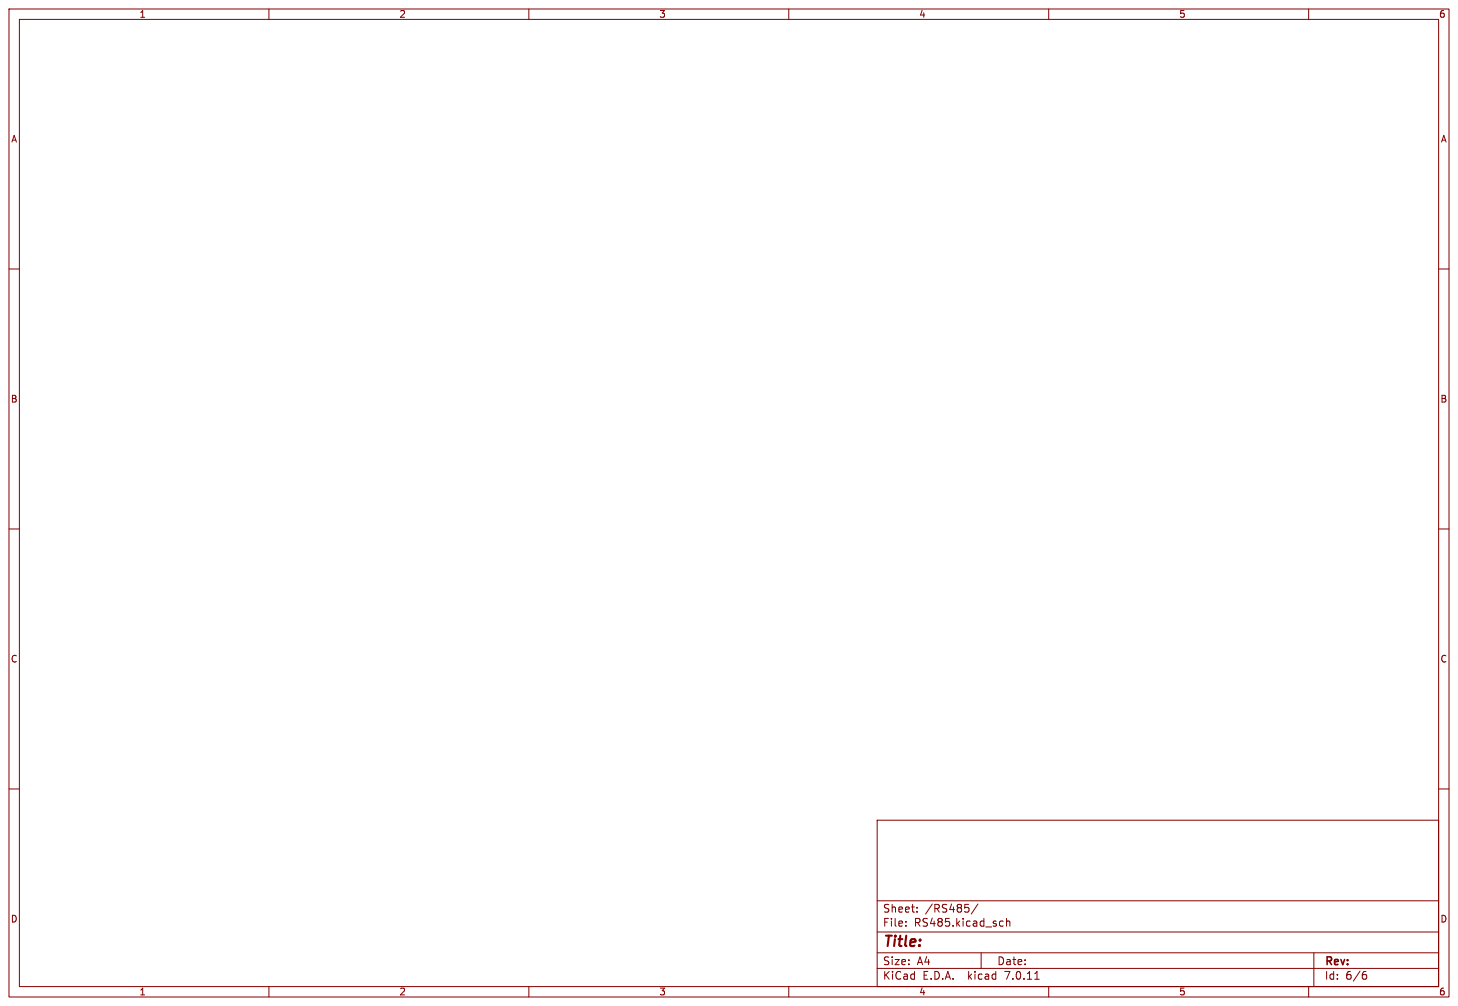
[picture p35: page 6]

Id: 6/6 Title: File: RS485.kicad_sch Sheet: /RS485/
