Tomoshibi-technology/MovingDisplay3-Circuit/circuits/Imposition/2ndLayer_3rdLayer/2ndLayer_3rdLayer.pdf

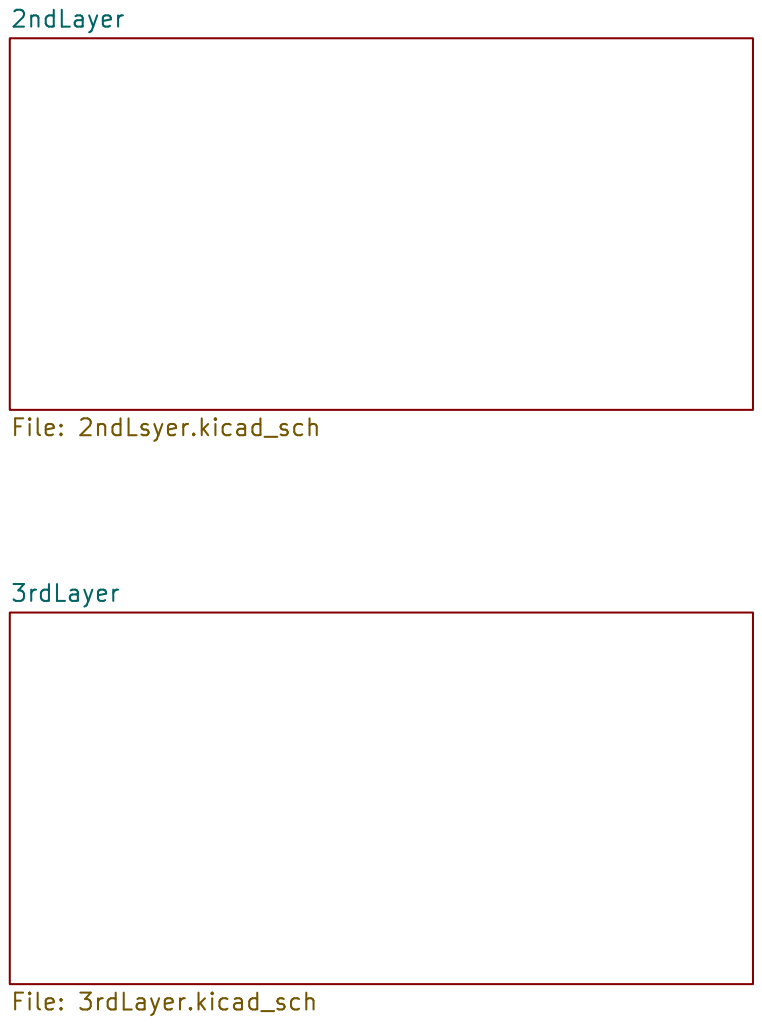
[picture p36: page 1]

Id: 1/7 Title: File: 2ndLayer_3rdLayer.kicad_sch Sheet: /

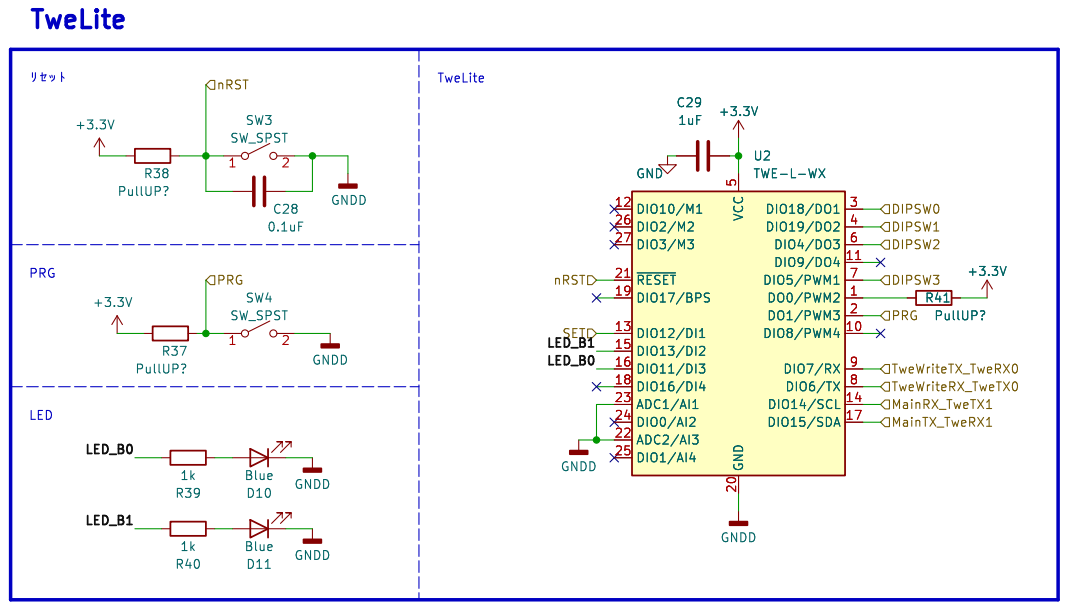
[picture p37: page 2]

5 DIO4/DO3 6 DIO5/PWM1 7 DIO6/TX 8 DIO7/RX 9 U2 TWE-L-WX R41PullUP? +3.3V C28

Id: 2/7 Title: File: TweLite.kicad_sch Sheet: /2ndLayer/TweLite/ R39

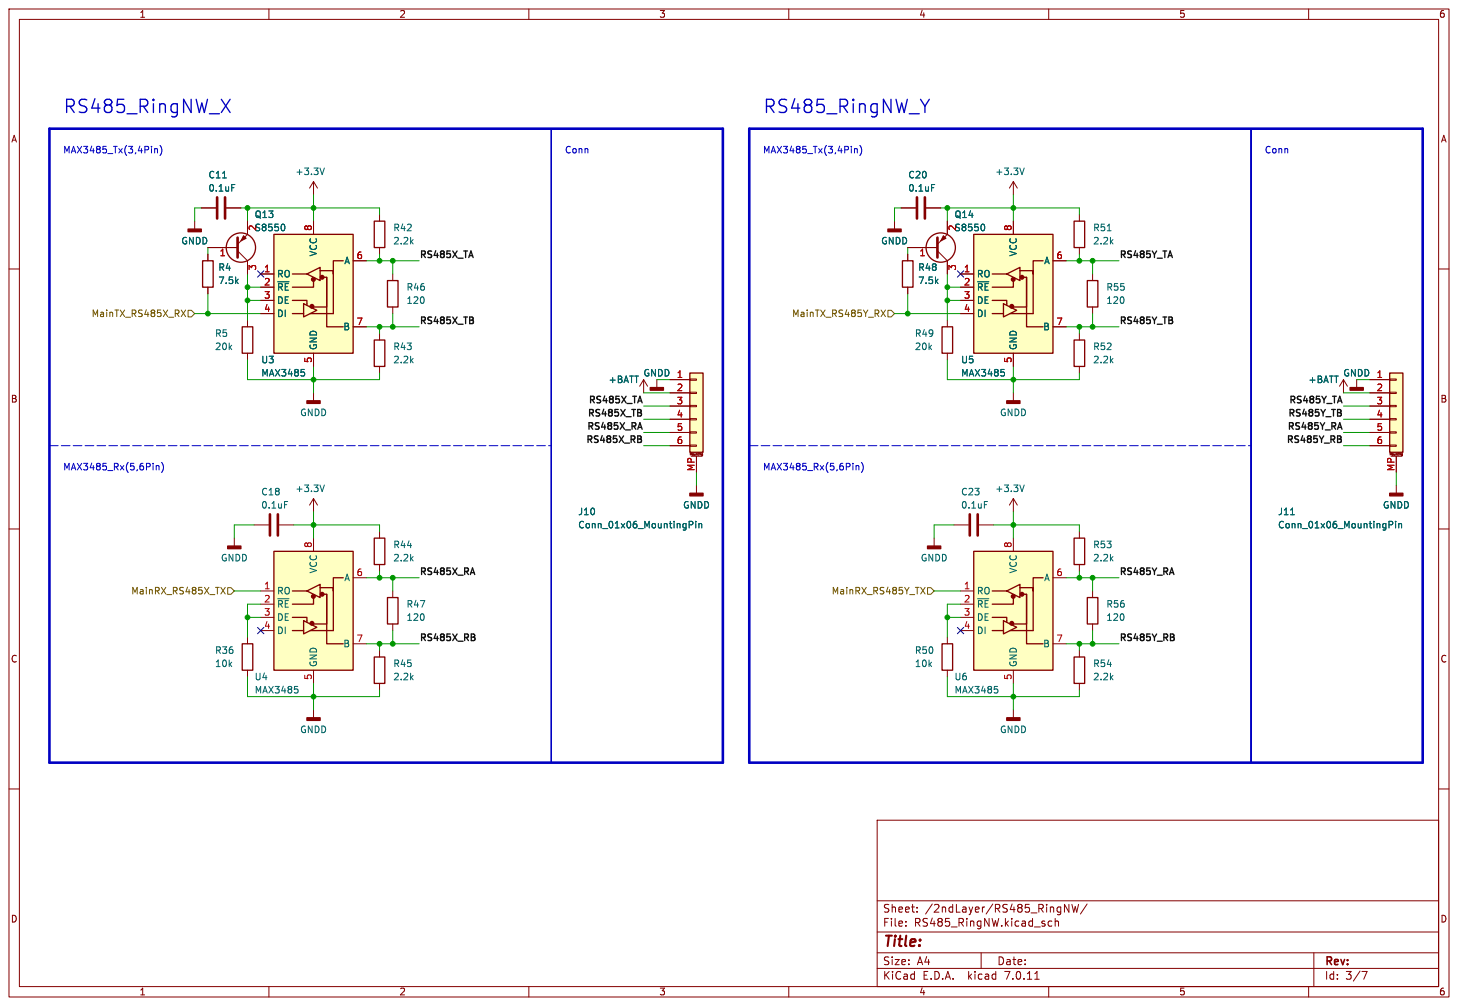
[picture p38: page 3]

2 3 U3 MAX3485 RO 1 ~{RE} 2 DE 3 DI 4 GND

Id: 3/7 Title: File: RS485_RingNW.kicad_sch Sheet: /2ndLayer/RS485_RingNW/

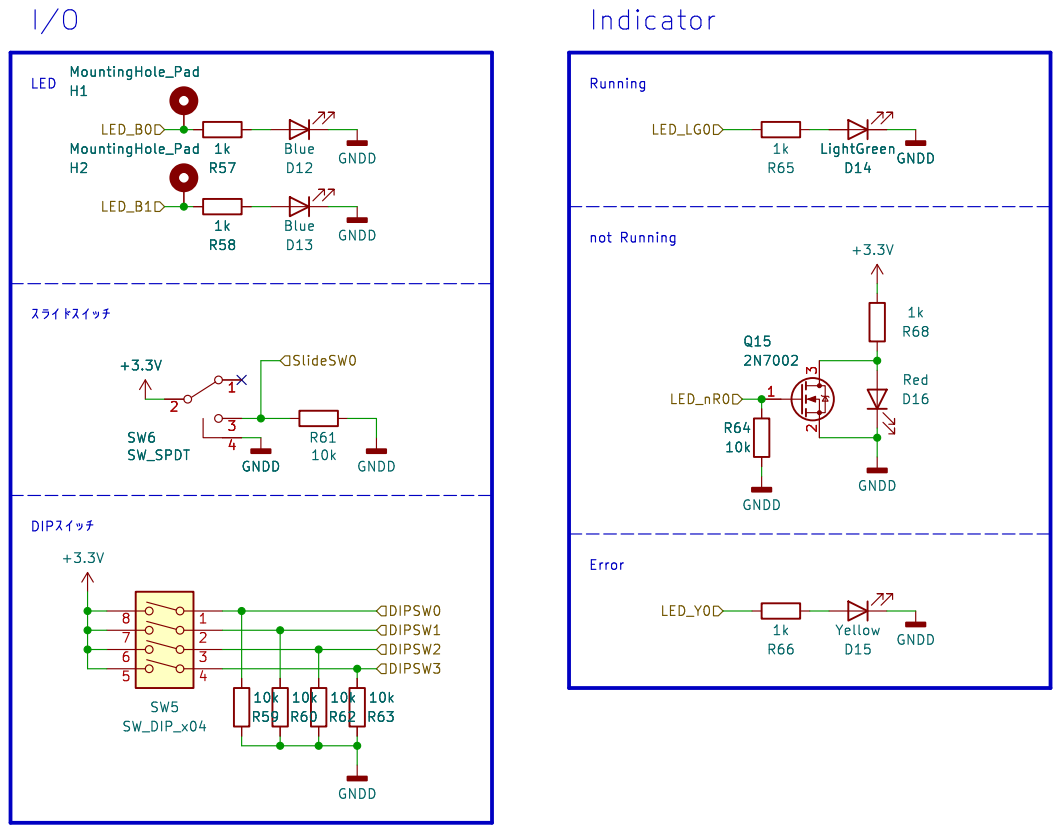
[picture p39: page 4]

not Running Error Running

Id: 4/7 Title: File: UI.kicad_sch Sheet: /2ndLayer/UI/

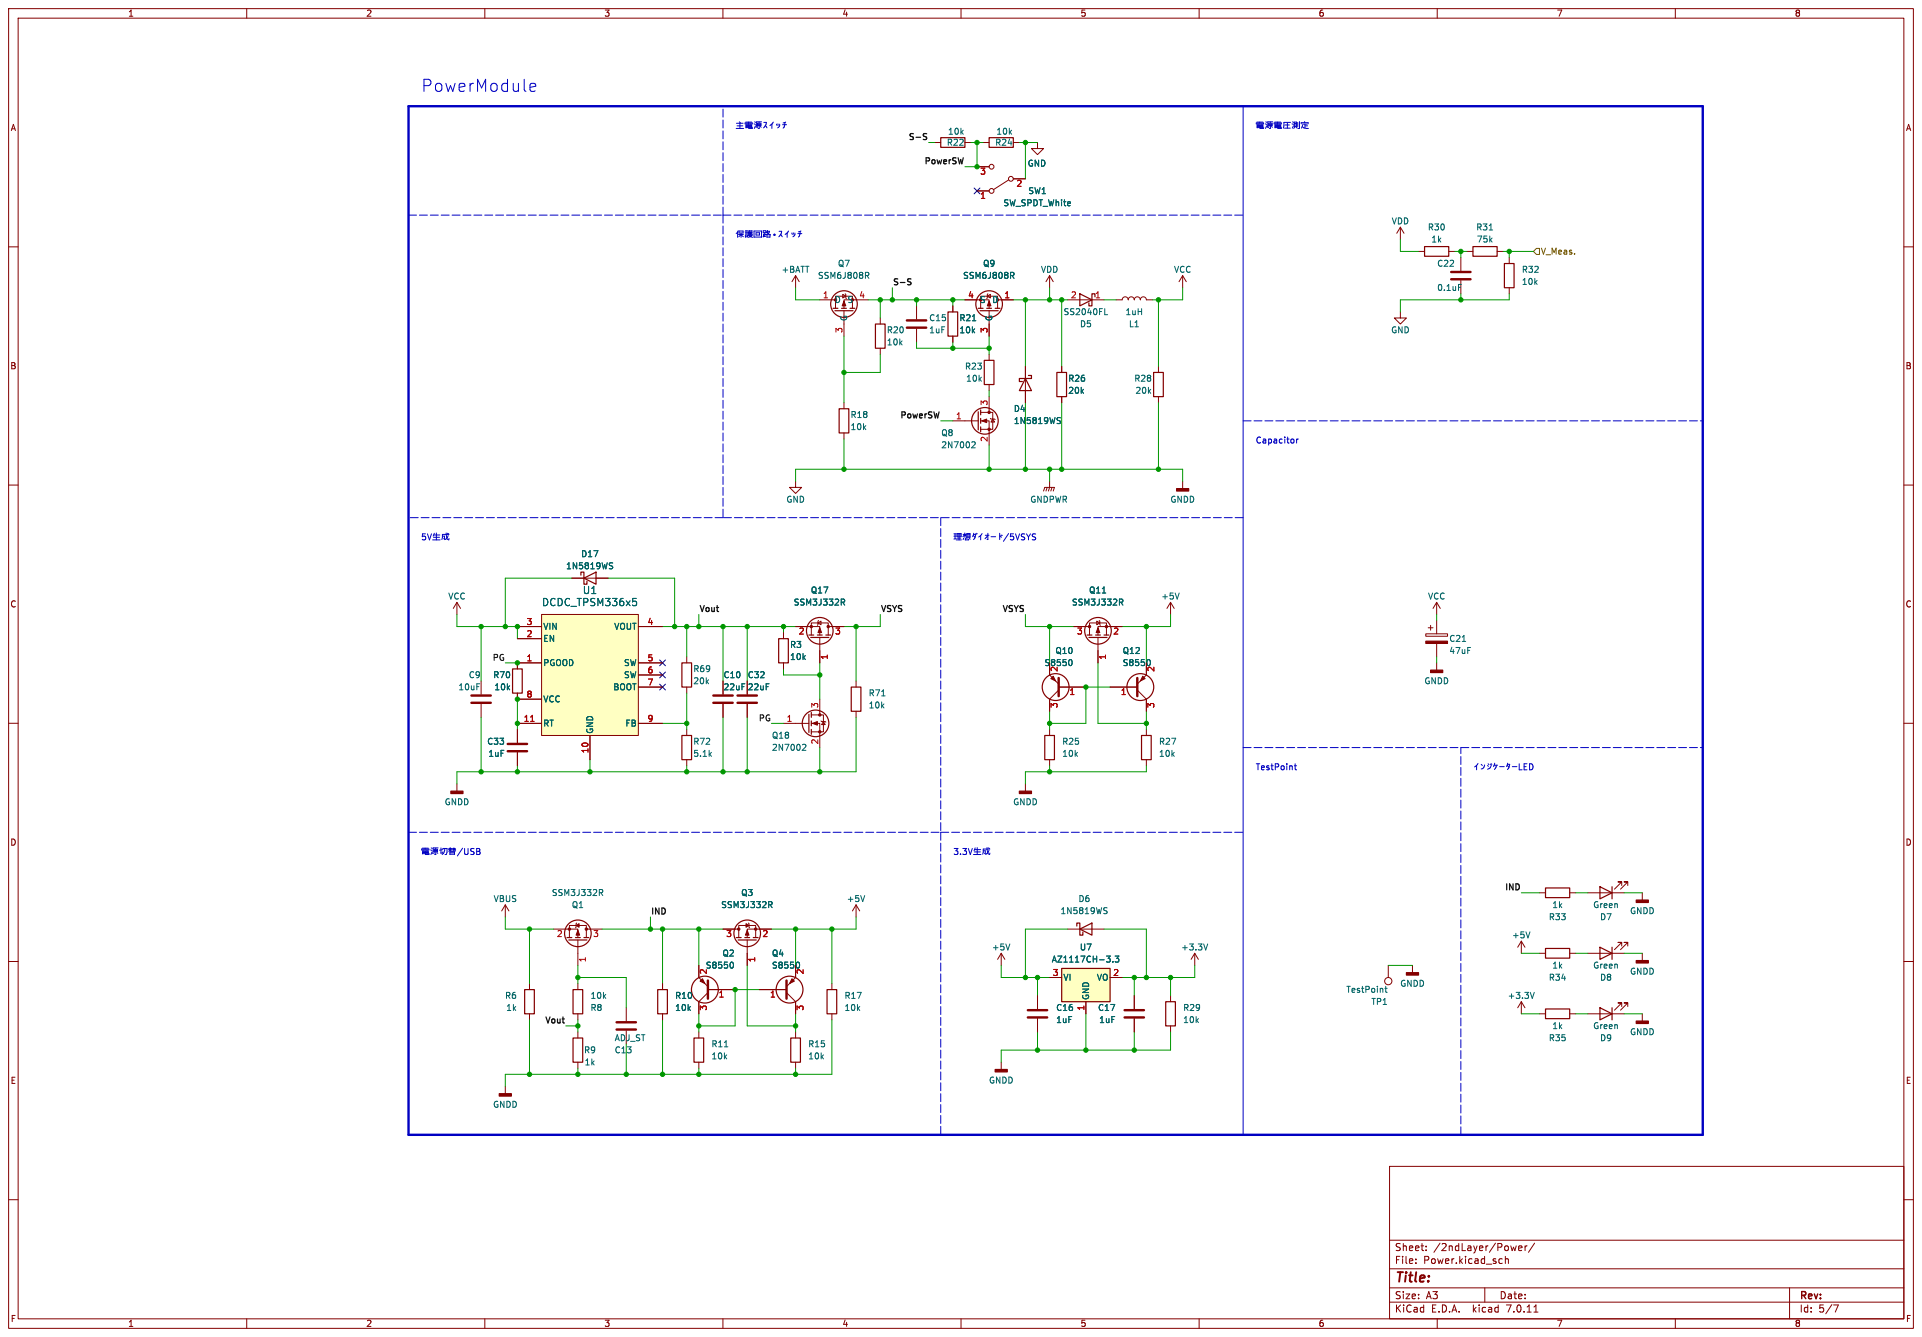
[picture p40: page 5]

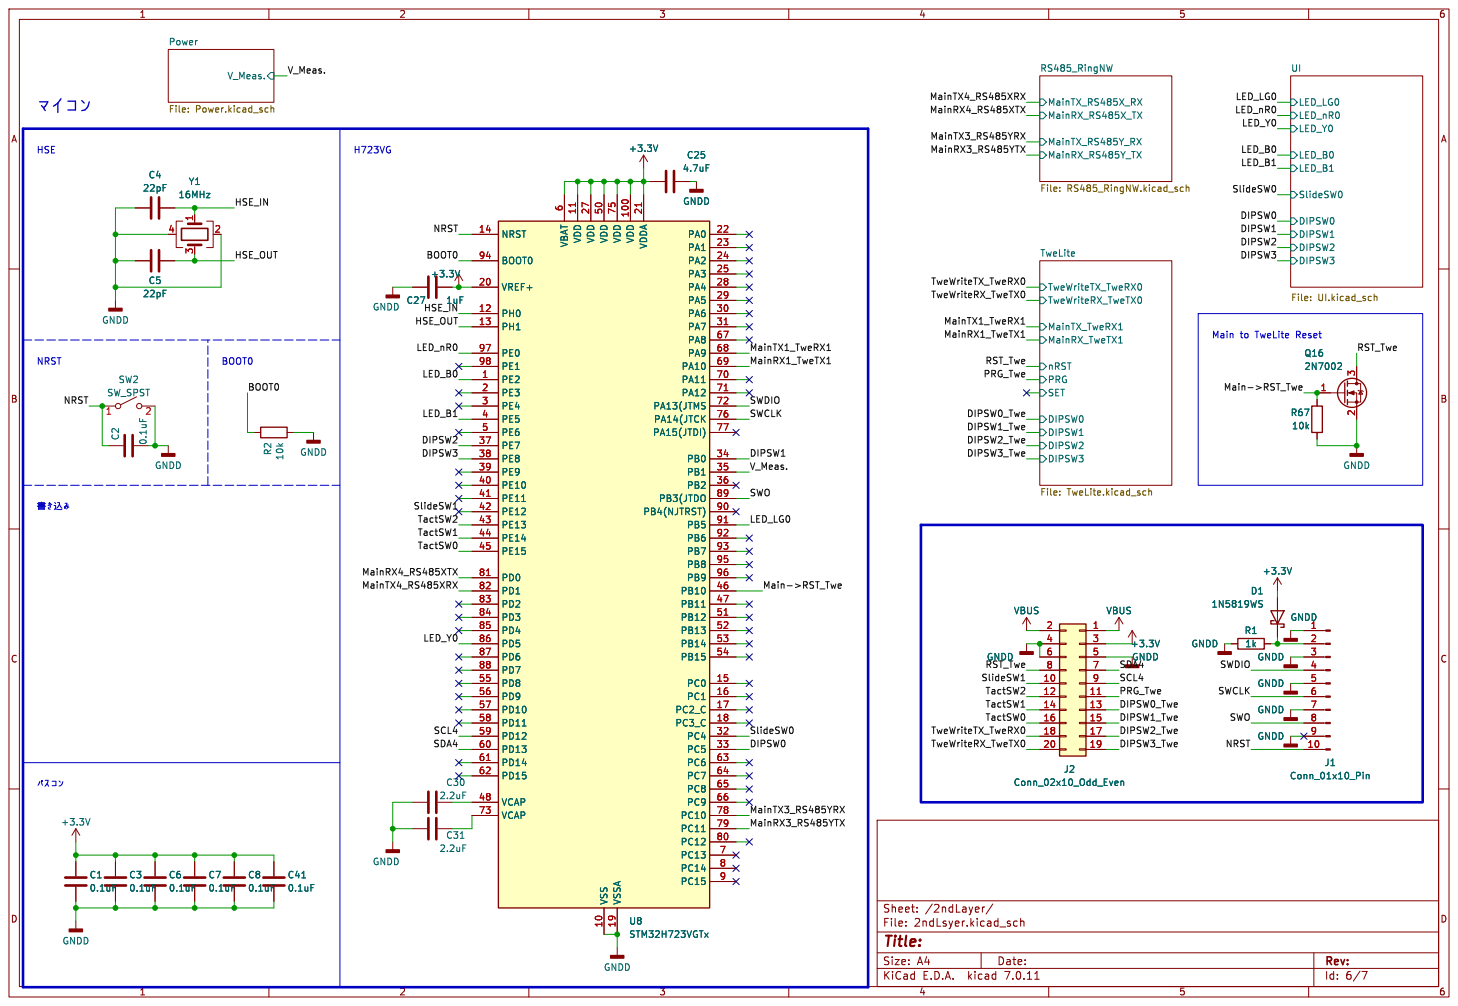
[picture p41: page 6]

9 GNDD GNDD GNDD GNDD

Id: 6/7 Title: File: 2ndLsyer.kicad_sch Sheet: /2ndLayer/

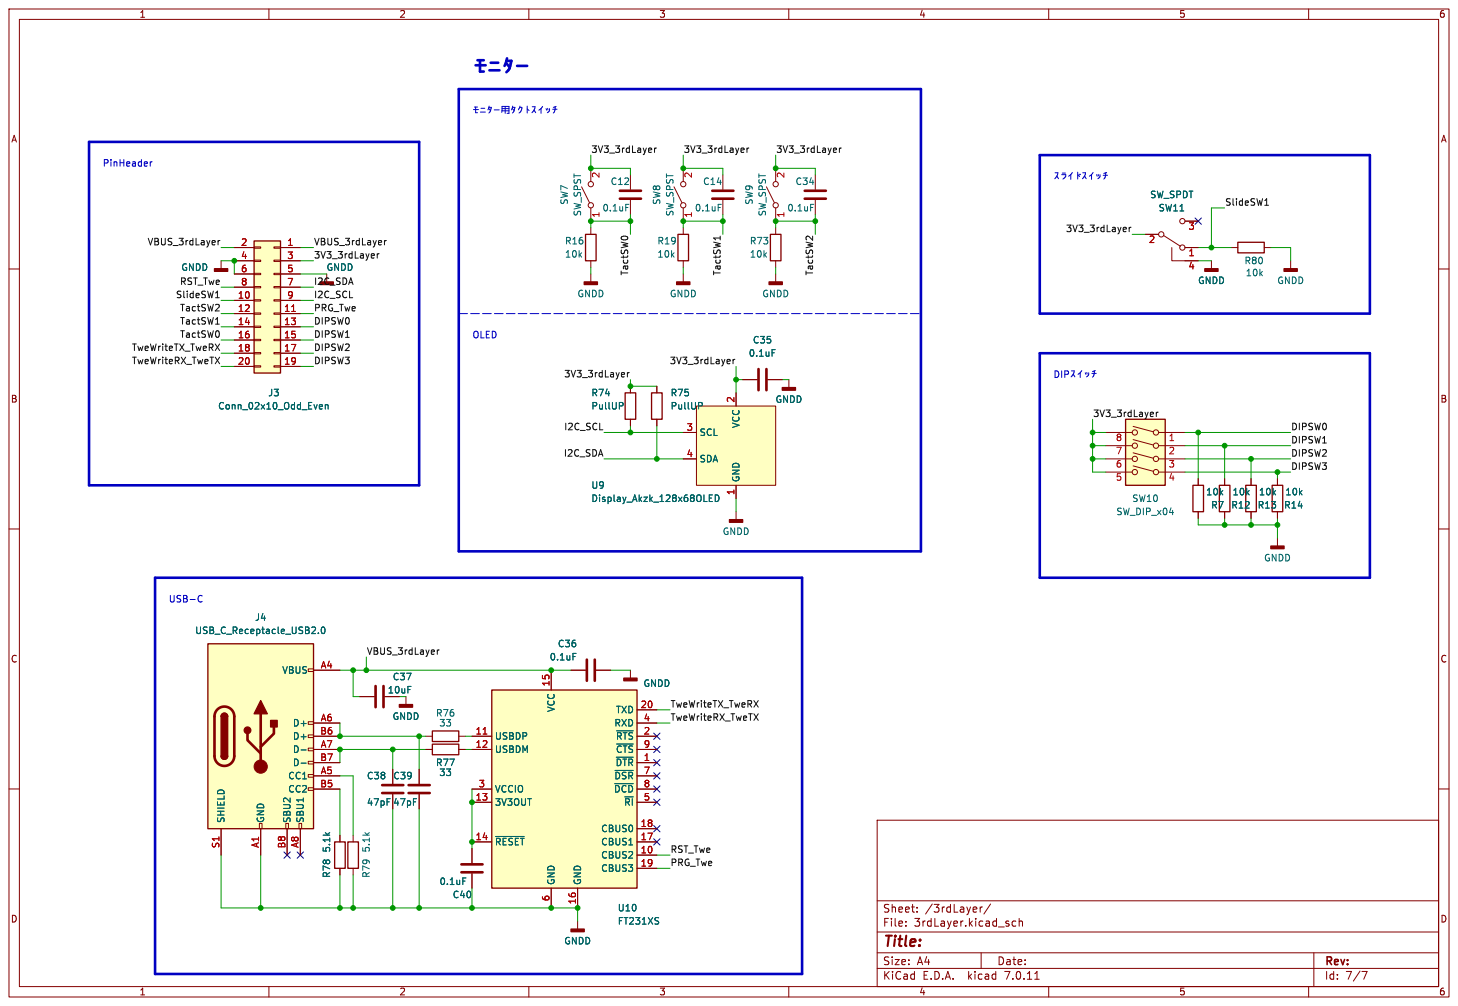
[picture p42: page 7]

6 ~{DSR}7 ~{DCD}8 ~{CTS}9 R78 5.1k GNDD

Id: 7/7 Title: File: 3rdLayer.kicad_sch Sheet: /3rdLayer/
