Tomoshibi-technology/MovingDisplay3-Circuit/circuits/Imposition/1stLayer_Power/1stLayer_Power.pdf

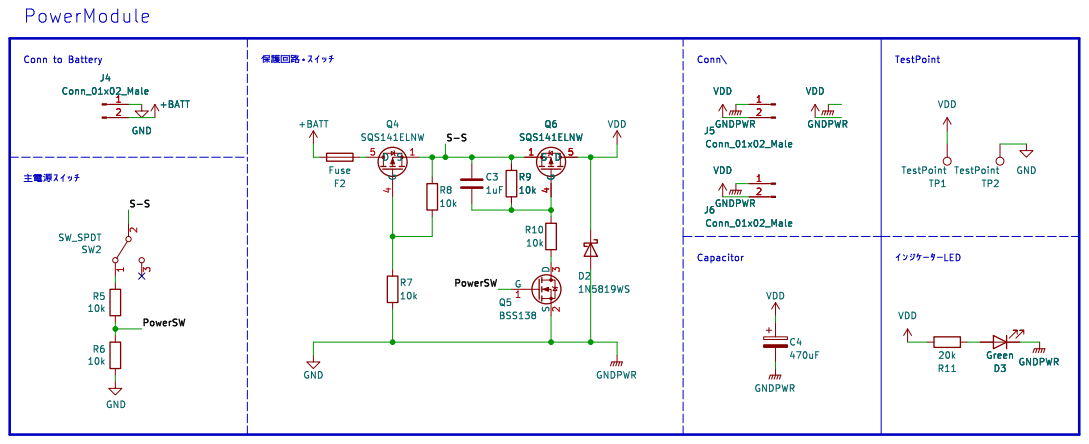
[picture p43: page 1]

Id: 1/1 Title: File: Power.kicad_sch Sheet: /
