Tomoshibi-technology/MovingDisplay3-Circuit/circuits/Wireless/3rdLayer/3rdLayer.pdf

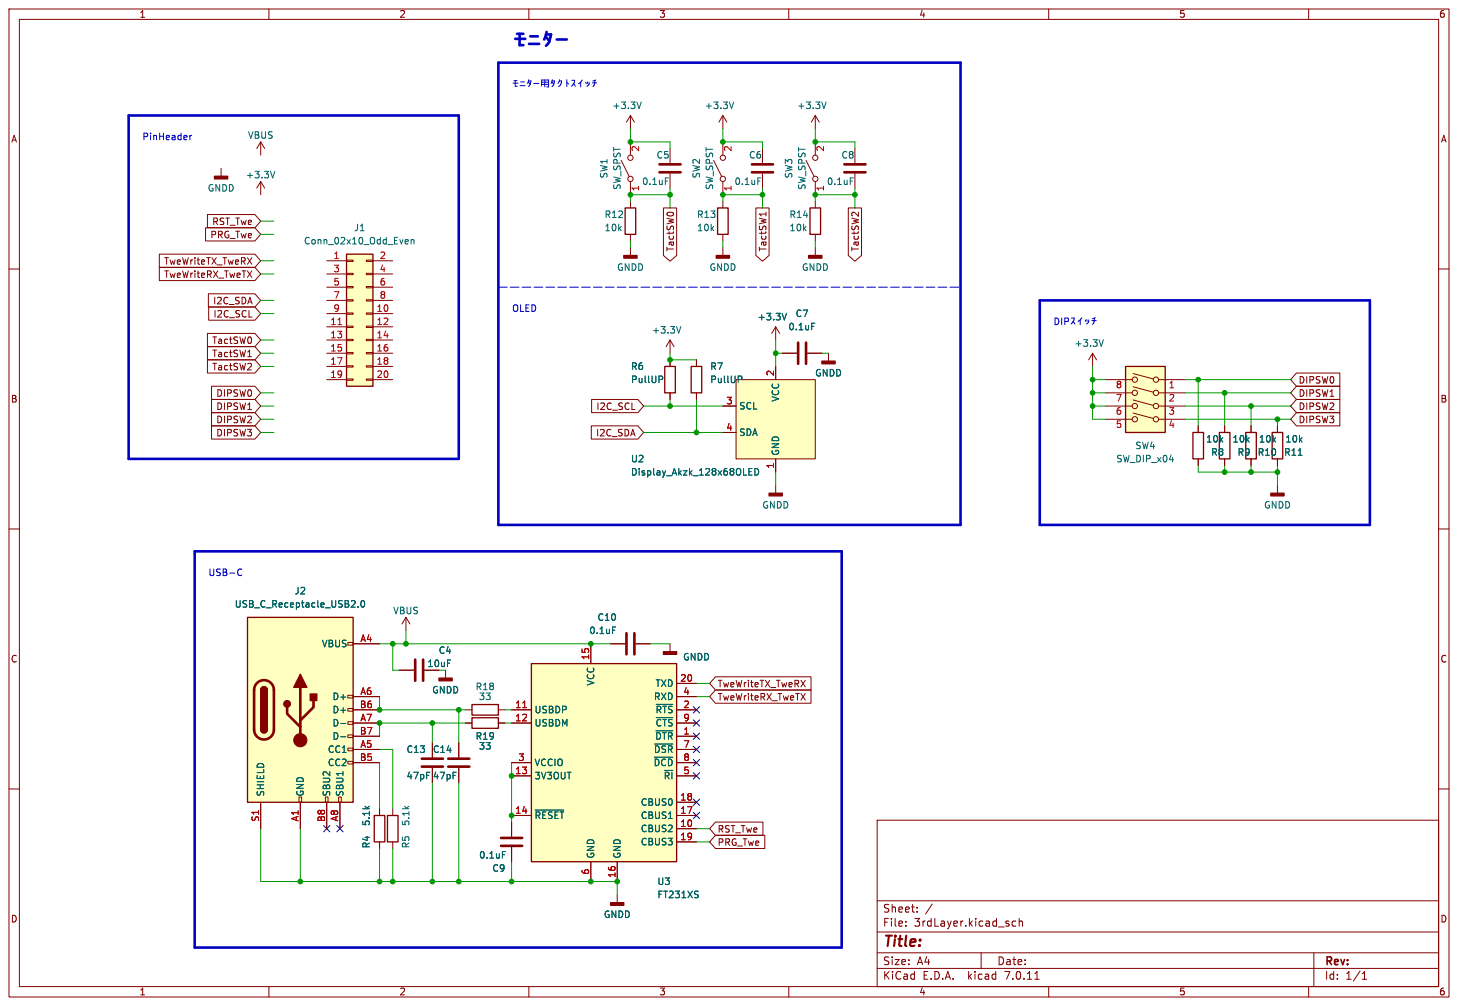
[picture p44: page 1]

Id: 1/1 Title: File: 3rdLayer.kicad_sch Sheet: /
