Tomoshibi-technology/MovingDisplay3-Circuit/circuits/Wireless/1stLayer/1stLayer.pdf

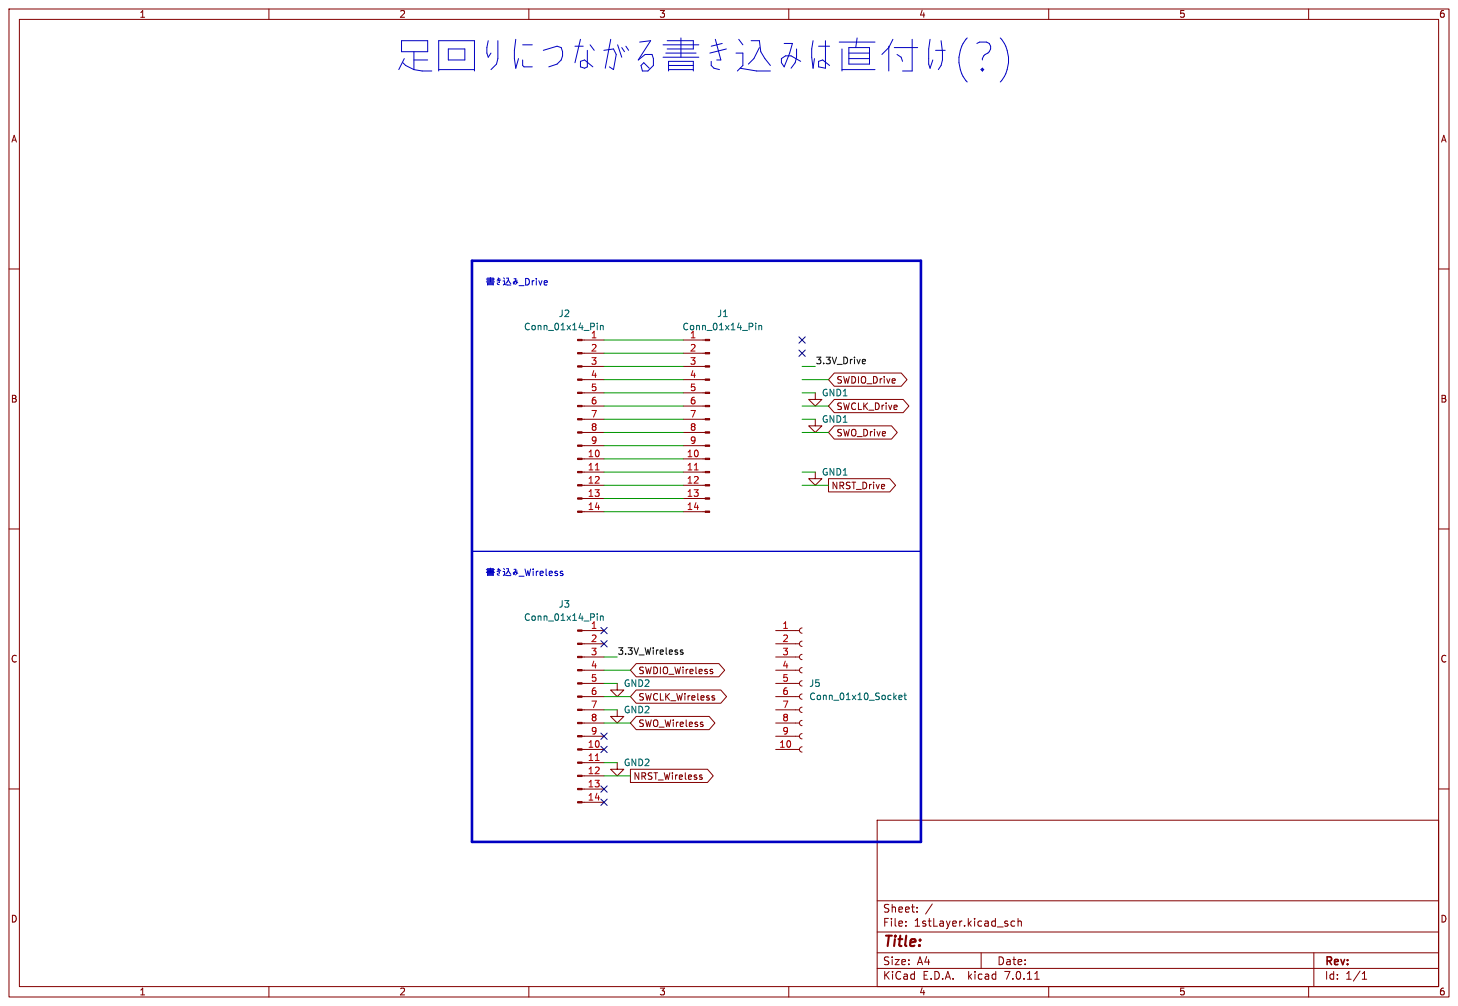
[picture p45: page 1]
