Tomoshibi-technology/MovingDisplay3-Circuit/circuits/archive/Wireless/2ndLayer/2ndLayer.pdf

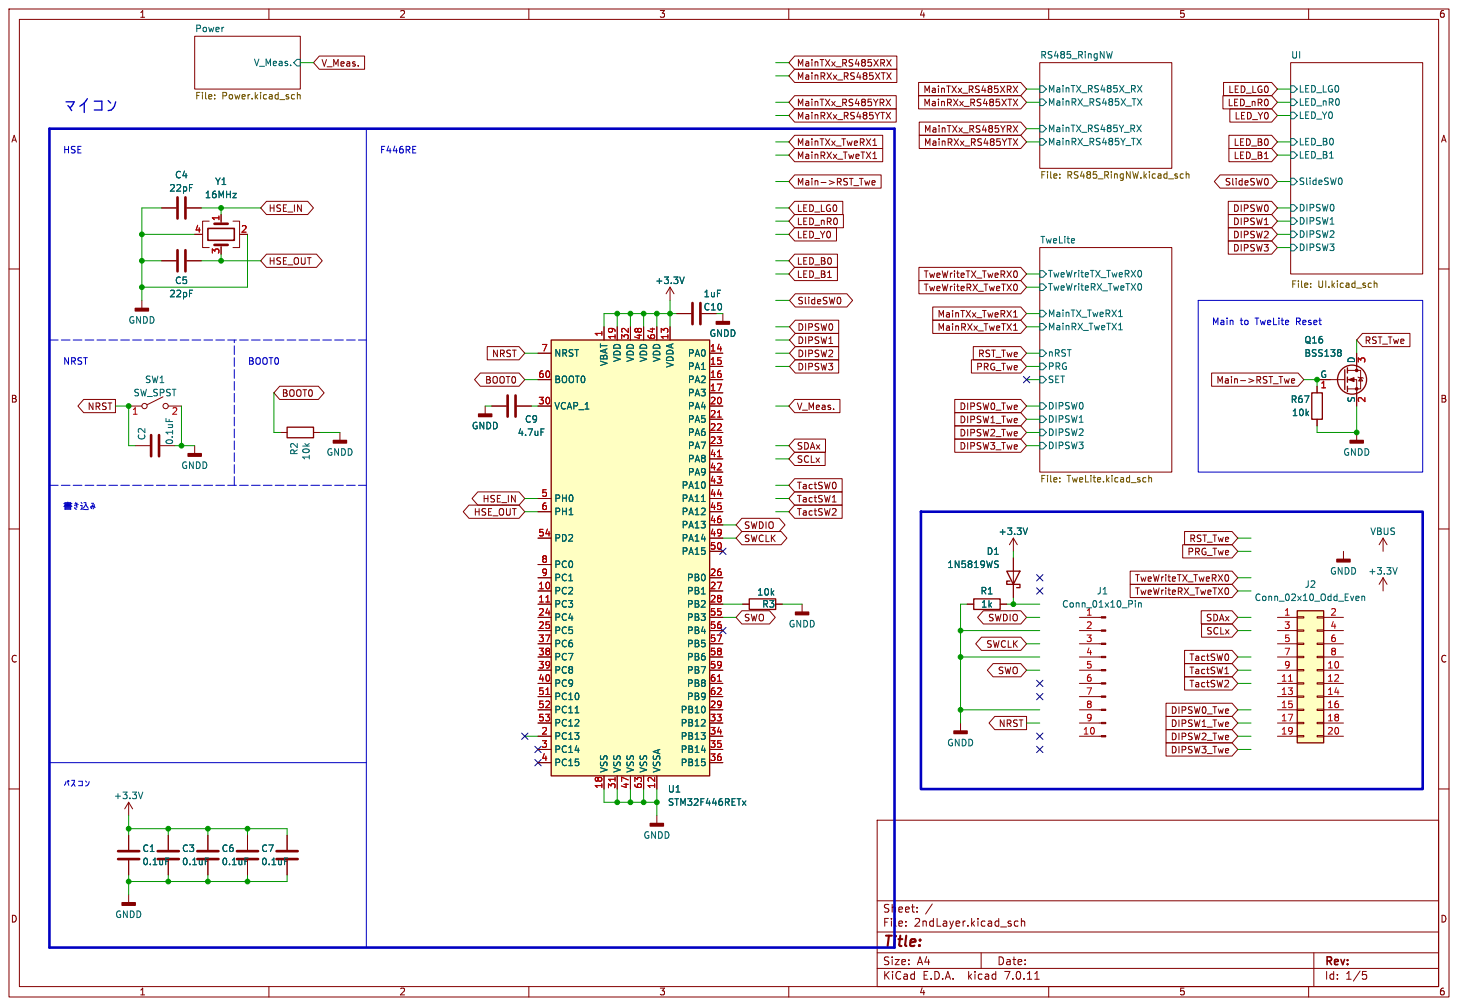
[picture p46: page 1]

1 PC2 10 PC3 11 VSSA 12 VDDA 13 PA0 14 PA1 15 PA2 16 PA3 17 VSS 18 VDD 19 PC13 2 PA4 20 PA5 21 PA6 22 PA7 23 PC4 24 PC5 25 PB0 26 PB1 27 PB2 28 PB10 29 PC14 3 VCAP_1 30 VSS 31 VDD 32 PB12 33 PB13 34 PB14 35 PB15 36 PC6 37 PC7 38 PC8 39 PC15 4 PC9 40 PA8 41 PA9 42 PA10 43 PA11 44 PA12 45 PA13 46 VSS 47 VDD 48 PA14 49 PH0 5 PA15 50 PC10 51 PC11 52 PC12 53 PD2 54 PB3 55 PB4 56 PB5 57 PB6 58 PB7 59 PH1 6 BOOT0 60 PB8 61 PB9 62 VSS 63 VDD 64 NRST 7 PC0 8 PC1 9 U1STM32F446RETx GNDD

1 PC2 10 PC3 11 VSSA 12 VDDA 13 PA0 14 PA1 15 PA2 16 PA3 17 VSS 18 VDD 19 PC13 2 PA4 20 PA5 21 PA6 22 PA7 23 PC4 24 PC5 25 PB0 26 PB1 27 PB2 28 PB10 29 PC14 3 VCAP_1 30 VSS 31 VDD 32 PB12 33 PB13 34 PB14 35 PB15 36 PC6 37 PC7 38 PC8 39 PC15 4 PC9 40 PA8 41 PA9 42 PA10 43 PA11 44 PA12 45 PA13 46 VSS 47 VDD 48 PA14 49 PH0 5 PA15 50 PC10 51 PC11 52 PC12 53 PD2 54 PB3 55 PB4 56 PB5 57 PB6 58 PB7 59 PH1 6 BOOT0 60 PB8 61 PB9 62 VSS 63 VDD 64 NRST 7 PC0 8 PC1 9 R3

Id: 1/5 Title: File: 2ndLayer.kicad_sch Sheet: /

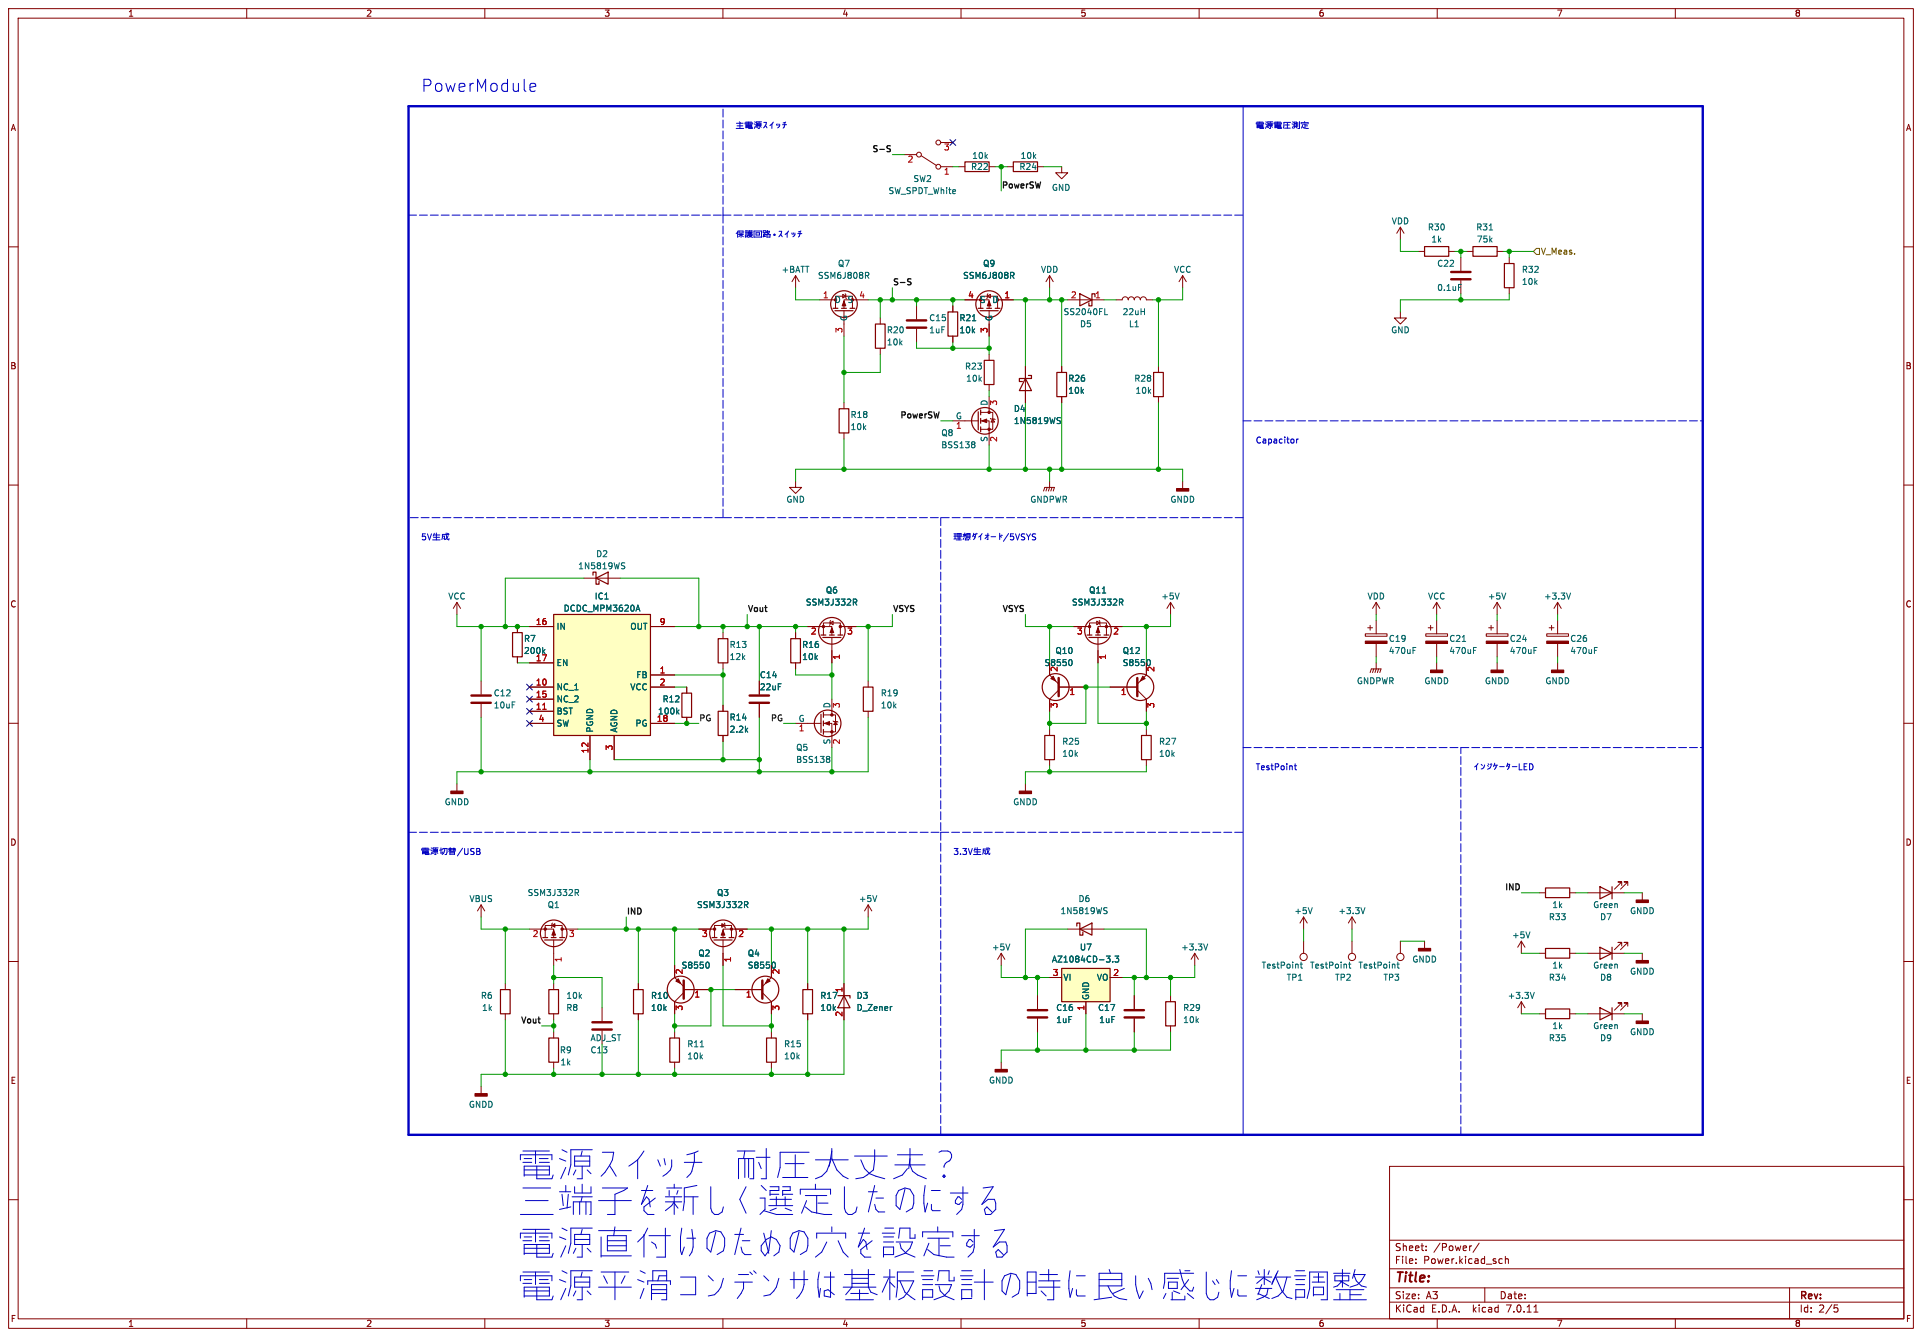
[picture p47: page 2]

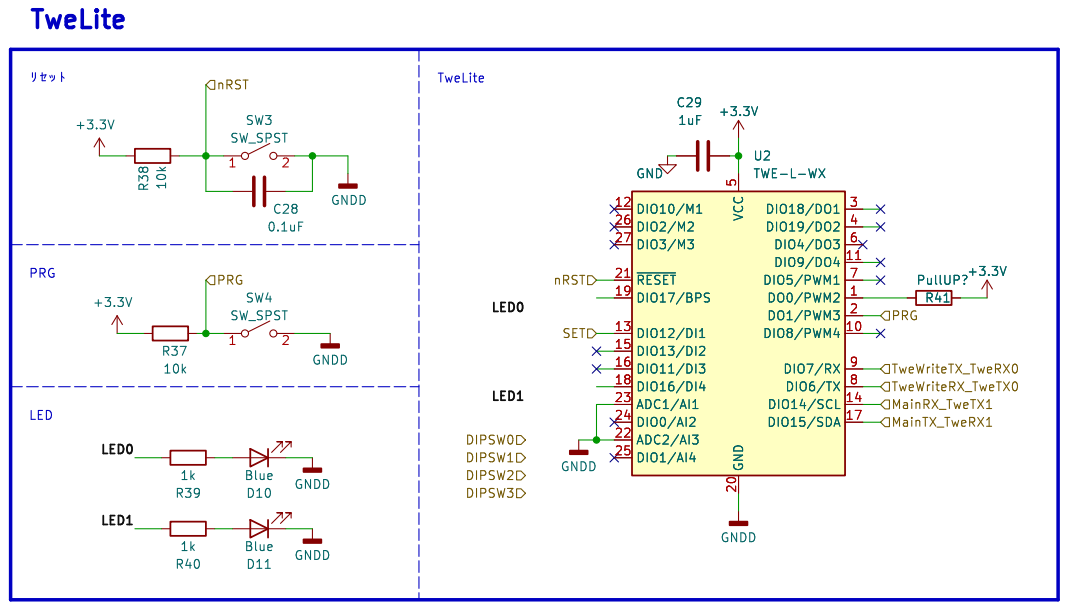
[picture p48: page 3]

5 DIO4/DO3 6 DIO5/PWM1 7 DIO6/TX 8 DIO7/RX 9 U2 TWE-L-WX R38 10k GNDD

Id: 3/5 Title: File: TweLite.kicad_sch Sheet: /TweLite/ R40

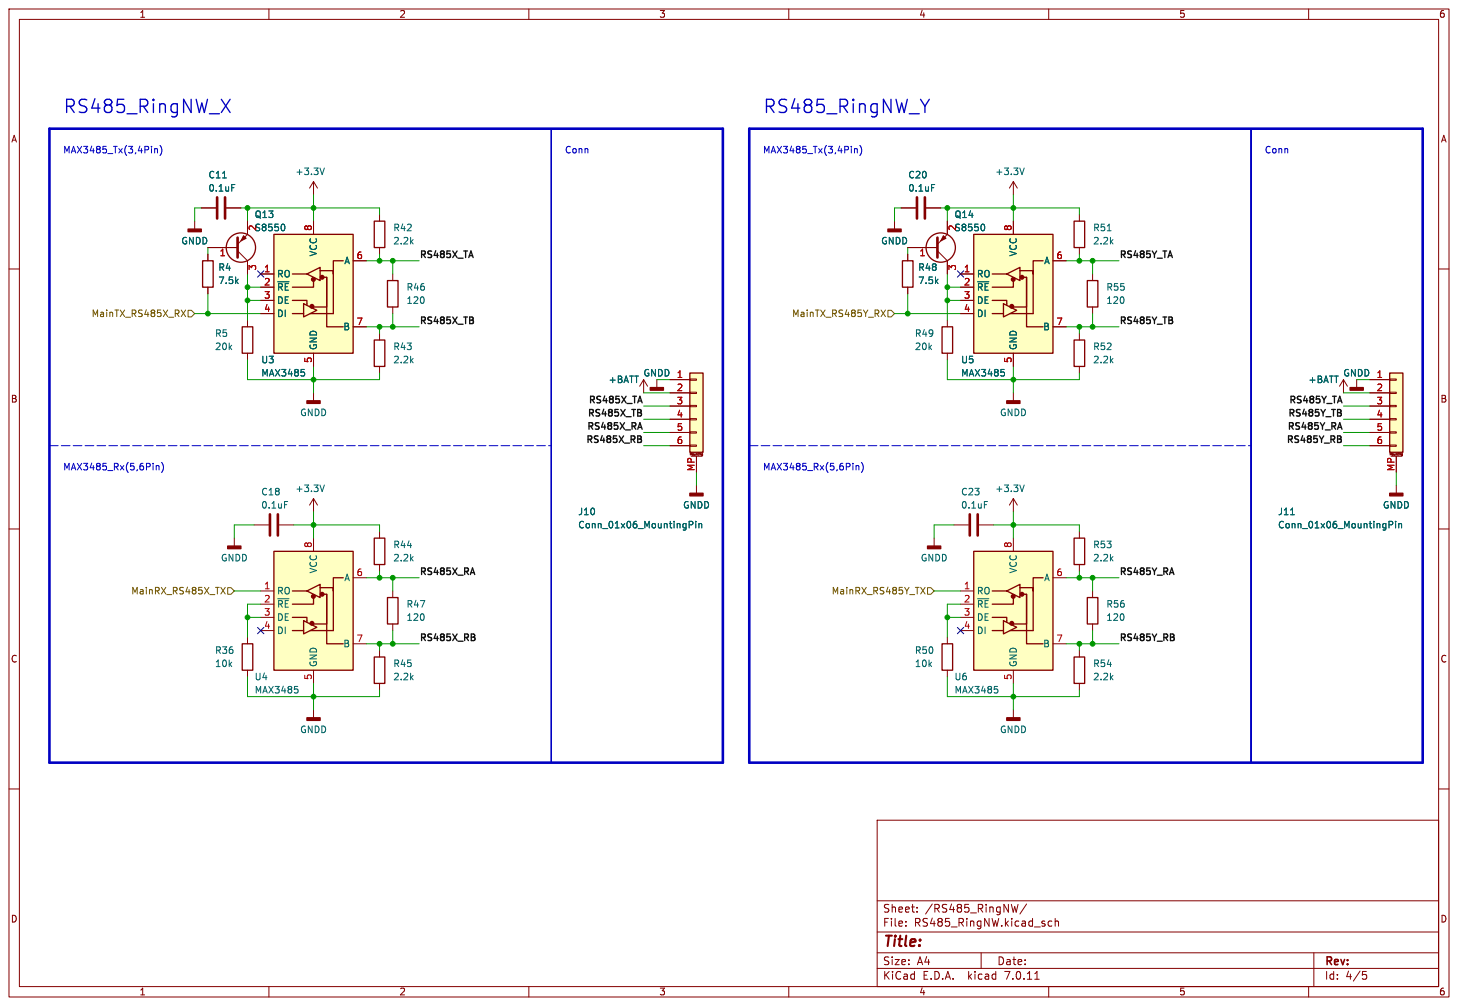
[picture p49: page 4]

2 3 U3 MAX3485 RO 1 ~{RE} 2 DE 3 DI 4 GND

Id: 4/5 Title: File: RS485_RingNW.kicad_sch Sheet: /RS485_RingNW/

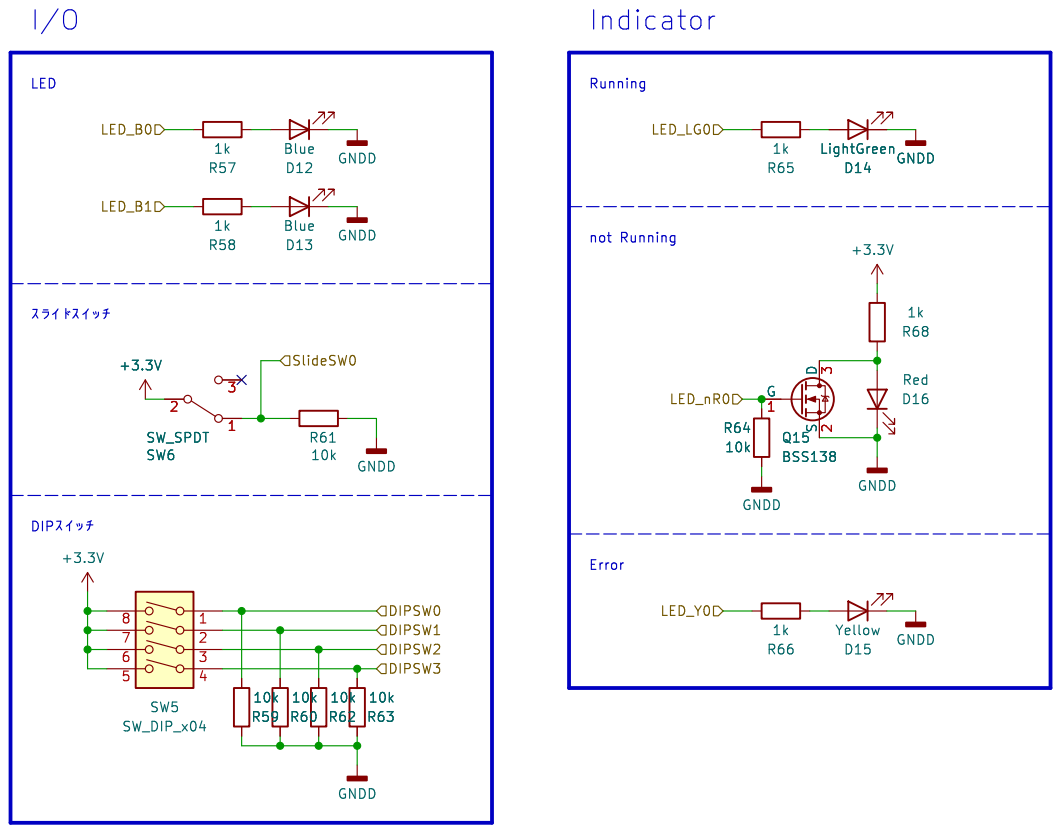
[picture p50: page 5]

Id: 5/5 Title: File: UI.kicad_sch Sheet: /UI/ R61
