Tomoshibi-technology/MovingDisplay3-Circuit/circuits/MD_module/MD/MD.kicad_pcb

## KiCad design circuits/MD_module/MD/MD.kicad_pcb (2025-09-16)

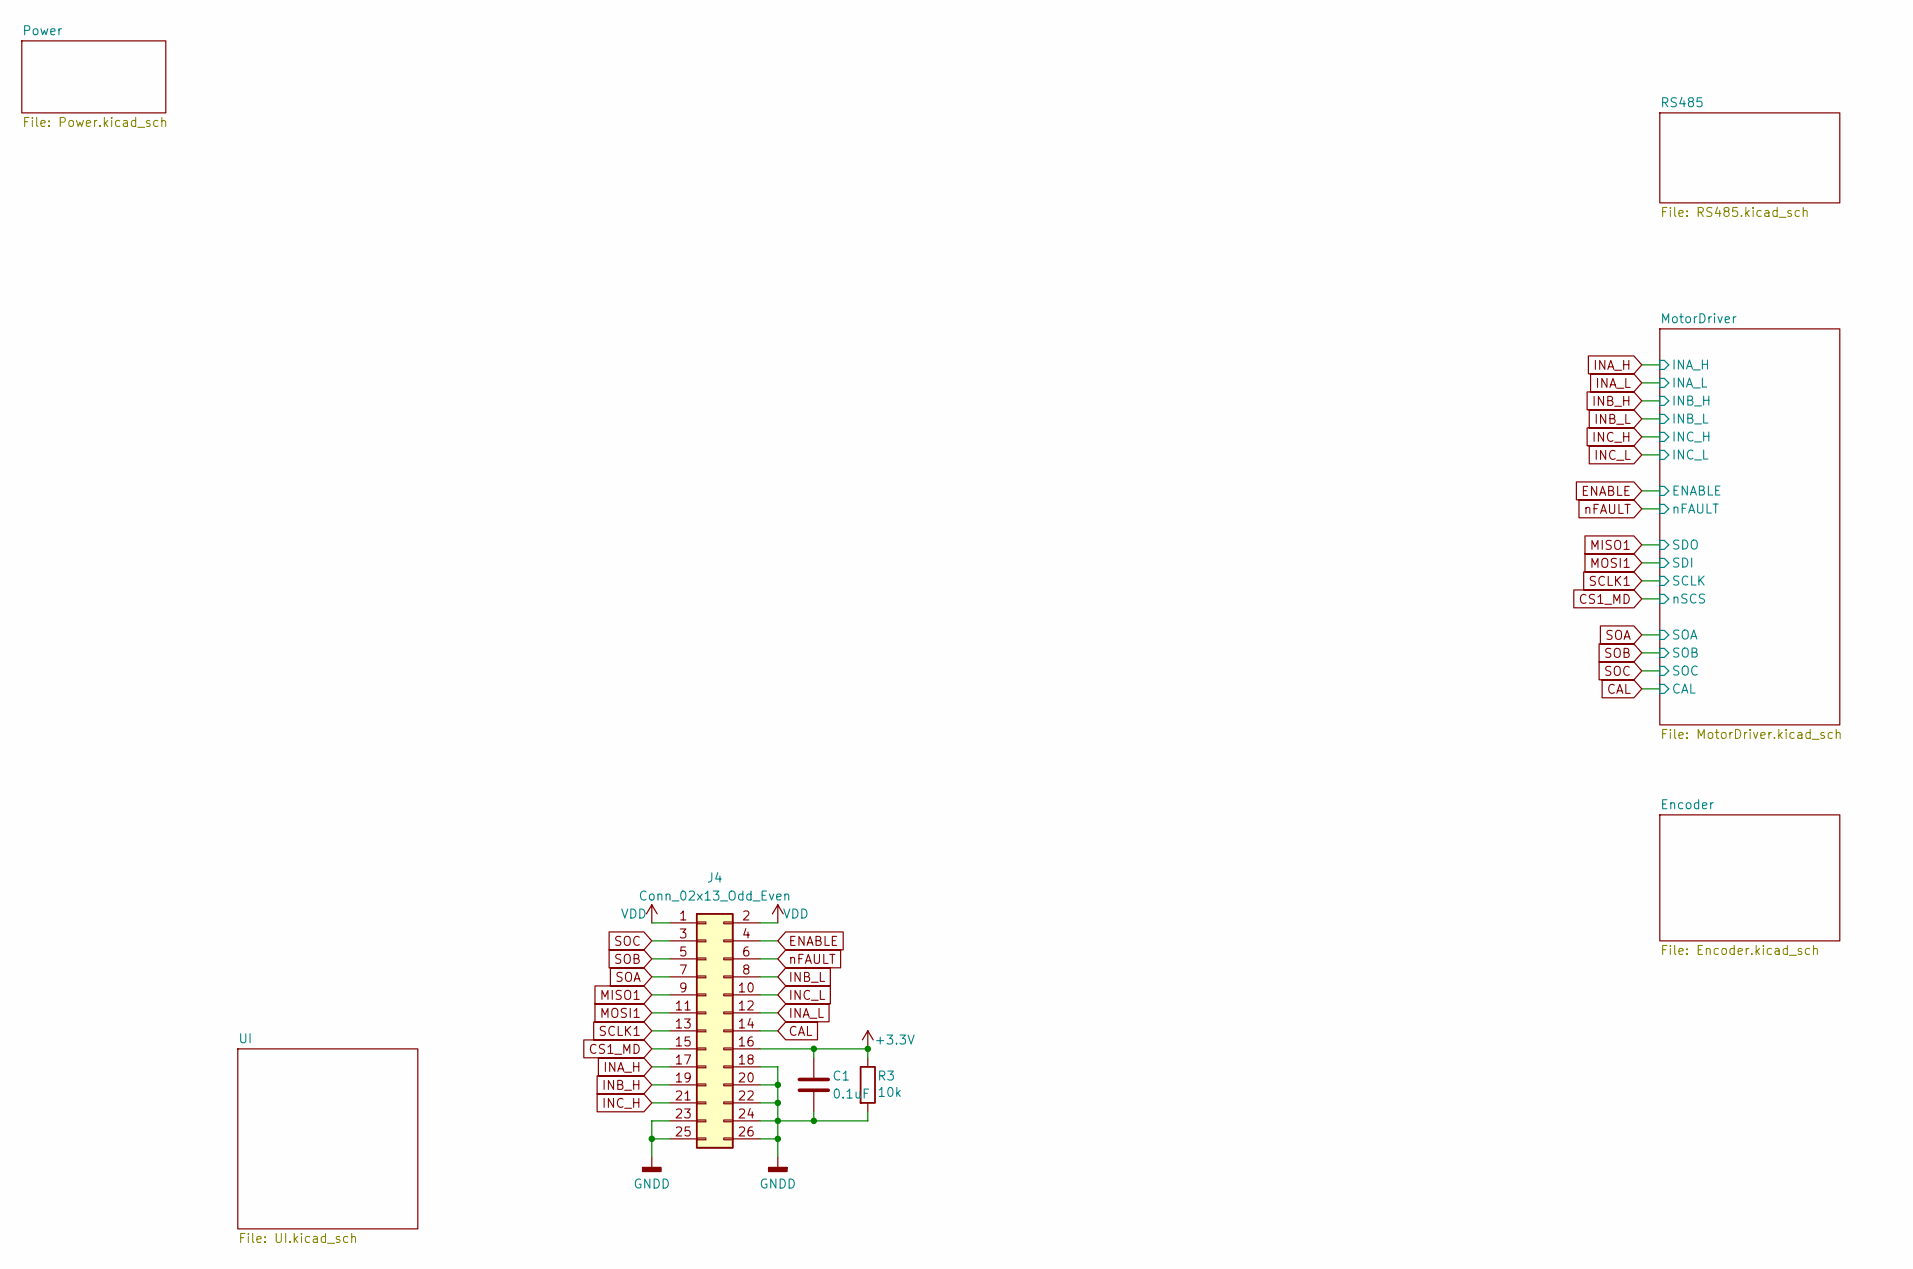
[picture p53: schematic MD.kicad_sch]

Parts:
C1: 0.1uF; C_0402_1005Metric
J4: Conn_02x13_Odd_Even; PinSocket_2x13_P1.27mm_Vertical
R3: 10k; R_0402_1005Metric

Connections:
+3.3V: C1.1, J4.16, R3.1; also elsewhere on the board
CAL: J4.14; also elsewhere on the board
CS1_MD: J4.15; also elsewhere on the board
ENABLE: J4.4; also elsewhere on the board
GND: C1.2, J4.18, J4.20, J4.22, J4.23, J4.24, J4.25, J4.26, R3.2; also elsewhere on the board
INA_H: J4.17; also elsewhere on the board
INA_L: J4.12; also elsewhere on the board
INB_H: J4.19; also elsewhere on the board
INB_L: J4.8; also elsewhere on the board
INC_H: J4.21; also elsewhere on the board
INC_L: J4.10; also elsewhere on the board
MISO1: J4.9; also elsewhere on the board
MOSI1: J4.11; also elsewhere on the board
SCLK1: J4.13; also elsewhere on the board
SOA: J4.7; also elsewhere on the board
SOB: J4.5; also elsewhere on the board
SOC: J4.3; also elsewhere on the board
VDD: J4.1, J4.2; also elsewhere on the board
nFAULT: J4.6; also elsewhere on the board

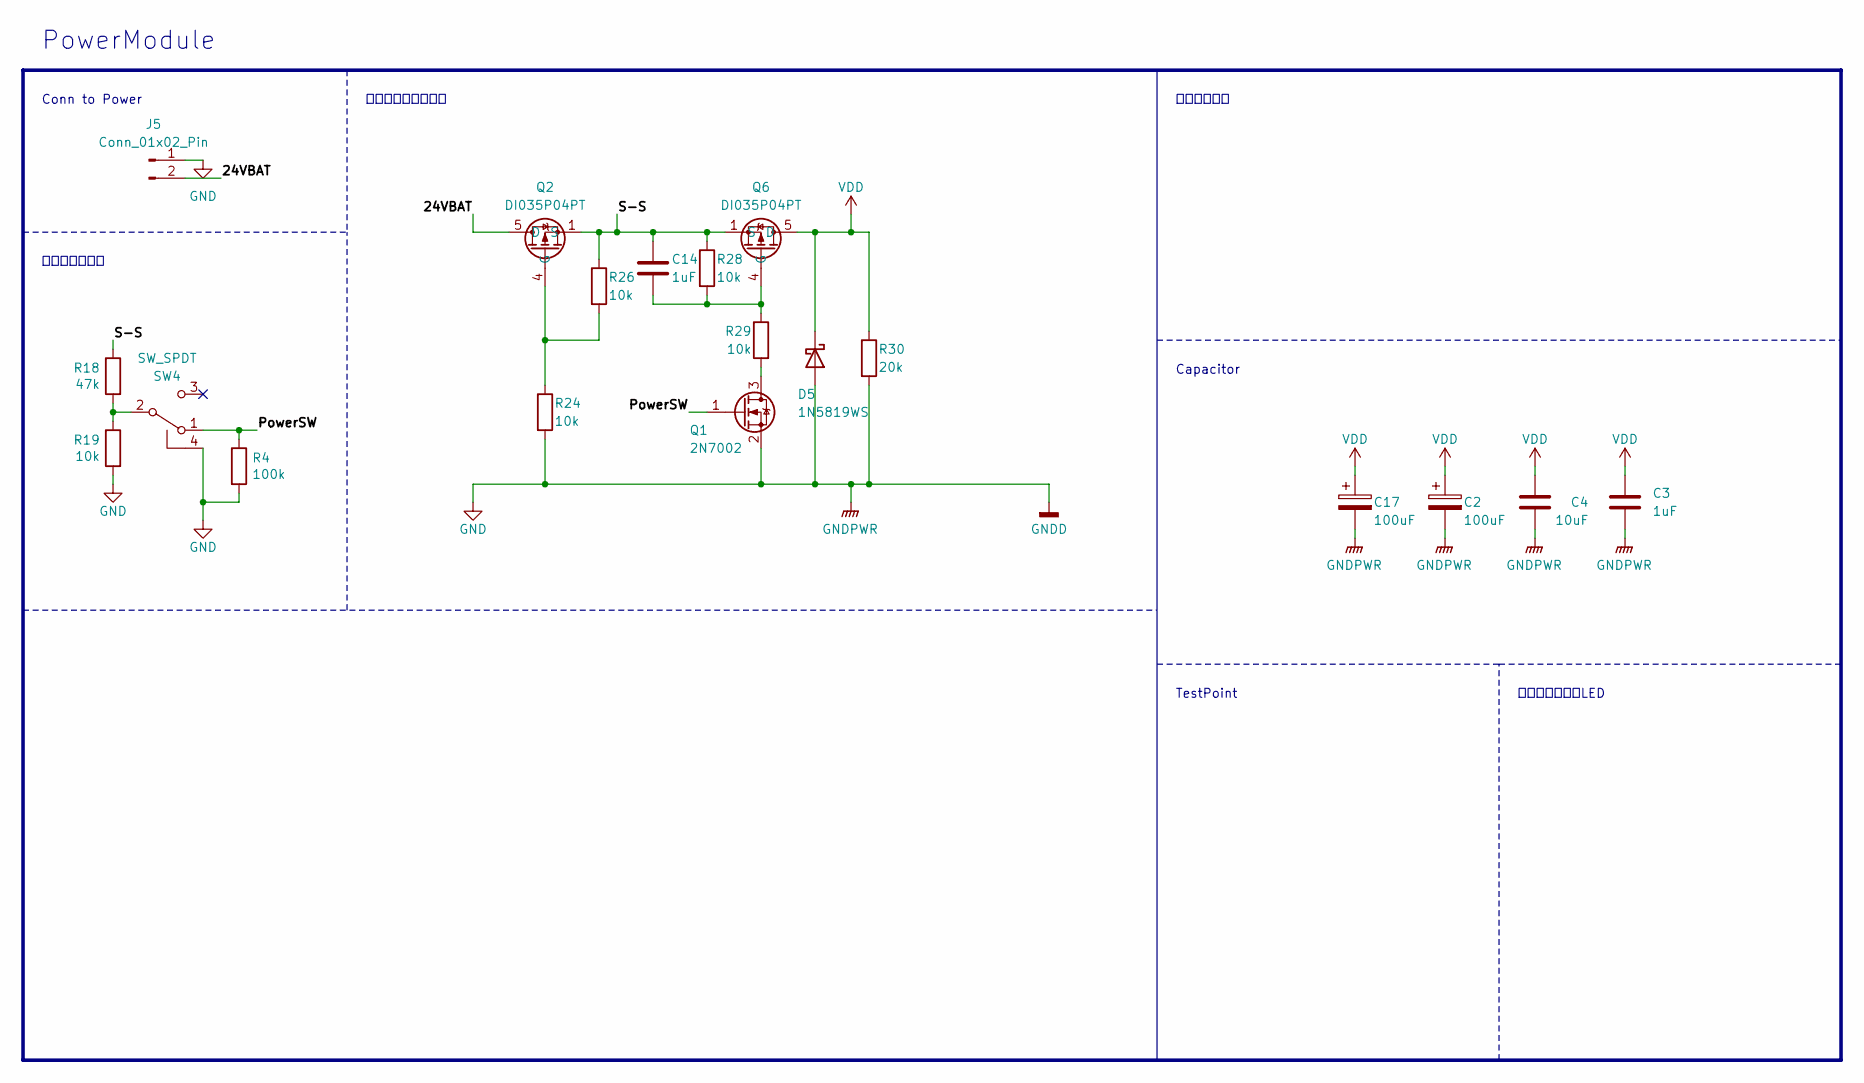
[picture p54: schematic Power.kicad_sch]

Parts:
C2, C17: 100uF; Capacitor_Alum_Radial_5.0x11.0mm_Horizontal
C3: 1uF; C_0603_1608Metric
C4: 10uF; C_1206_3216Metric
C14: 1uF; C_0402_1005Metric
D5: 1N5819WS; D_SOD-323_HandSoldering
J5: Conn_01x02_Pin; Molex_SPOX_5268-02A_1x02_P2.50mm_Horizontal
Q1: 2N7002; SOT-23
Q2, Q6: DI035P04PT; Package_TSON-Advance
R4: 100k; R_0402_1005Metric
R18: 47k; R_0402_1005Metric
R19, R24, R26, R28, R29: 10k; R_0402_1005Metric
R30: 20k; R_0402_1005Metric
SW4: SW_SPDT; SW_Slide_DPDT_SSSS820101

Connections:
/Power/24VBAT: J5.2, Q2.5 (D)
/Power/PowerSW: Q1.1 (G), R4.1, SW4.1 (A)
/Power/S-S: C14.1, Q2.1 (S), Q2.2 (S), Q2.3 (S), Q6.1 (S), Q6.2 (S), Q6.3 (S), R18.1, R26.1, R28.1
GND: C2.2, C3.2, C4.2, C17.2, D5.2 (A), J5.1, Q1.2 (S), R4.2, R19.2, R24.2, R30.2, SW4.4 (shell), SW4.5 (shell), SW4.6 (shell), SW4.G1 (shell), SW4.G2 (shell), SW4.G3 (shell), SW4.G4 (shell); also elsewhere on the board
unnamed: Q1.3 (D), R29.2
unnamed: Q2.4 (G), R24.1, R26.2
unnamed: C14.2, Q6.4 (G), R28.2, R29.1
unnamed: R18.2, R19.1, SW4.2 (B)
VDD: C2.1, C3.1, C4.1, C17.1, D5.1 (K), Q6.5 (D), R30.1; also elsewhere on the board

Notes on the sheet:
主電源スイッチ
電源電圧測定
インジケーターLED
保護回路・スイッチ
Conn to Power
PowerModule
Capacitor
TestPoint

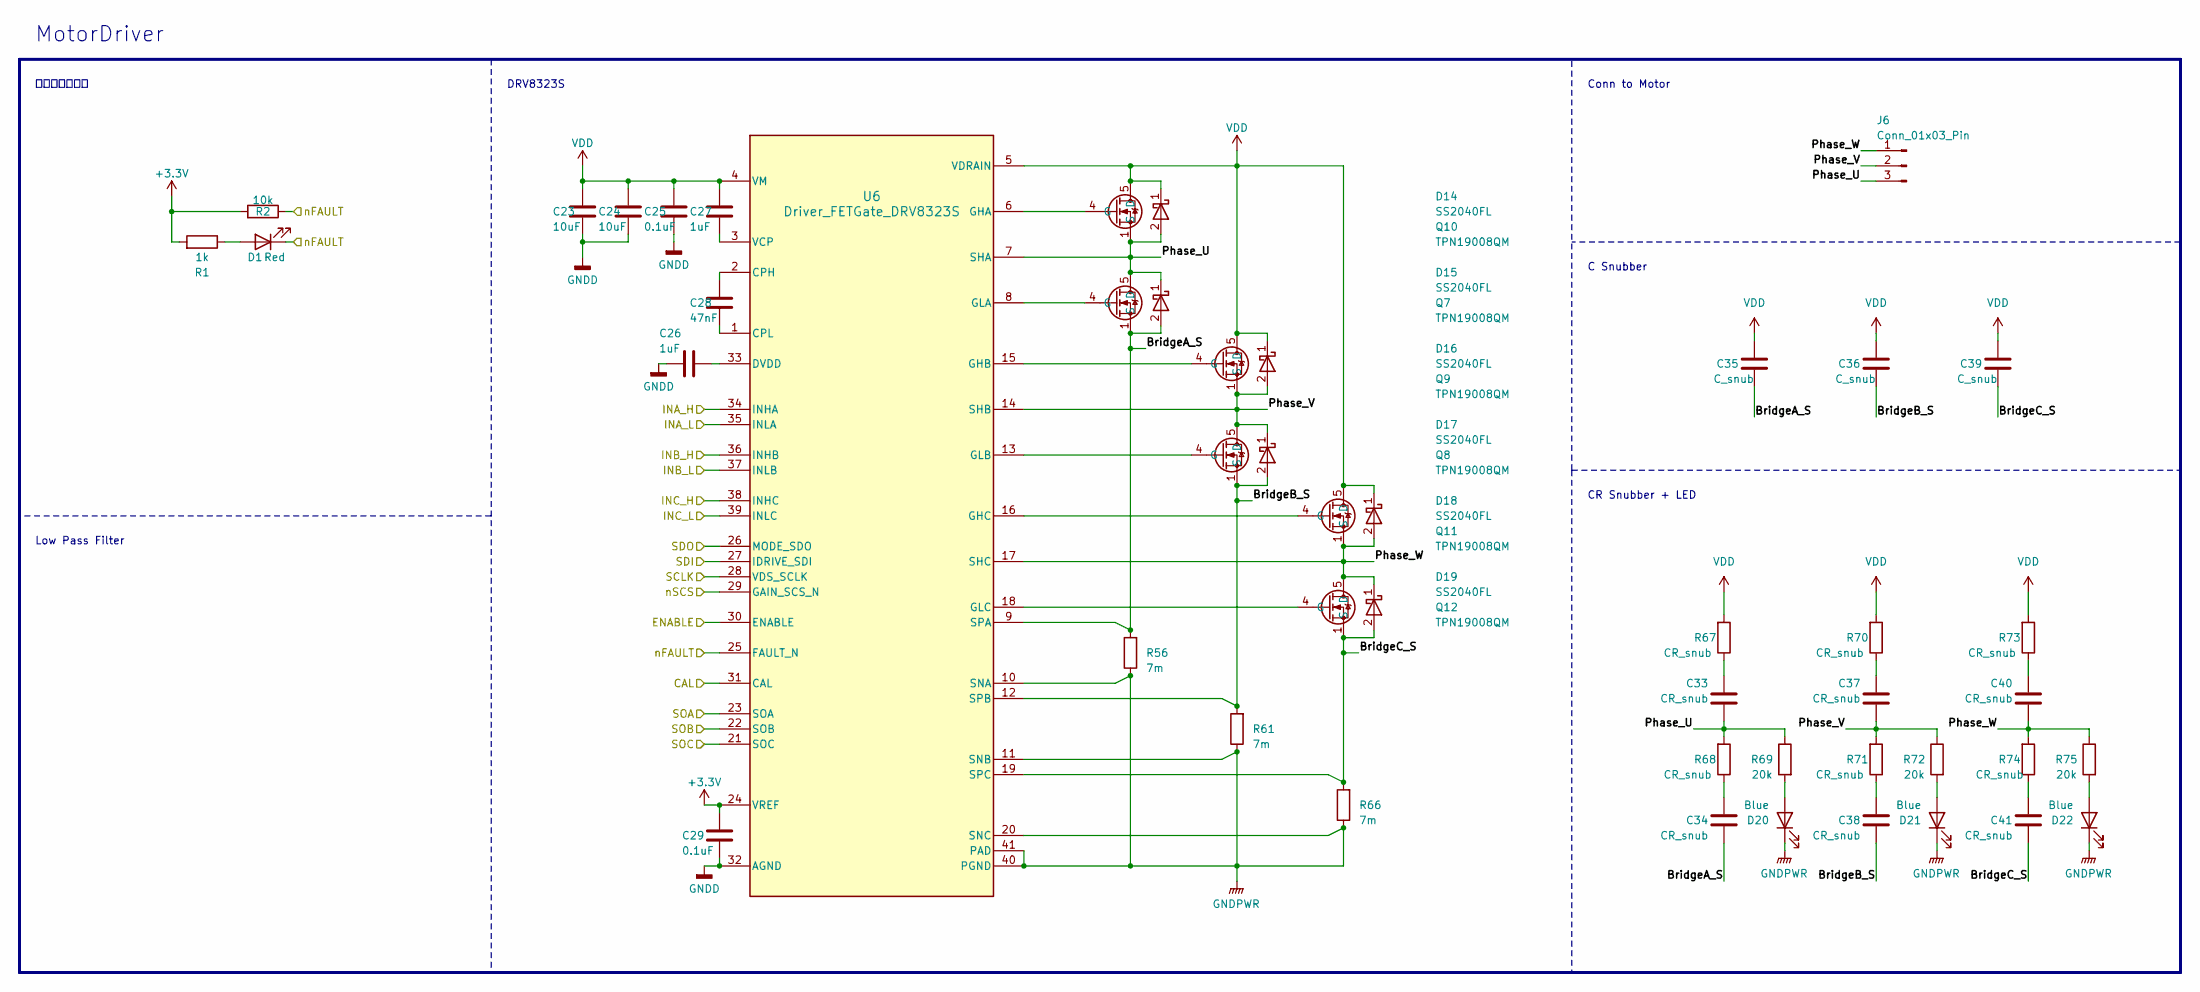
[picture p55: schematic MotorDriver.kicad_sch]

Parts:
C23, C24: 10uF; C_1206_3216Metric
C25, C29: 0.1uF; C_0402_1005Metric
C26, C27: 1uF; C_0402_1005Metric
C28: 47nF; C_0603_1608Metric
C33, C34, C37, C38, C40, C41: CR_snub; C_0603_1608Metric
C35, C36, C39: C_snub; C_0603_1608Metric
D1: Red; LED_0603_1608Metric_Pad1.05x0.95mm_HandSolder
D14, D15, D16, D17, D18, D19: SS2040FL; D_SOD-123
D20, D21, D22: Blue; LED_0603_1608Metric_Pad1.05x0.95mm_HandSolder
J6: Conn_01x03_Pin; Molex_SPOX_5268-03A_1x03_P2.50mm_Horizontal
Q7, Q8, Q9, Q10, Q11, Q12: TPN19008QM; Package_TSON-Advance
R1: 1k; R_0402_1005Metric
R2: 10k; R_0402_1005Metric
R56, R61, R66: 7m; R_2512_6332Metric
R67, R68, R70, R71, R73, R74: CR_snub; R_0603_1608Metric
R69, R72, R75: 20k; R_0402_1005Metric
U6: Driver_FETGate_DRV8323S

Connections:
+3.3V: C29.1, R1.2, R2.2, U6.24 (VREF); also elsewhere on the board
/MotorDriver/BridgeA_S: C34.1, C35.1, D15.2 (A), Q7.1 (S), Q7.2 (S), Q7.3 (S), R56.2, U6.9 (SPA)
/MotorDriver/BridgeB_S: C36.1, C38.1, D17.2 (A), Q8.1 (S), Q8.2 (S), Q8.3 (S), R61.2, U6.12 (SPB)
/MotorDriver/BridgeC_S: C39.1, C41.1, D19.2 (A), Q12.1 (S), Q12.2 (S), Q12.3 (S), R66.2, U6.19 (SPC)
/MotorDriver/Phase_U: C33.1, D14.2 (A), D15.1 (K), J6.3, Q7.5 (D), Q10.1 (S), Q10.2 (S), Q10.3 (S), R68.2, R69.1, U6.7 (SHA)
/MotorDriver/Phase_V: C37.1, D16.2 (A), D17.1 (K), J6.2, Q8.5 (D), Q9.1 (S), Q9.2 (S), Q9.3 (S), R71.2, R72.1, U6.14 (SHB)
/MotorDriver/Phase_W: C40.1, D18.2 (A), D19.1 (K), J6.1, Q11.1 (S), Q11.2 (S), Q11.3 (S), Q12.5 (D), R74.2, R75.1, U6.17 (SHC)
CAL: U6.31 (CAL); also elsewhere on the board
CS1_MD: U6.29 (GAIN_SCS_N); also elsewhere on the board
ENABLE: U6.30 (ENABLE); also elsewhere on the board
GND: C23.2, C24.2, C25.2, C26.2, C29.2, D20.1 (K), D21.1 (K), D22.1 (K), R56.1, R61.1, R66.1, U6.10 (SNA), U6.11 (SNB), U6.20 (SNC), U6.32 (AGND), U6.40 (PGND), U6.41 (PAD); also elsewhere on the board
INA_H: U6.34 (INHA); also elsewhere on the board
INA_L: U6.35 (INLA); also elsewhere on the board
INB_H: U6.36 (INHB); also elsewhere on the board
INB_L: U6.37 (INLB); also elsewhere on the board
INC_H: U6.38 (INHC); also elsewhere on the board
INC_L: U6.39 (INLC); also elsewhere on the board
MISO1: U6.26 (MODE_SDO); also elsewhere on the board
MOSI1: U6.27 (IDRIVE_SDI); also elsewhere on the board
unnamed: C33.2, R67.1
unnamed: C34.2, R68.1
unnamed: C37.2, R70.1
unnamed: C38.2, R71.1
unnamed: C40.2, R73.1
unnamed: C41.2, R74.1
unnamed: D1.2 (A), R1.1
unnamed: D20.2 (A), R69.2
unnamed: D21.2 (A), R72.2
unnamed: D22.2 (A), R75.2
unnamed: Q7.4 (G), U6.8 (GLA)
unnamed: Q8.4 (G), U6.13 (GLB)
unnamed: Q9.4 (G), U6.15 (GHB)
unnamed: Q10.4 (G), U6.6 (GHA)
unnamed: Q11.4 (G), U6.16 (GHC)
unnamed: Q12.4 (G), U6.18 (GLC)
unnamed: C28.1, U6.2 (CPH)
unnamed: C28.2, U6.1 (CPL)
unnamed: C26.1, U6.33 (DVDD)
unnamed: C27.2, U6.3 (VCP)
SCLK1: U6.28 (VDS_SCLK); also elsewhere on the board
SOA: U6.23 (SOA); also elsewhere on the board
SOB: U6.22 (SOB); also elsewhere on the board
SOC: U6.21 (SOC); also elsewhere on the board
VDD: C23.1, C24.1, C25.1, C27.1, C35.2, C36.2, C39.2, D14.1 (K), D16.1 (K), D18.1 (K), Q9.5 (D), Q10.5 (D), Q11.5 (D), R67.2, R70.2, R73.2, U6.4 (VM), U6.5 (VDRAIN); also elsewhere on the board
nFAULT: D1.1 (K), R2.1, U6.25 (FAULT_N); also elsewhere on the board

Notes on the sheet:
CR Snubber + LED
プルアップなど
DRV8323S
MotorDriver
Conn to Motor
Low Pass Filter
C Snubber

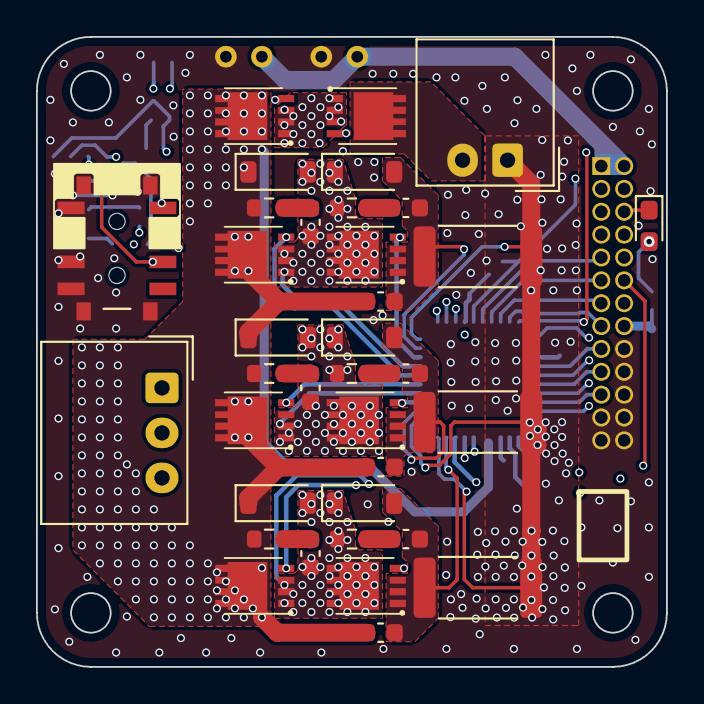
[picture p56: board MD.kicad_pcb from above]

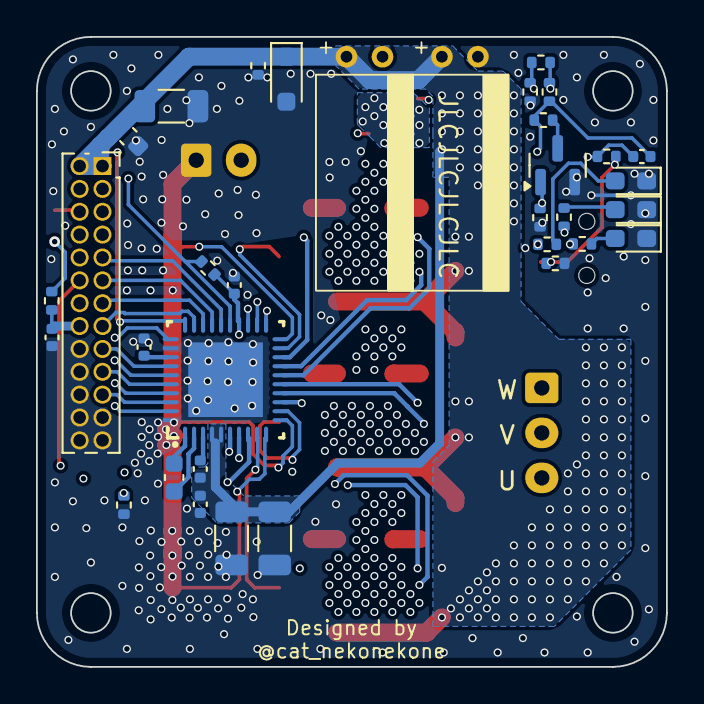
[picture p57: board MD.kicad_pcb from below]

Board: 4 copper layers, 35.0 x 35.0 mm, 70 parts (34 on the bottom side), 52 nets.
