Tomoshibi-technology/MovingDisplay3-Circuit/circuits/DCDC/DCDC.kicad_pcb

## KiCad design circuits/DCDC/DCDC.kicad_pcb (2025-09-16)

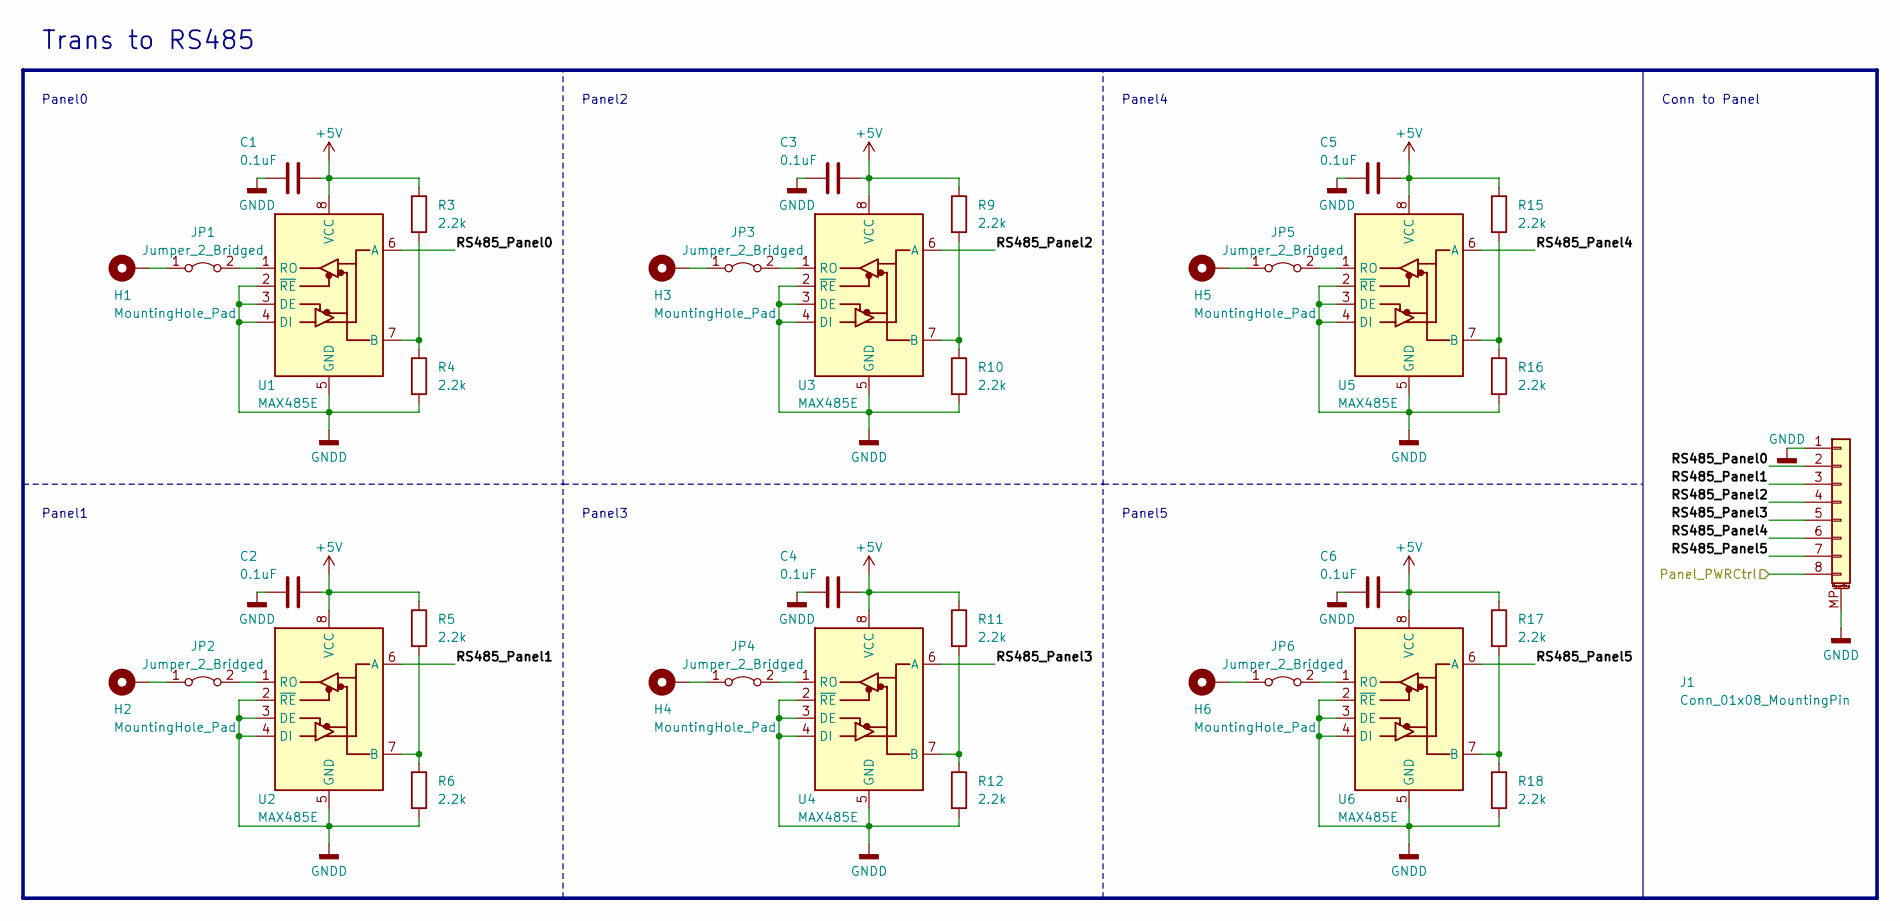
[picture p58: schematic RS485.kicad_sch]

Parts:
C1, C2, C3, C4, C5, C6: 0.1uF; C_0402_1005Metric
H1, H2, H3, H4, H5, H6: MountingHole_Pad; MountingHole_2.2mm_M2_Pad
J1: Conn_01x08_MountingPin; Molex_PicoBlade_53261-0871_1x08-1MP_P1.25mm_Horizontal
JP1, JP2, JP3, JP4, JP5, JP6: Jumper_2_Bridged; SolderJumper-2_P1.3mm_Bridged_RoundedPad1.0x1.5mm
R3, R4, R5, R6, R9, R10, R11, R12, R15, R16, R17, R18: 2.2k; R_0402_1005Metric
U1, U2, U3, U4, U5, U6: MAX485E; SOP-8_3.9x4.9mm_P1.27mm

Connections:
+5V: C1.1, C2.1, C3.1, C4.1, C5.1, C6.1, R3.1, R5.1, R9.1, R11.1, R15.1, R17.1, U1.8 (VCC), U2.8 (VCC), U3.8 (VCC), U4.8 (VCC), U5.8 (VCC), U6.8 (VCC); also elsewhere on the board
/Panel_PWRCtrl: J1.8; also elsewhere on the board
/RS485/RS485_Panel0: J1.2, U1.6 (A)
/RS485/RS485_Panel1: J1.3, U2.6 (A)
/RS485/RS485_Panel2: J1.4, U3.6 (A)
/RS485/RS485_Panel3: J1.5, U4.6 (A)
/RS485/RS485_Panel4: J1.6, U5.6 (A)
/RS485/RS485_Panel5: J1.7, U6.6 (A)
GND: C1.2, C2.2, C3.2, C4.2, C5.2, C6.2, J1.1, J1.MP (MountPin), R4.2, R6.2, R10.2, R12.2, R16.2, R18.2, U1.2 (~RE), U1.3 (DE), U1.4 (DI), U1.5 (GND), U2.2 (~RE), U2.3 (DE), U2.4 (DI), U2.5 (GND), U3.2 (~RE), U3.3 (DE), U3.4 (DI), U3.5 (GND), U4.2 (~RE), U4.3 (DE), U4.4 (DI), U4.5 (GND), U5.2 (~RE), U5.3 (DE), U5.4 (DI), U5.5 (GND), U6.2 (~RE), U6.3 (DE), U6.4 (DI), U6.5 (GND); also elsewhere on the board
unnamed: H1.1, JP1.1 (A)
unnamed: JP1.2 (B), U1.1 (RO)
unnamed: H2.1, JP2.1 (A)
unnamed: JP2.2 (B), U2.1 (RO)
unnamed: H3.1, JP3.1 (A)
unnamed: JP3.2 (B), U3.1 (RO)
unnamed: H4.1, JP4.1 (A)
unnamed: JP4.2 (B), U4.1 (RO)
unnamed: H5.1, JP5.1 (A)
unnamed: JP5.2 (B), U5.1 (RO)
unnamed: H6.1, JP6.1 (A)
unnamed: JP6.2 (B), U6.1 (RO)
unnamed: R3.2, R4.1, U1.7 (B)
unnamed: R5.2, R6.1, U2.7 (B)
unnamed: R9.2, R10.1, U3.7 (B)
unnamed: R11.2, R12.1, U4.7 (B)
unnamed: R15.2, R16.1, U5.7 (B)
unnamed: R17.2, R18.1, U6.7 (B)

Notes on the sheet:
Panel4
Panel1
Panel5
Panel3
Panel0
Panel2
Conn to Panel
Trans to RS485
