Tomoshibi-technology/MovingDisplay3-Circuit/circuits/DCDC/DCDC.kicad_pcb

## KiCad design circuits/DCDC/DCDC.kicad_pcb (continued)

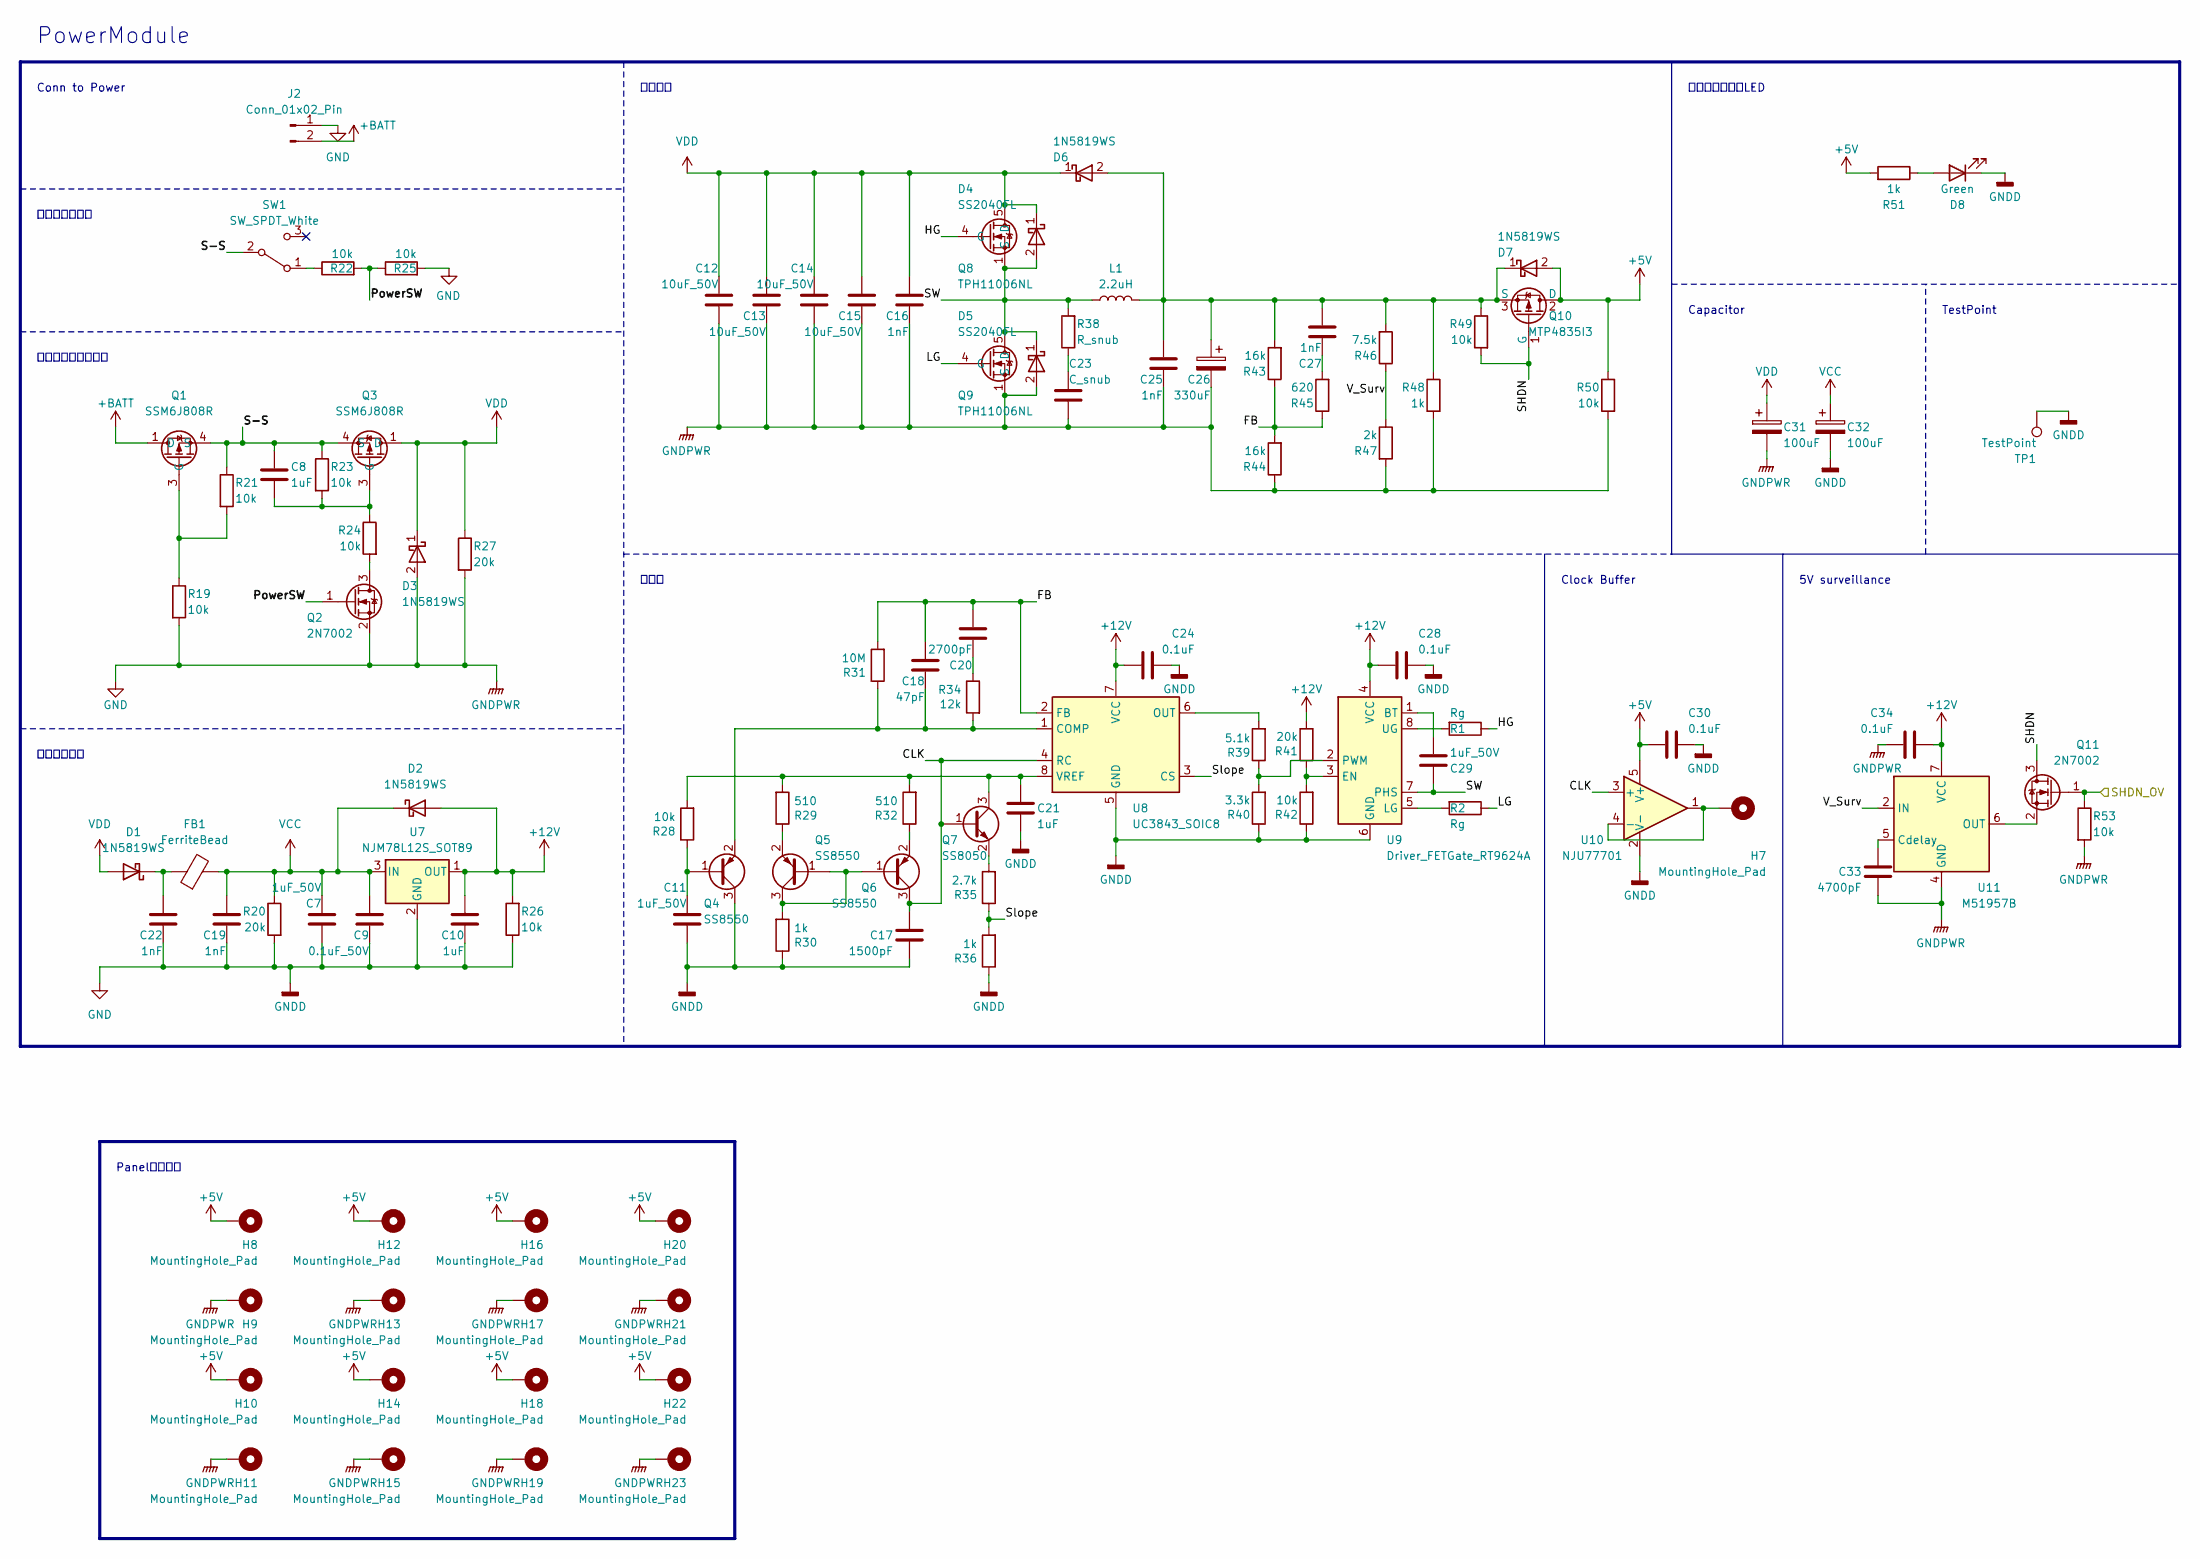
[picture p59: schematic Power.kicad_sch]

Parts:
C7, C11, C29: 1uF_50V; C_0603_1608Metric
C8, C10, C21: 1uF; C_0402_1005Metric
C9: 0.1uF_50V; C_0402_1005Metric
C12, C13, C14, C15: 10uF_50V; C_0805_2012Metric
C16, C19, C22, C25, C27: 1nF; C_0603_1608Metric
C17: 1500pF; C_0603_1608Metric
C18: 47pF; C_0603_1608Metric
C20: 2700pF; C_0603_1608Metric
C23: C_snub; C_0603_1608Metric
C24, C28, C30, C34: 0.1uF; C_0402_1005Metric
C26: 330uF; CP_EIA-7343-20_Kemet-V
C31, C32: 100uF; Capacitor_Alum_Radial_5.0x11.0mm_Horizontal
C33: 4700pF; C_0603_1608Metric
D1, D2, D3, D6, D7: 1N5819WS; Diode_SOD-323
D4, D5: SS2040FL; D_SOD-123
D8: Green; LED_0603_1608Metric_Pad1.05x0.95mm_HandSolder
FB1: FerriteBead; L_0603_1608Metric
H7: MountingHole_Pad; TestPoint_Pad_D1.5mm
H8, H9, H10, H11, H12, H13, H14, H15, H16, H17, H18, H19, H20, H21, H22, H23: MountingHole_Pad; MountingHole_3.7mm_Pad_Via
J2: Conn_01x02_Pin; Molex_SPOX_5268-02A_1x02_P2.50mm_Horizontal
L1: 2.2uH; Inductor_ETQ-P4M_KVK
Q1, Q3: SSM6J808R; Package_TSOP6F
Q2, Q11: 2N7002; SC-59
Q4, Q5, Q6: SS8550; SC-59
Q7: SS8050; SC-59
Q8, Q9: TPH11006NL; Package_SOP-Advance
Q10: MTP4835I3; TO-252-2
R1, R2: Rg; R_0603_1608Metric
R19, R21, R22, R23, R24, R25, R26, R28, R42, R49, R50, R53: 10k; R_0402_1005Metric
R20, R27, R41: 20k; R_0402_1005Metric
R29, R32: 510; R_0402_1005Metric
R30, R36, R48, R51: 1k; R_0402_1005Metric
R31: 10M; R_0603_1608Metric
R34: 12k; R_0603_1608Metric
R35: 2.7k; R_0603_1608Metric
R38: R_snub; R_0603_1608Metric
R39: 5.1k; R_0402_1005Metric
R40: 3.3k; R_0402_1005Metric
R43, R44: 16k; R_0603_1608Metric
R45: 620; R_0603_1608Metric
R46: 7.5k; R_0603_1608Metric
R47: 2k; R_0603_1608Metric
SW1: SW_SPDT_White; SW_Slide_SPDT_IS-1235-G
TP1: TestPoint; TestPoint_THTPad_D2.0mm_Drill1.0mm
U7: NJM78L12S_SOT89; SOT-89-3
U8: UC3843_SOIC8; SOIC-8_3.9x4.9mm_P1.27mm
U9: Driver_FETGate_RT9624A; SOP-8_3.9x4.9mm_P1.27mm
U10: NJU77701; SOT-23-5
U11: M51957B; SOP-8_3.9x4.9mm_P1.27mm

Connections:
+5V: C30.2, D7.2 (A), H8.1, H10.1, H12.1, H14.1, H16.1, H18.1, H20.1, H22.1, Q10.2 (D), R50.1, R51.2, U10.5 (V+); also elsewhere on the board
+12V: C10.1, C24.1, C28.2, C34.2, D2.2 (A), R26.2, R41.2, U7.1 (OUT), U8.7 (VCC), U9.4 (VCC), U11.7 (VCC)
+BATT: J2.2, Q1.1 (D), Q1.2 (D), Q1.5 (D), Q1.6 (D)
/Panel_PWRCtrl: Q11.1 (G), R53.1; also elsewhere on the board
/Power/CLK: C17.1, Q6.3 (C), Q7.1 (B), U8.4 (RC), U10.3 (+)
/Power/FB: C18.1, C20.2, R31.2, R43.1, R44.2, R45.1, U8.2 (FB)
/Power/HG: Q8.4 (G), R1.1
/Power/LG: Q9.4 (G), R2.1
/Power/PowerSW: Q2.1 (G), R22.2, R25.1
/Power/S-S: C8.1, Q1.4 (S), Q3.4 (S), R21.1, R23.1, SW1.2 (B)
/Power/SHDN: Q10.1 (G), Q11.3 (D), R49.2
/Power/SW: C29.2, D4.2 (A), D5.1 (K), L1.1, Q8.1 (S), Q8.2 (S), Q8.3 (S), Q9.5 (D), R38.2, U9.7 (PHS)
/Power/Slope: R35.1, R36.2, U8.3 (CS)
/Power/V_Surv: R46.1, R47.1, U11.2 (IN)
GND: C7.2, C9.1, C10.2, C11.2, C12.2, C13.2, C14.2, C15.2, C16.2, C17.2, C19.2, C21.2, C22.2, C23.1, C24.2, C25.2, C26.2, C28.1, C30.1, C31.2, C32.2, C33.1, C34.1, D3.2 (A), D5.2 (A), D8.1 (K), H9.1, H11.1, H13.1, H15.1, H17.1, H19.1, H21.1, H23.1, J2.1, Q2.2 (S), Q4.3 (C), Q9.1 (S), Q9.2 (S), Q9.3 (S), R19.2, R20.2, R25.2, R26.1, R27.2, R30.1, R36.1, R40.1, R42.1, R44.1, R47.2, R48.2, R50.2, R53.2, TP1.1, U7.2 (GND), U8.5 (GND), U9.6 (GND), U10.2 (V-), U11.4 (GND); also elsewhere on the board
unnamed: C20.1, R34.1
unnamed: C23.2, R38.1
unnamed: C27.1, R45.2
unnamed: C22.1, D1.1 (K), FB1.1
unnamed: C25.1, C26.1, C27.2, D6.2 (A), D7.1 (K), L1.2, Q10.3 (S), R43.2, R46.2, R48.1, R49.1
unnamed: D8.2 (A), R51.1
unnamed: Q1.3 (G), R19.1, R21.2
unnamed: Q2.3 (D), R24.2
unnamed: C8.2, Q3.3 (G), R23.2, R24.1
unnamed: C11.1, Q4.1 (B), R28.1
unnamed: C18.2, Q4.2 (E), R31.1, R34.2, U8.1 (COMP)
unnamed: Q5.1 (B), Q5.3 (C), Q6.1 (B), R30.2
unnamed: Q5.2 (E), R29.1
unnamed: Q6.2 (E), R32.1
unnamed: C21.1, Q7.3 (C), R28.2, R29.2, R32.2, U8.8 (VREF)
unnamed: Q7.2 (E), R35.2
unnamed: Q11.2 (S), U11.6 (OUT)
unnamed: R22.1, SW1.1 (A)
unnamed: R39.2, U8.6 (OUT)
unnamed: C29.1, U9.1 (BT)
unnamed: R41.1, R42.2, U9.3 (EN)
unnamed: R2.2, U9.5 (LG)
unnamed: R39.1, R40.2, U9.2 (PWM)
unnamed: R1.2, U9.8 (UG)
unnamed: H7.1, U10.1, U10.4 (-)
unnamed: C33.2, U11.5 (Cdelay)
VCC: C7.1, C9.2, C19.1, C32.1, D2.1 (K), FB1.2, R20.1, U7.3 (IN)
VDD: C12.1, C13.1, C14.1, C15.1, C16.1, C31.1, D1.2 (A), D3.1 (K), D4.1 (K), D6.1 (K), Q3.1 (D), Q3.2 (D), Q3.5 (D), Q3.6 (D), Q8.5 (D), R27.1

Notes on the sheet:
Capacitor
TestPoint
補機電源生成
保護回路・スイッチ
パワー段
PowerModule
5V surveillance
主電源スイッチ
インジケーターLED
Clock Buffer
Conn to Power
制御段
Panelとの接続

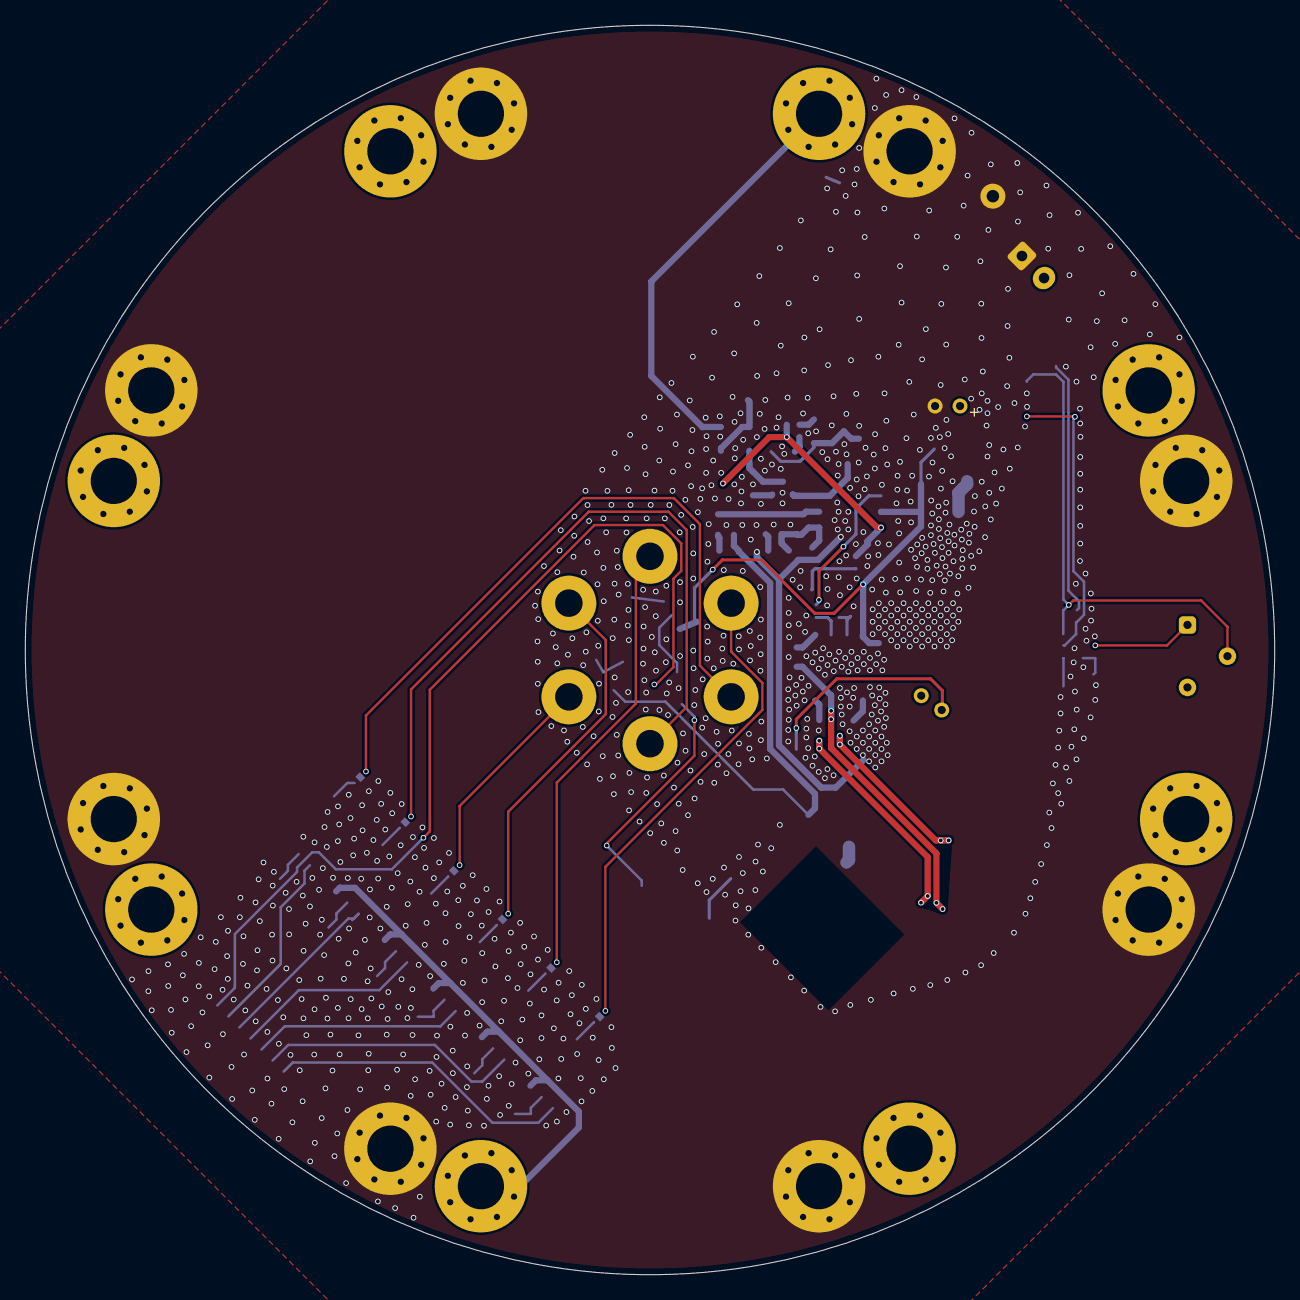
[picture p60: board DCDC.kicad_pcb from above]

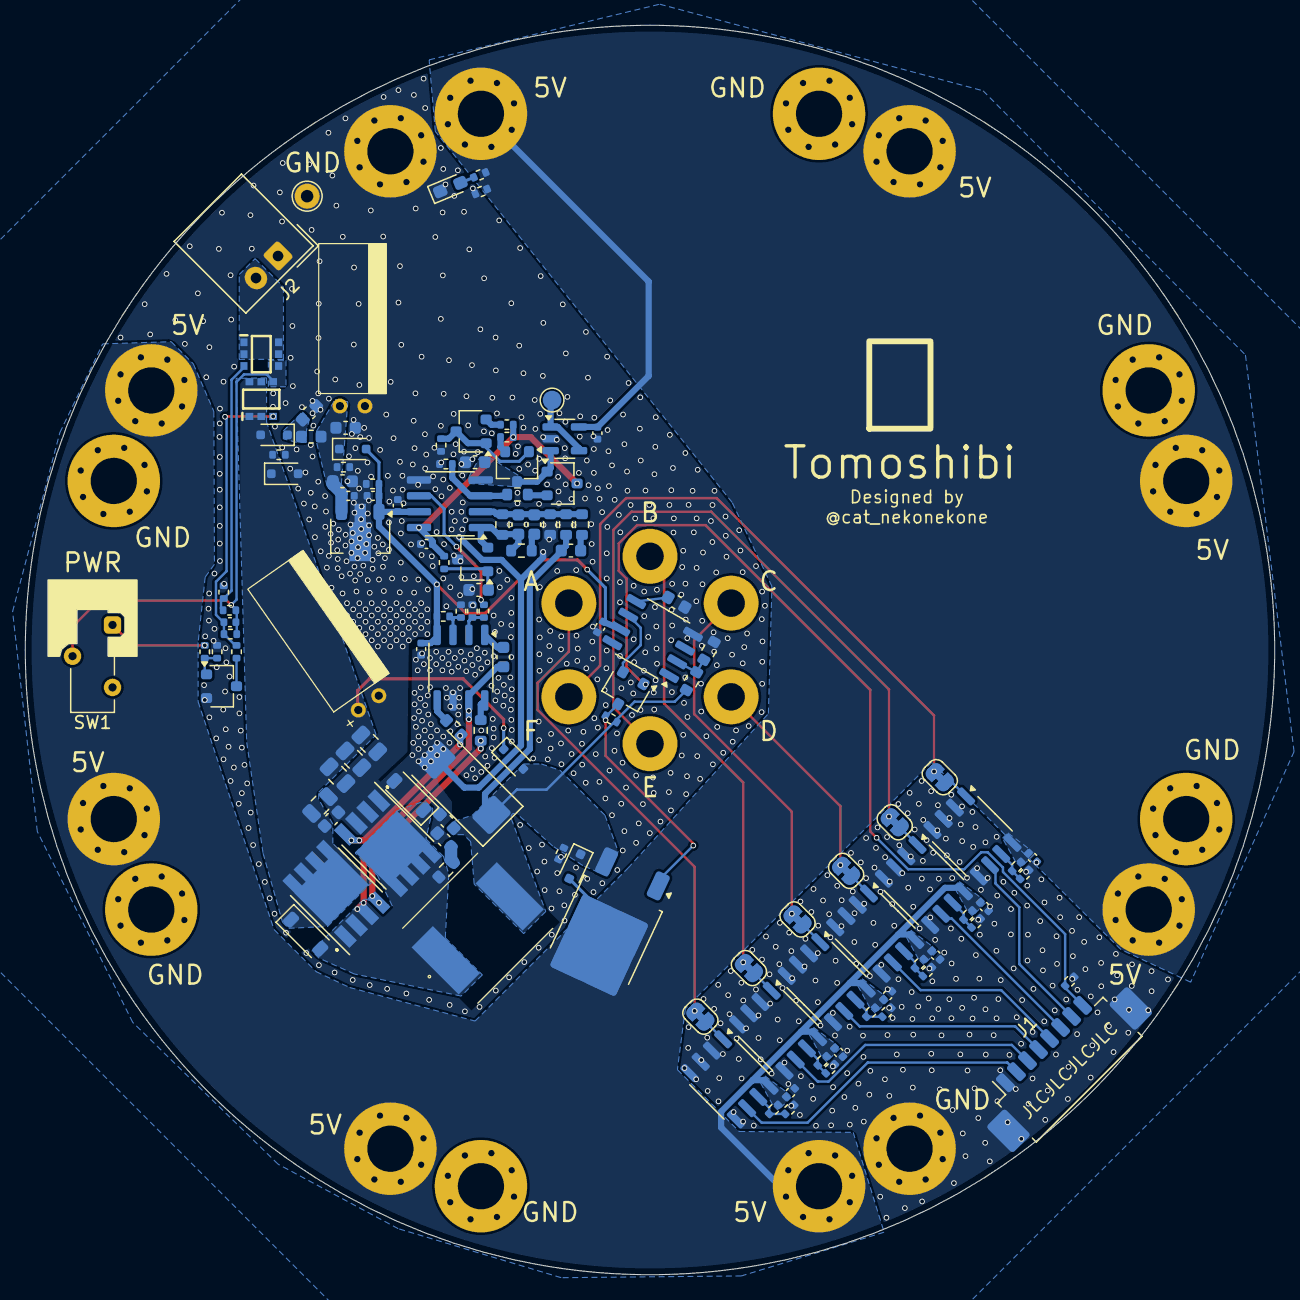
[picture p61: board DCDC.kicad_pcb from below]

Board: 2 copper layers, 100.0 x 100.0 mm, 145 parts (145 on the bottom side), 67 nets.
