Tomoshibi-technology/MovingDisplay3-Circuit/circuits/Imposition/1stLayer_Power/1stLayer_Power.kicad_pcb

## KiCad design circuits/Imposition/1stLayer_Power/1stLayer_Power.kicad_pcb (2025-06-24)

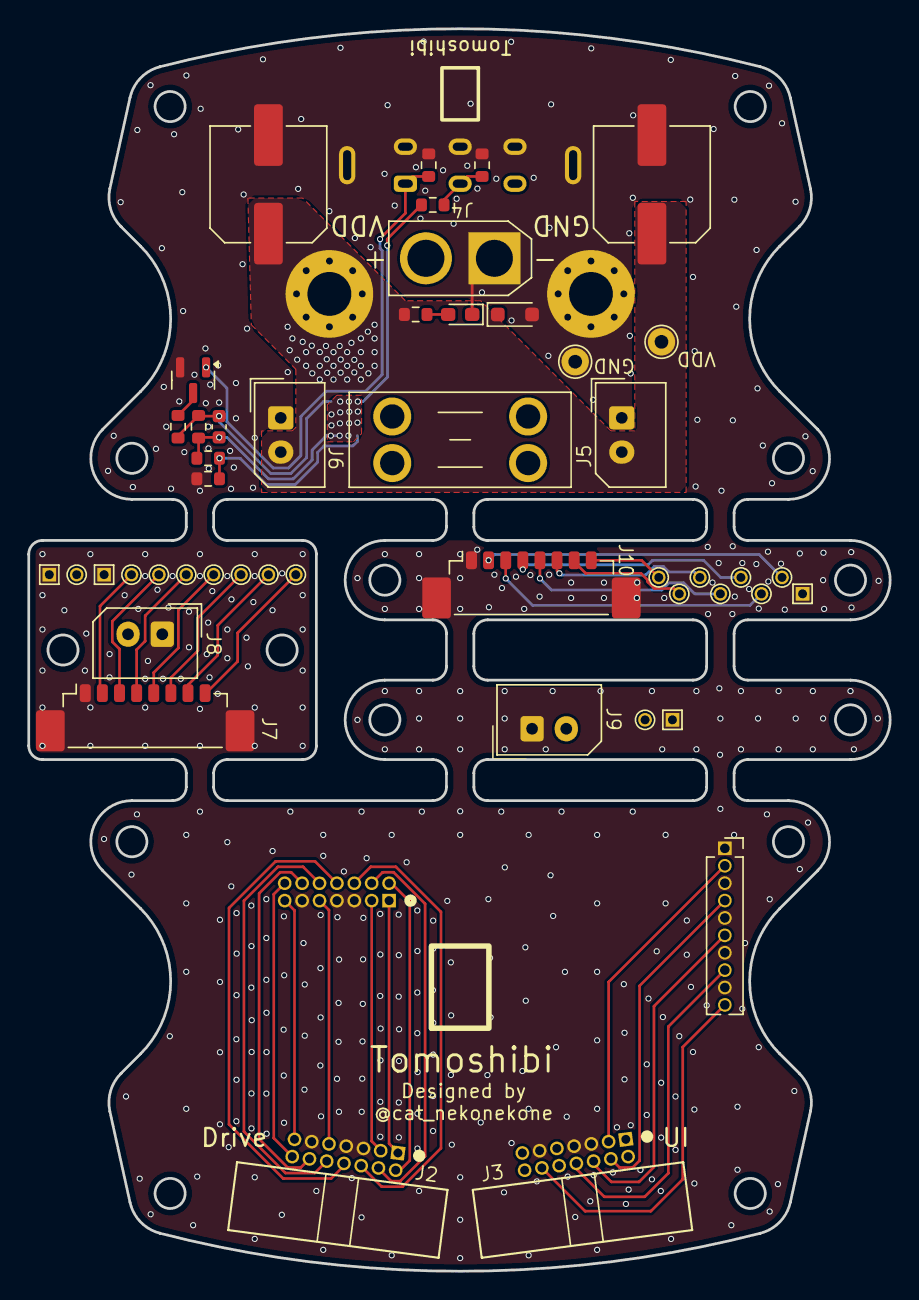
[picture p62: board 1stLayer_Power.kicad_pcb from above]

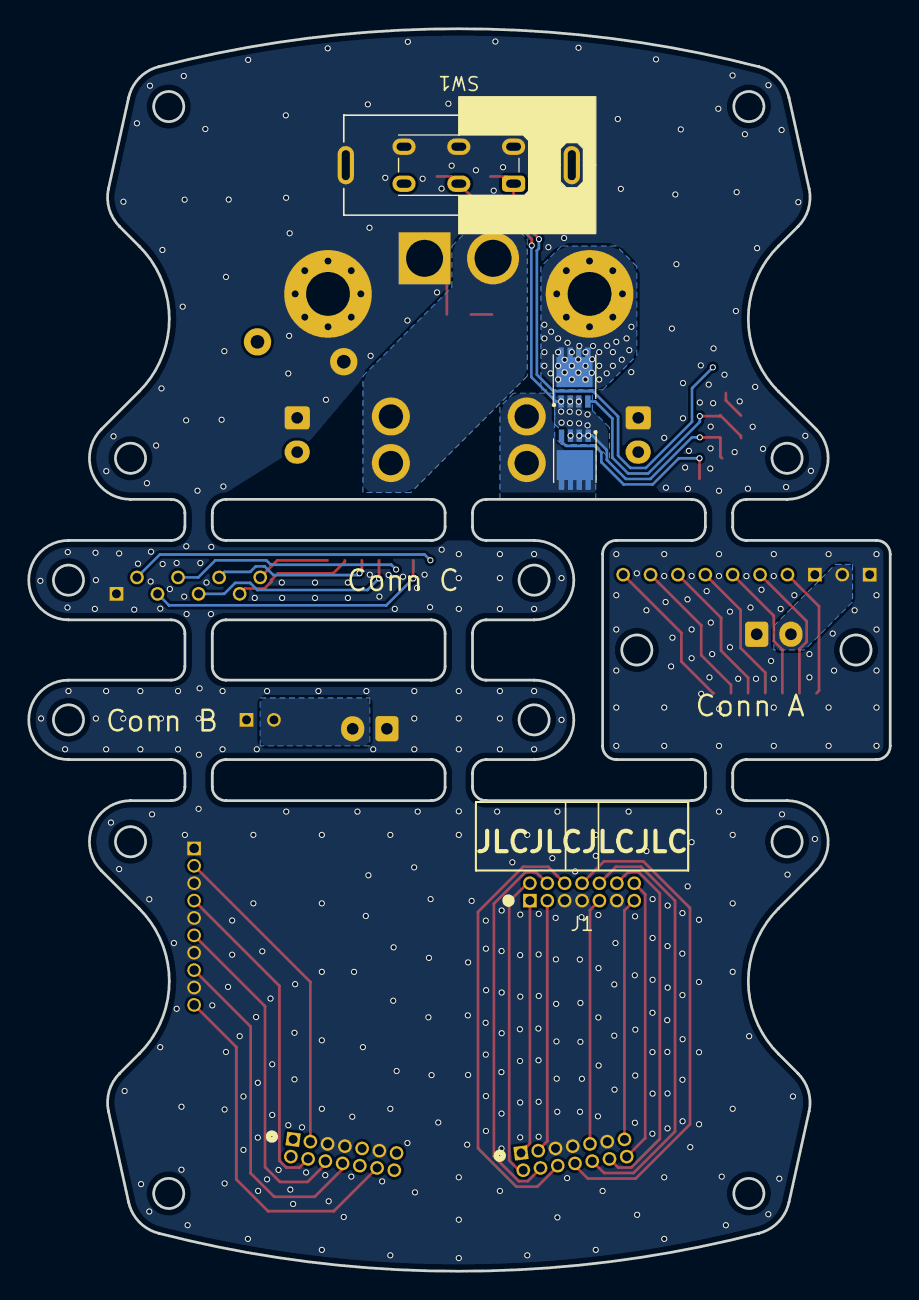
[picture p63: board 1stLayer_Power.kicad_pcb from below]

Board: 2 copper layers, 62.9 x 90.7 mm, 53 parts (4 on the bottom side), 37 nets.

Parts:
C1, C4: 330uF; C_Elec_8x10.2
C3: 1uF; C_0603_1608Metric
D2: 1N5819WS; D_SOD-323_HandSoldering
D3: Green; LED_0603_1608Metric_Pad1.05x0.95mm_HandSolder
F2: Fuse; Fuseholder_Blade_Mini_Keystone_3568
H1, H2: MountingHole_Pad; MountingHole_3.2mm_M3_Pad_Via
H3, H11, H19, H21: MountingHole_Pad; Pad_THTPad_1.0x1.0mm_Drill0.65mm
H4, H5, H6, H7, H8, H9, H10, H12, H13, H14, H15, H16, H17, H18, H20, H22: MountingHole_Pad; Pad_THTPad_D1.0mm_Drill0.65mm
J1, J2, J3: Conn_01x14_Pin; BoxHeader_2x07_P1.27mm_Horizontal
J4: Conn_01x02_Male; AMASS_XT30U-M_1x02_P5.0mm_Vertical
J5, J6, J8, J9: Conn_01x02_Male; Molex_SPOX_5267-02A_1x02_P2.50mm_Vertical
J7, J10: Conn_01x08_MountingPin; Molex_PicoBlade_53398-0871_1x08-1MP_P1.25mm_Vertical
J11: Conn_01x10_Socket; PinSocket_1x10_P1.27mm_Vertical
Q1: 2N7002; SOT-23
Q4, Q6: SQS141ELNW; Package_TSON-Advance
R3: 100k; R_0603_1608Metric
R5, R6, R7, R8, R9, R10: 10k; R_0603_1608Metric
R11: 20k; R_0603_1608Metric
SW1: SW_SPDT; SW_Slide_DPDT_SS22F06G5-G
TP1, TP2: TestPoint; TestPoint_THTPad_D2.0mm_Drill1.0mm

Connections:
+BATT: F2.1, J4.2
/1stLayer/3.3V_Drive: J1.3, J2.3
/1stLayer/3.3V_Wireless: J3.3, J11.2
/Conn1/Panel_PWRCtrl: H10.1, J7.8
/Conn1/RS485_Panel0: H4.1, J7.2
/Conn1/RS485_Panel1: H5.1, J7.3
/Conn1/RS485_Panel2: H6.1, J7.4
/Conn1/RS485_Panel3: H7.1, J7.5
/Conn1/RS485_Panel4: H8.1, J7.6
/Conn1/RS485_Panel5: H9.1, J7.7
/Conn3/Panel_PWRCtrl: H18.1, J10.8
/Conn3/RS485_Panel0: H12.1, J10.2
/Conn3/RS485_Panel1: H13.1, J10.3
/Conn3/RS485_Panel2: H14.1, J10.4
/Conn3/RS485_Panel3: H15.1, J10.5
/Conn3/RS485_Panel4: H16.1, J10.6
/Conn3/RS485_Panel5: H17.1, J10.7
/Power/PowerSW: Q1.1 (G), R3.1, SW1.1 (A)
/Power/S-S: C3.1, Q4.1 (S), Q4.2 (S), Q4.3 (S), Q6.1 (S), Q6.2 (S), Q6.3 (S), R5.1, R8.1, R9.1
GND: C1.2, C4.2, D2.2 (A), D3.1 (K), H1.1, H3.1, H11.1, H19.1, H21.1, J1.5, J1.7, J1.11, J2.5, J2.7, J2.11, J3.5, J3.7, J3.11, J4.1, J5.1, J6.1, J7.1, J7.MP (MountPin), J8.1, J9.1, J10.1, J10.MP (MountPin), J11.1, J11.3, J11.5, J11.7, J11.9, Q1.2 (S), R3.2, R6.2, R7.2, SW1.4 (C), SW1.5 (A), SW1.6 (A), SW1.SH (A), TP2.1
NRST_Drive: J1.12, J2.12
NRST_Wireless: J3.12, J11.10
unnamed: D3.2 (A), R11.1
unnamed: H20.1, J8.2
unnamed: H22.1, J9.2
unnamed: Q1.3 (D), R10.2
unnamed: F2.2, Q4.5 (D)
unnamed: Q4.4 (G), R7.1, R8.2
unnamed: C3.2, Q6.4 (G), R9.2, R10.1
unnamed: R5.2, R6.1, SW1.2 (B)
SWCLK_Drive: J1.6, J2.6
SWCLK_Wireless: J3.6, J11.6
SWDIO_Drive: J1.4, J2.4
SWDIO_Wireless: J3.4, J11.4
SWO_Drive: J1.8, J2.8
SWO_Wireless: J3.8, J11.8
VDD: C1.1, C4.1, D2.1 (K), H2.1, J5.2, J6.2, Q6.5 (D), R11.2, TP1.1
