Tomoshibi-technology/MovingDisplay3-Circuit/circuits/Imposition/2ndLayer_3rdLayer/2ndLayer_3rdLayer.kicad_pcb

## KiCad design circuits/Imposition/2ndLayer_3rdLayer/2ndLayer_3rdLayer.kicad_pcb (continued)

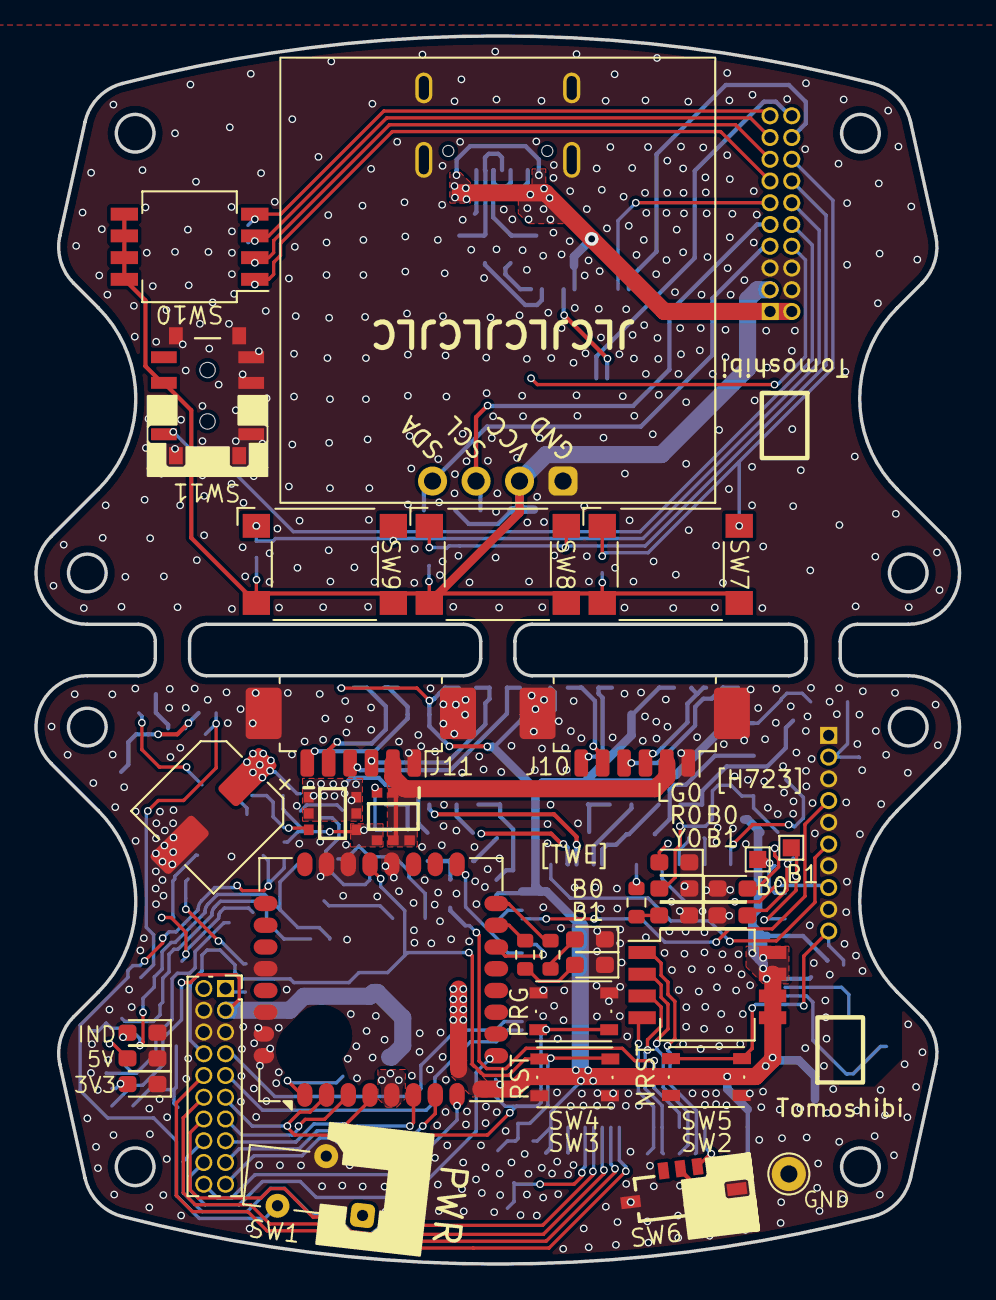
[picture p72: board 2ndLayer_3rdLayer.kicad_pcb from above]

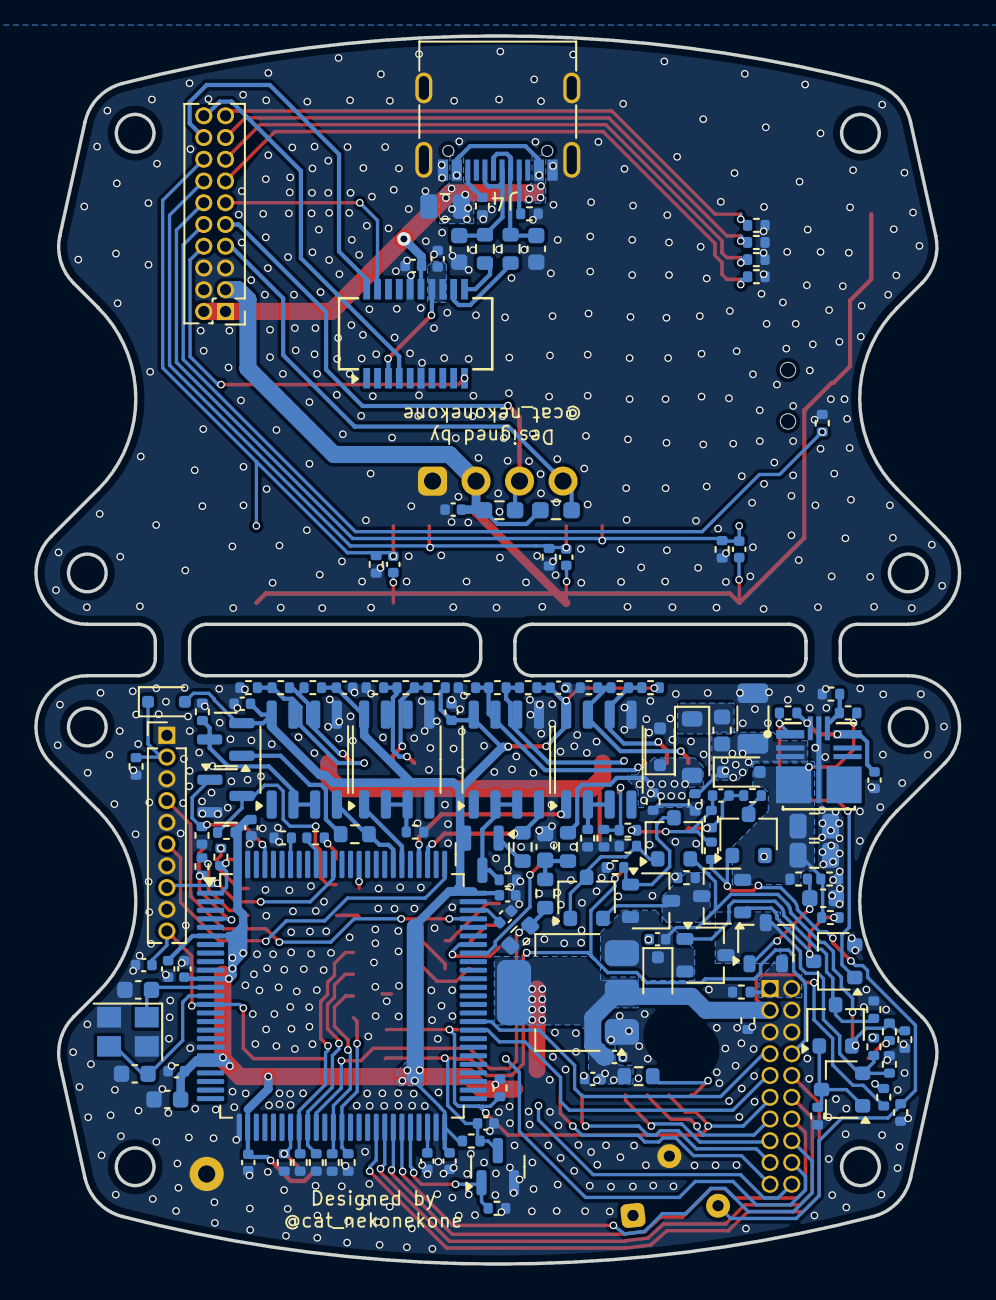
[picture p73: board 2ndLayer_3rdLayer.kicad_pcb from below]

Board: 2 copper layers, 53.9 x 71.7 mm, 181 parts (146 on the bottom side), 118 nets.
