Tomoshibi-technology/MovingDisplay3-Circuit/circuits/Wireless/1stLayer/1stLayer.kicad_sch

## KiCad design circuits/Wireless/1stLayer/1stLayer.kicad_sch (2025-04-04)

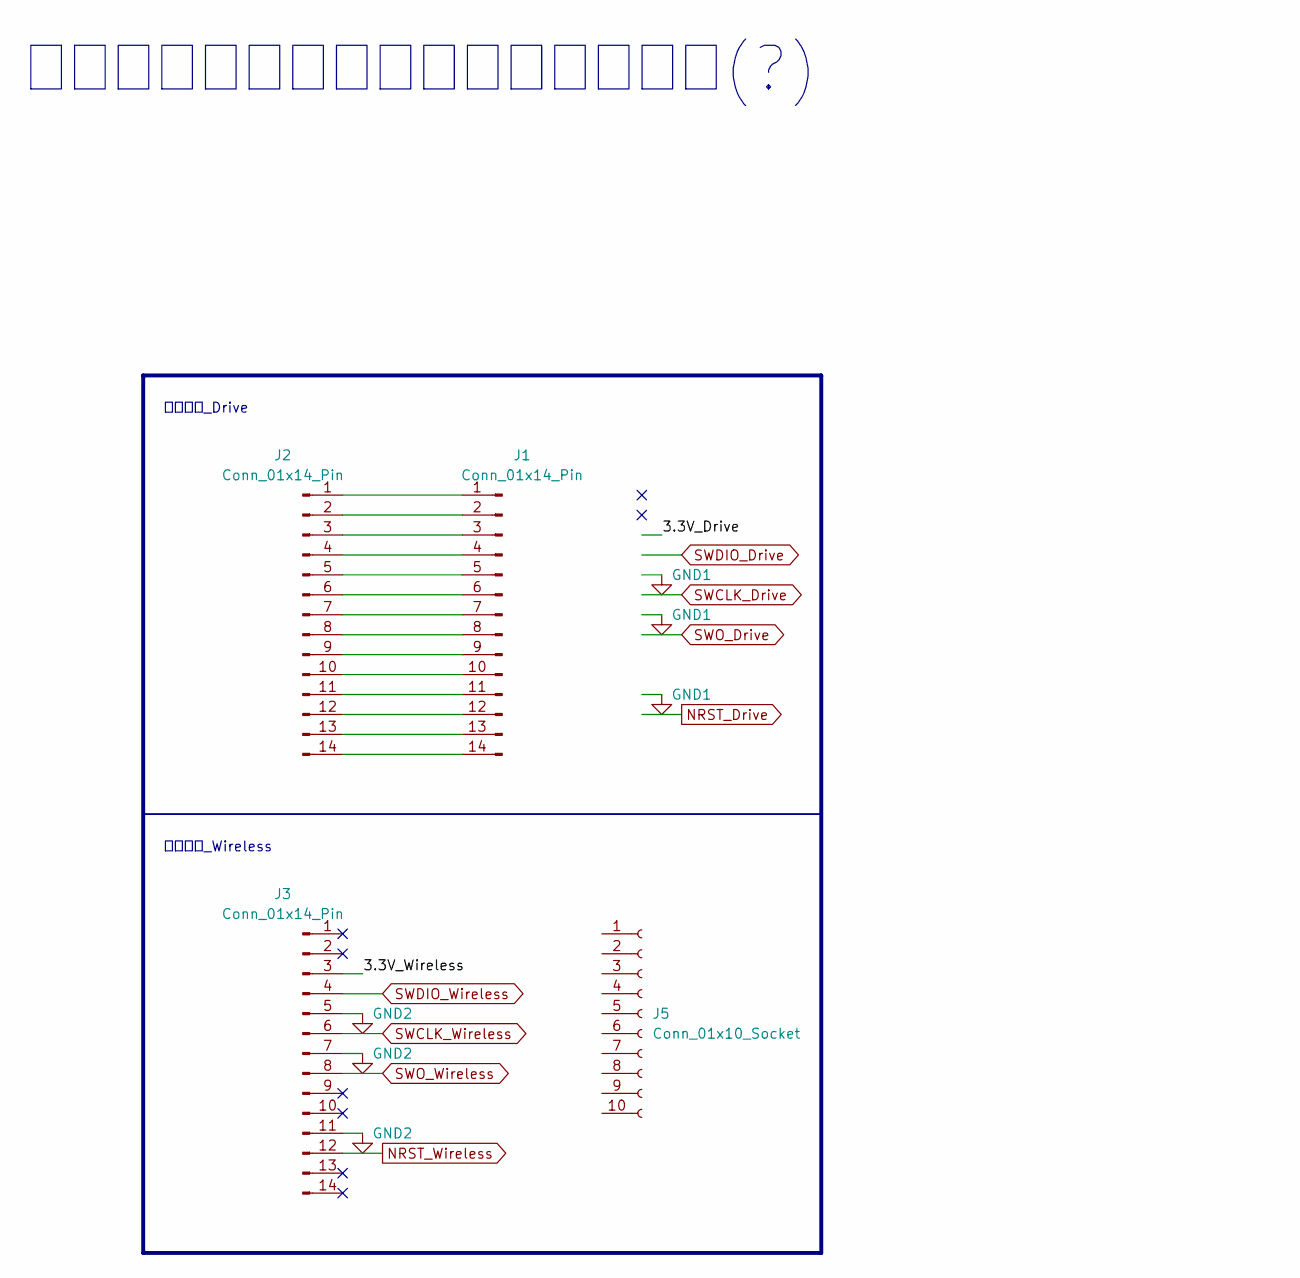
[picture p76: schematic 1stLayer.kicad_sch]

Parts:
J1, J2, J3: Conn_01x14_Pin; BoxHeader_2x07_P1.27mm_Horizontal
J5: Conn_01x10_Socket; PinSocket_1x10_P1.27mm_Vertical

Connections:
3.3V_Wireless: J3.3
GND2: J3.5, J3.7, J3.11
NRST_Wireless: J3.12
unnamed: J1.1, J2.1
unnamed: J1.2, J2.2
unnamed: J1.3, J2.3
unnamed: J1.4, J2.4
unnamed: J1.5, J2.5
unnamed: J1.6, J2.6
unnamed: J1.7, J2.7
unnamed: J1.8, J2.8
unnamed: J1.9, J2.9
unnamed: J1.10, J2.10
unnamed: J1.11, J2.11
unnamed: J1.12, J2.12
unnamed: J1.13, J2.13
unnamed: J1.14, J2.14
SWCLK_Wireless: J3.6
SWDIO_Wireless: J3.4
SWO_Wireless: J3.8

Notes on the sheet:
書き込み_Drive
足回りにつながる書き込みは直付け(?)
書き込み_Wireless
