Tomoshibi-technology/MovingDisplay3-Circuit/circuits/Wireless/2ndLayer/RS485_RingNW.kicad_sch

## KiCad design circuits/Wireless/2ndLayer/RS485_RingNW.kicad_sch (2025-03-03)


Parts:
C11, C18, C20, C23: 0.1uF; C_0402_1005Metric
J10, J11: Conn_01x06_MountingPin; Molex_PicoBlade_53261-0671_1x06-1MP_P1.25mm_Horizontal
Q13, Q14: S8550; SOT-23
R4, R48: 7.5k; R_0603_1608Metric
R5, R49: 20k; R_0402_1005Metric
R36, R50: 10k; R_0402_1005Metric
R42, R43, R44, R45, R51, R52, R53, R54: 2.2k; R_0402_1005Metric
R46, R47, R55, R56: 120; R_0402_1005Metric
U3, U4, U5, U6: MAX3485; SOP-8_3.9x4.9mm_P1.27mm

Connections:
+3.3V: C11.1, C18.1, C20.1, C23.1, Q13.2 (E), Q14.2 (E), R42.1, R44.1, R51.1, R53.1, U3.8 (VCC), U4.8 (VCC), U5.8 (VCC), U6.8 (VCC)
+BATT: J10.2, J11.2
GNDD: C11.2, C18.2, C20.2, C23.2, J10.1, J10.MP (MountPin), J11.1, J11.MP (MountPin), R5.2, R36.2, R43.2, R45.2, R49.2, R50.2, R52.2, R54.2, U3.5 (GND), U4.5 (GND), U5.5 (GND), U6.5 (GND)
MainRX_RS485X_TX: U4.1 (RO)
MainRX_RS485Y_TX: U6.1 (RO)
MainTX_RS485X_RX: R4.2, U3.4 (DI)
MainTX_RS485Y_RX: R48.2, U5.4 (DI)
unnamed: Q13.1 (B), R4.1
unnamed: Q13.3 (C), R5.1, U3.2 (~RE), U3.3 (DE)
unnamed: Q14.1 (B), R48.1
unnamed: Q14.3 (C), R49.1, U5.2 (~RE), U5.3 (DE)
unnamed: R36.1, U4.2 (~RE), U4.3 (DE)
unnamed: R50.1, U6.2 (~RE), U6.3 (DE)
RS485X_RA: J10.5, R44.2, R47.1, U4.6 (A)
RS485X_RB: J10.6, R45.1, R47.2, U4.7 (B)
RS485X_TA: J10.3, R42.2, R46.1, U3.6 (A)
RS485X_TB: J10.4, R43.1, R46.2, U3.7 (B)
RS485Y_RA: J11.5, R53.2, R56.1, U6.6 (A)
RS485Y_RB: J11.6, R54.1, R56.2, U6.7 (B)
RS485Y_TA: J11.3, R51.2, R55.1, U5.6 (A)
RS485Y_TB: J11.4, R52.1, R55.2, U5.7 (B)

Notes on the sheet:
RS485_RingNW_X
RS485_RingNW_Y
MAX3485_Tx(3,4Pin)
MAX3485_Rx(5,6Pin)
Conn
