Tomoshibi-technology/MovingDisplay3-Circuit/(commit log)

2025-02-17 プロジェクト作成
    [1stLayer.kicad_pcb, 1stLayer.kicad_sch, 2ndLayer.kicad_pcb, 2ndLayer.kicad_sch, 3rdLayer.kicad_pcb, 3rdLayer.kicad_sch, Amp.kicad_pcb, Amp.kicad_sch]
2025-02-24 Driveほぼ完成
    [BNO055.kicad_sch, Drive.kicad_sch, Mouse.kicad_sch, Power.kicad_sch, RS485.kicad_sch, RS485_MD.kicad_sch, RS485_RingNW.kicad_sch, UI.kicad_sch]
2025-02-28 無線&UI完成？
    [1stLayer.kicad_sch, 2ndLayer.kicad_sch, 3rdLayer.kicad_sch, BNO055.kicad_sch, Drive.kicad_sch, FPGA_TangPrimerCore.kicad_sch, Mouse.kicad_sch, Power.kicad_sch]
2025-03-03 ラズパイ基板とか
    [2ndLayer.kicad_sch, 3rdLayer.kicad_sch, Amp.kicad_sch, BNO055.kicad_sch, Drive.kicad_sch, FPGA_TangPrimerCore.kicad_sch, Mouse.kicad_sch, Panel.kicad_sch]
2025-03-27 PDFプロット
    [2ndLayer.kicad_sch, DAC.kicad_sch, Drive.kicad_sch, Ethernet.kicad_sch, FAN.kicad_sch, FPGA_TangPrimerCore.kicad_sch, Power.kicad_sch, RS485_Panel.kicad_sch]
2025-04-04 panelフットプリント配置
    [DCDC.kicad_pcb, DCDC.kicad_sch, Ethernet.kicad_sch, LiDAR.kicad_sch, NeoPixel.kicad_sch, Panel.kicad_sch, Pass_con.kicad_sch, Power.kicad_sch]
2025-04-04 シンボル・フットプリントMyLib->TomoshibiLib置き換え
    [1stLayer.kicad_pcb, 1stLayer.kicad_sch, 2ndLayer.kicad_pcb, 3rdLayer.kicad_pcb, 3rdLayer.kicad_sch, BNO055.kicad_sch, DAC.kicad_sch, Drive.kicad_pcb]
2025-04-05 配線おけ
    [Panel.kicad_sch, Power.kicad_pcb, RasPi.kicad_pcb]
2025-06-09 raspi基板回路図
    [1stLayer.kicad_pcb, 1stLayer.kicad_sch, 1stLayer_Power.kicad_pcb, 1stLayer_Power.kicad_sch, 2ndLayer.kicad_pcb, 2ndLayer.kicad_sch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]
2025-06-24 発注_第一弾
    Drive, 1stLayer_Power, 2ndLayer_3rdLayer
    を発注
    [1stLayer.kicad_sch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]
2025-07-19 発注第2弾
    RasPi発注
    [1stLayer_Power.xlsx, 2ndLayer_3rdLayer.xlsx, DAC.kicad_sch, Drive.xlsx, Ethernet.kicad_sch, FAN.kicad_sch, FPGA_TangPrimerCore.kicad_sch, LiDAR.kicad_sch]
2025-07-24 バイブコーディング神
2025-09-04 PDF更新
2025-09-16 発注第3弾
    DCDC、MD追加
